shortlab/2024-RadCor-Pb-316/TEM/Phase boundary linescan/Project 2_phase boundary/CO_phase boundary/Line Sum Spectrum.tiff

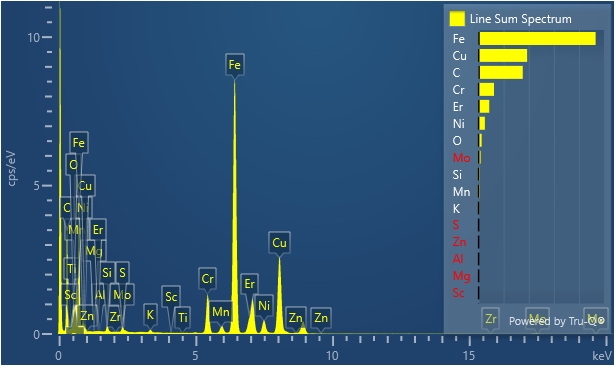
TEM/Phase boundary linescan/Project 2_phase boundary/CO_phase boundary/Line Sum Spectrum.tiff
