shortlab/2024-RadCor-Pb-316/README.md

# 2024-RadCor-Pb-316
Data and image repository for first paper about radiation/corrosion in liquid lead

Software versions used are cited in the manuscript file.
