shortlab/2024-RadCor-Pb-316/EBSD/2.pptx

Phase 4 – Re-Repolished, Re-Recoated and Stored in vacuum

- Sample 1201 02.10.23 Site1:

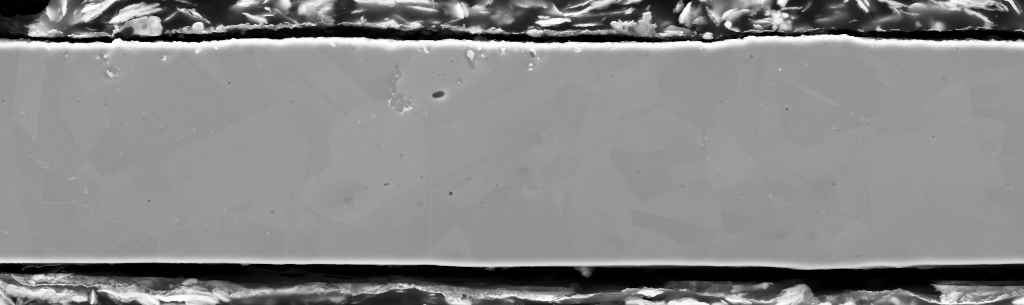
[picture p3: figure]
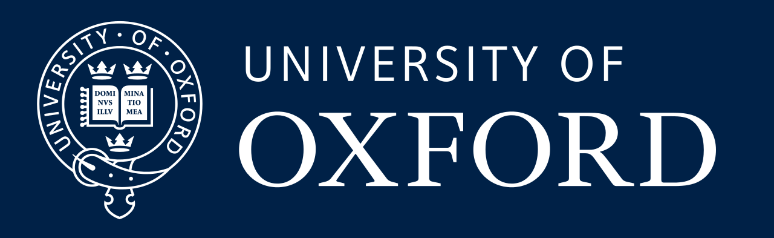
[picture p4: figure]
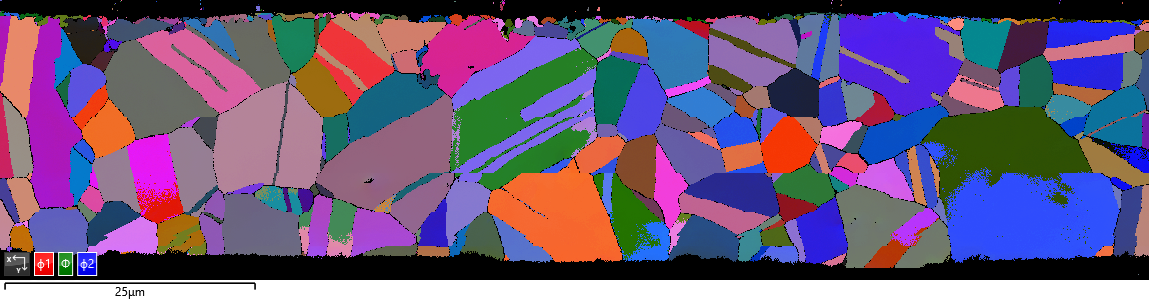
[picture p5: figure]
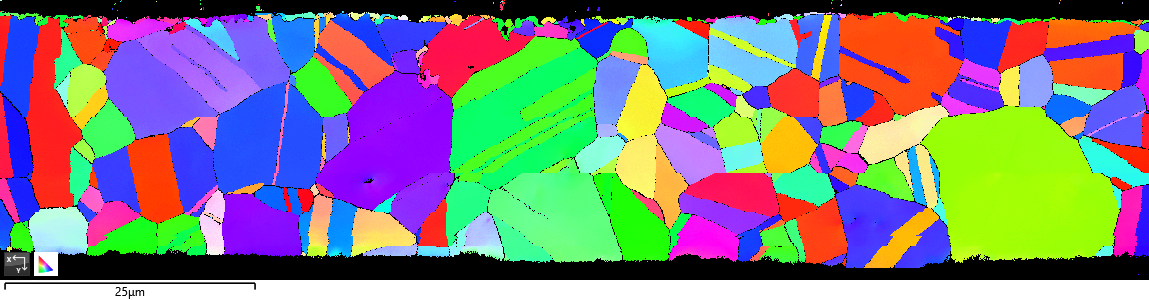
[picture p6: figure]
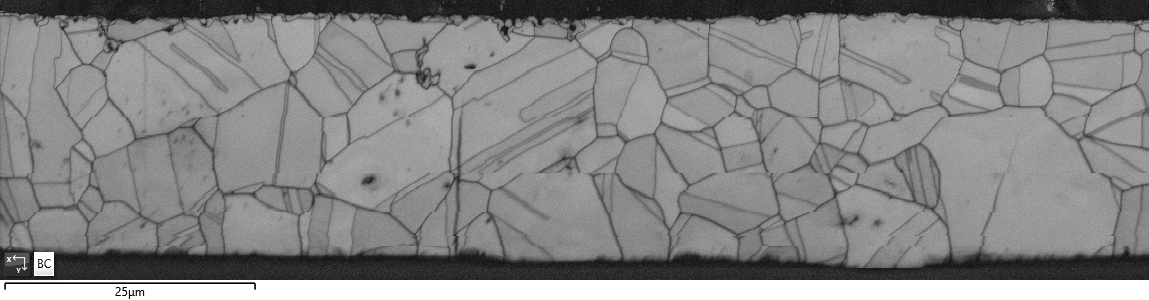
[picture p7: figure]
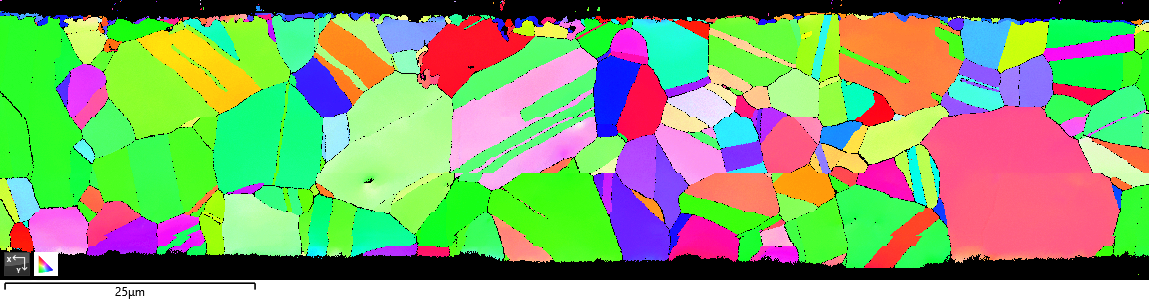
[picture p8: figure]
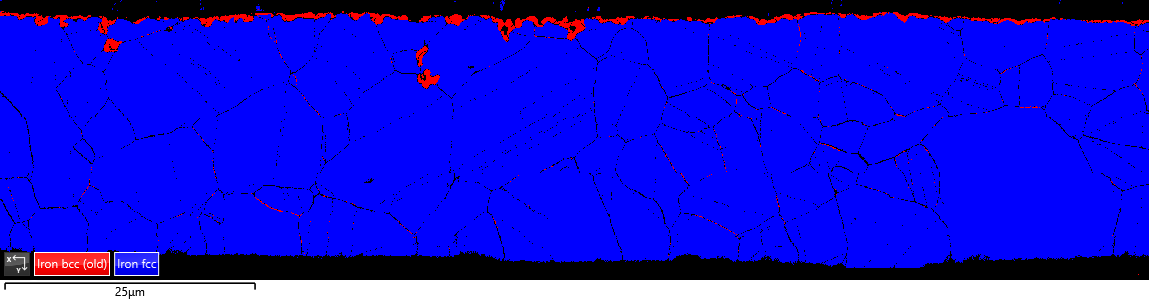
[picture p9: figure]
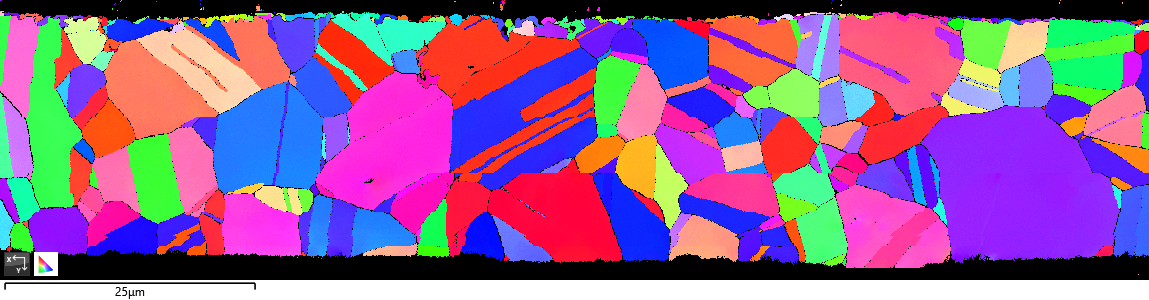
[picture p10: figure]
