shortlab/2024-RadCor-Pb-316/TEM/Maps/RAC/More details.docx

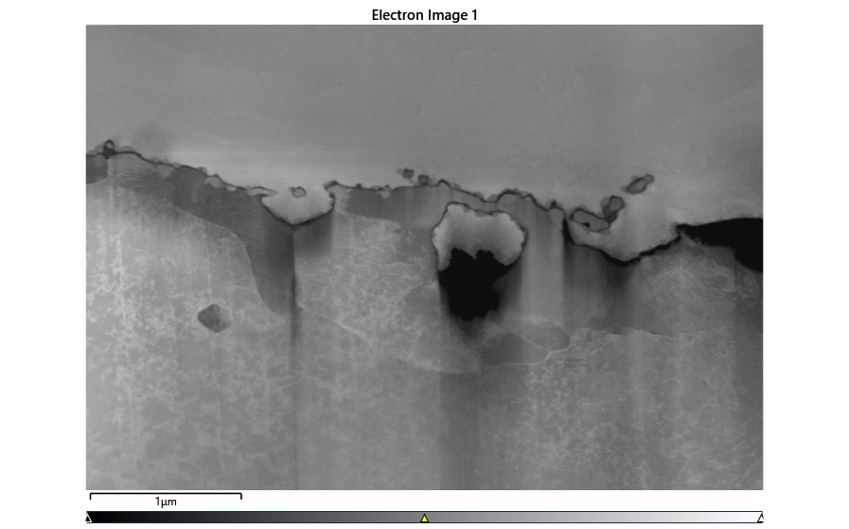
[picture p27: figure]
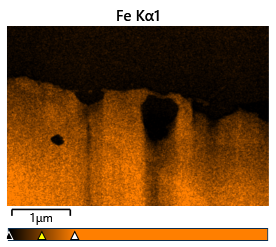
[picture p28: figure]
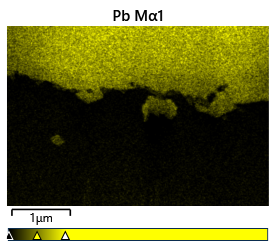
[picture p29: figure]
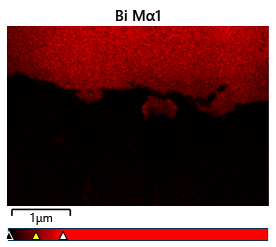
[picture p30: figure]
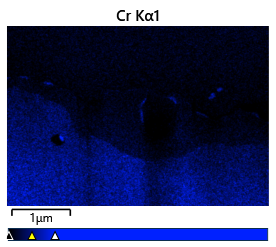
[picture p31: figure]
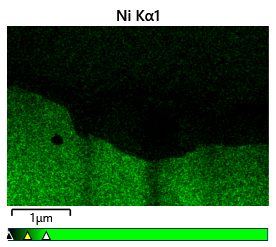
[picture p32: figure]
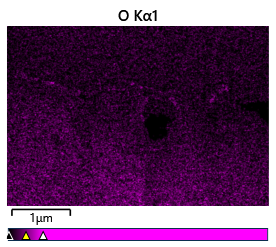
[picture p33: figure]
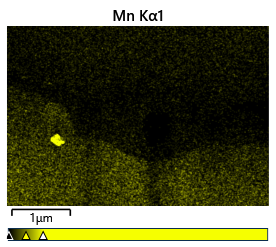
[picture p34: figure]
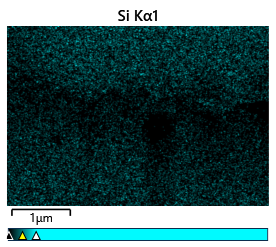
[picture p35: figure]
