shortlab/2024-RadCor-Pb-316/TEM/Maps/RAC/Project 1_Site 1_2024-02-25_21-24-29.docx

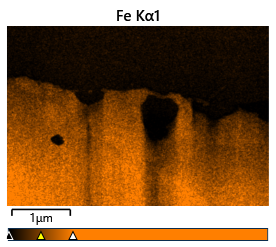
[picture p36: figure]
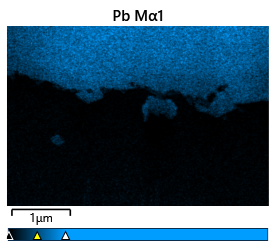
[picture p37: figure]
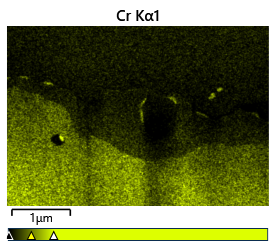
[picture p38: figure]
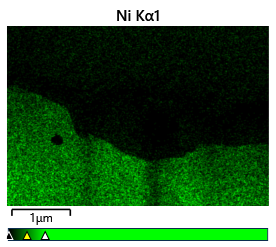
[picture p39: figure]
