shortlab/2024-RadCor-Pb-316/Surface SEM/4hours/CO_/zoomin/Project 1_Site 9_2023-10-23_21-54-53.docx

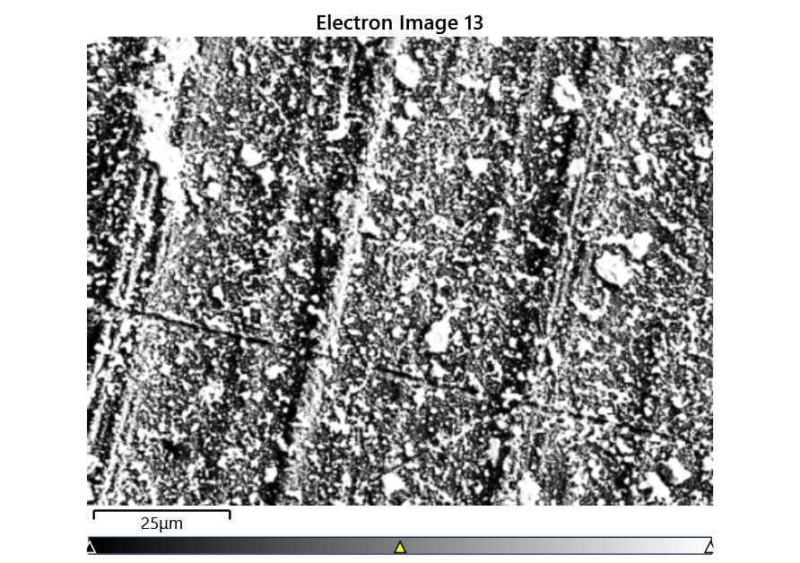
[picture p40: figure]
TemplateImage
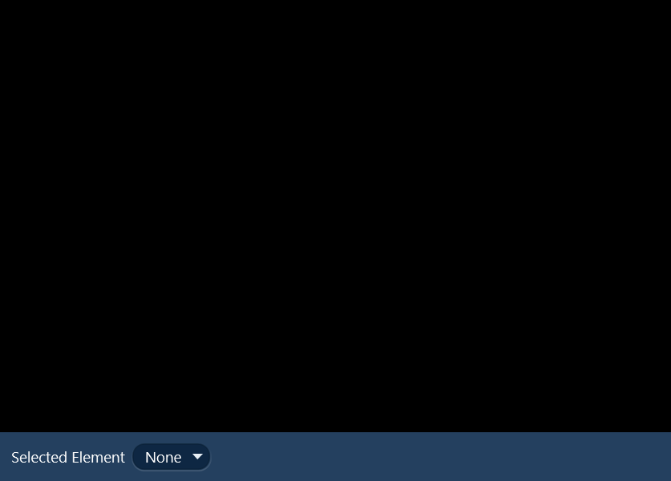
[picture p41: figure]
TemplateImage
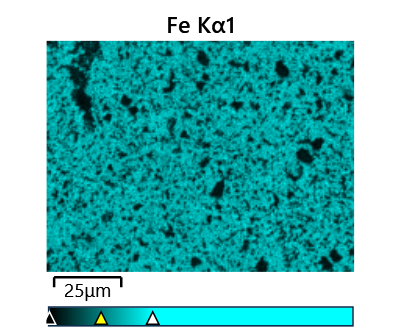
[picture p42: figure]
TemplateImage
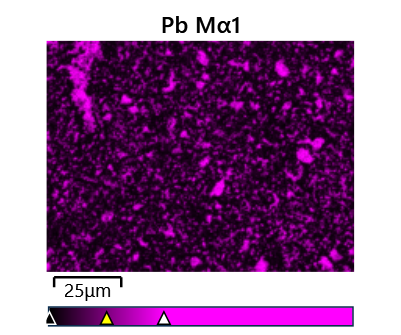
[picture p43: figure]
TemplateImage
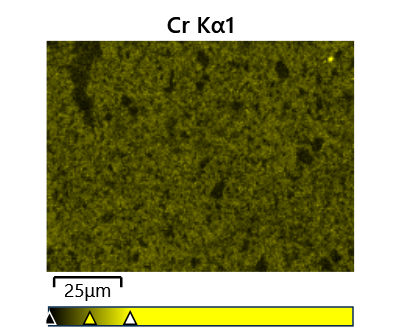
[picture p44: figure]
TemplateImage
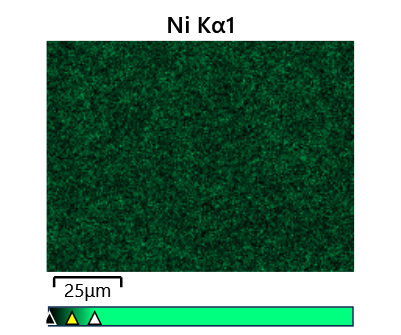
[picture p45: figure]
TemplateImage
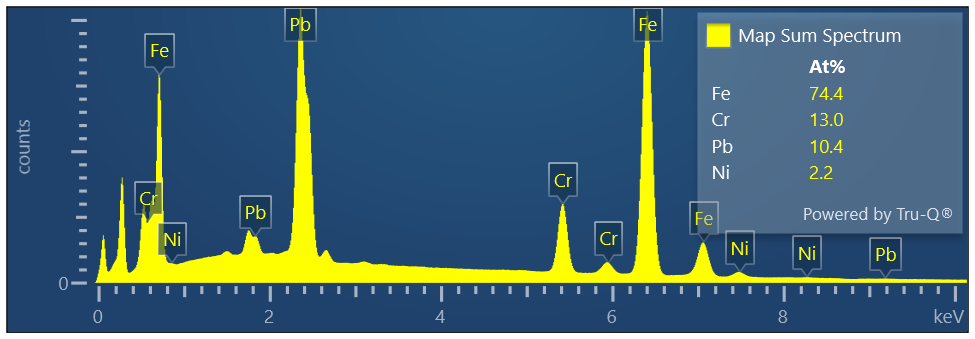
[picture p46: figure]
TemplateImage

Map Sum Spectrum

Element Signal Weight % σ

Fe 58.43 0.05

Pb 30.24 0.05

Cr 9.47 0.02

Ni 1.85 0.03

Map Sum Spectrum

Element Signal Atomic % σ

Fe 74.42

Cr 12.96

Pb 10.38

Ni 2.24
