shortlab/2024-RadCor-Pb-316/Surface SEM/4hours/CO_/zoomout/Project 1_Site 7_2023-10-23_21-45-00.docx

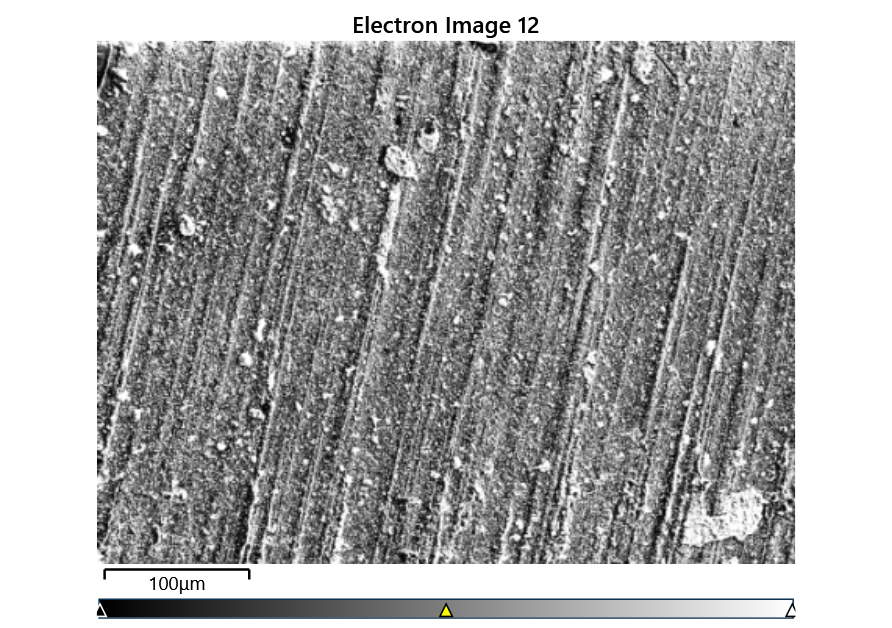
[picture p47: figure]
TemplateImage
TemplateImage
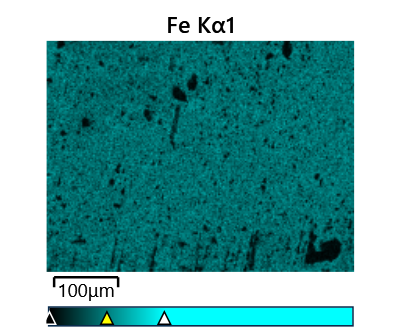
[picture p48: figure]
TemplateImage
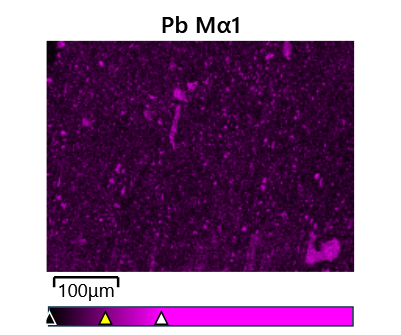
[picture p49: figure]
TemplateImage
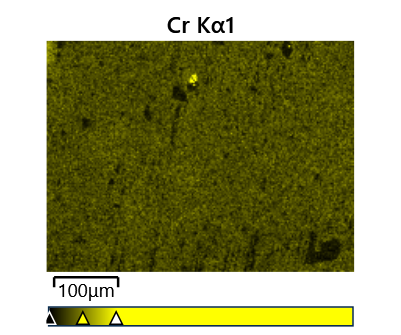
[picture p50: figure]
TemplateImage
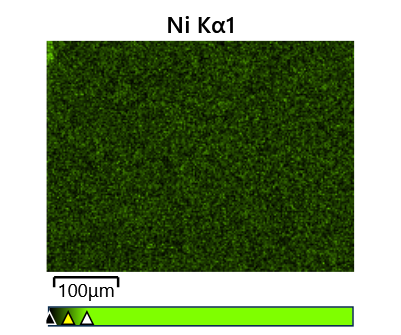
[picture p51: figure]
TemplateImage
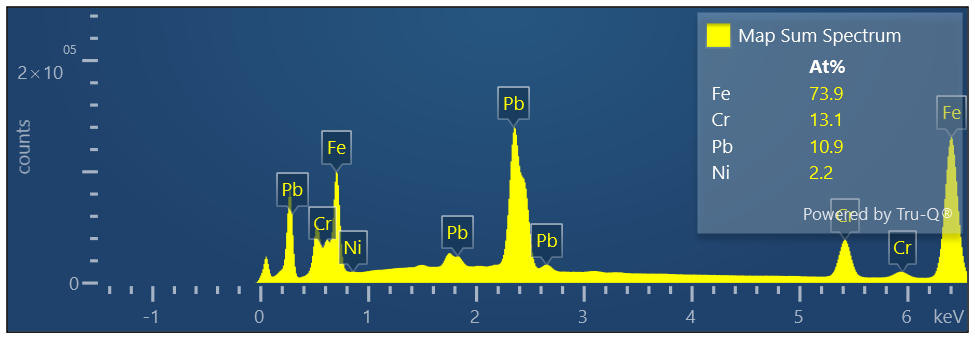
[picture p52: figure]
TemplateImage

Map Sum Spectrum

Element Signal Weight % σ

Fe 57.43 0.06

Pb 31.31 0.06

Cr 9.45 0.03

Ni 1.81 0.03

Map Sum Spectrum

Element Signal Atomic % σ

Fe 73.87

Cr 13.06

Pb 10.86

Ni 2.21
