shortlab/2024-RadCor-Pb-316/Surface SEM/4hours/RAC_/zoomin_/Project 1_Site 8_2023-10-23_21-31-37.docx

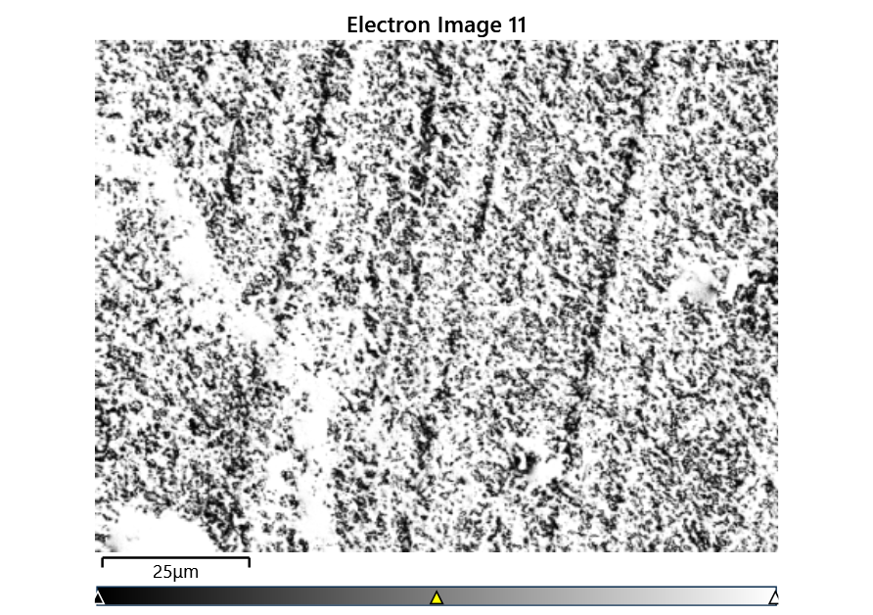
[picture p53: figure]
TemplateImage
TemplateImage
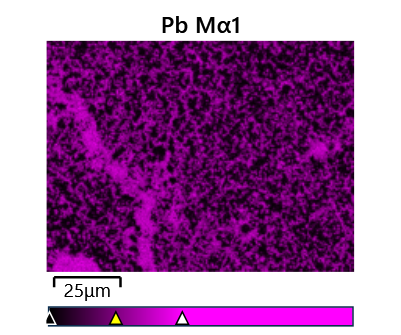
[picture p54: figure]
TemplateImage
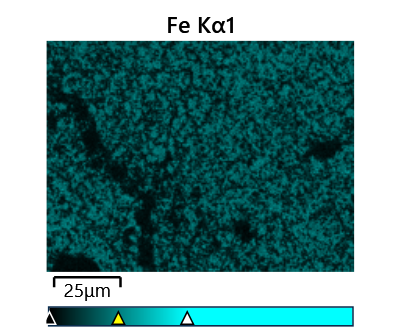
[picture p55: figure]
TemplateImage
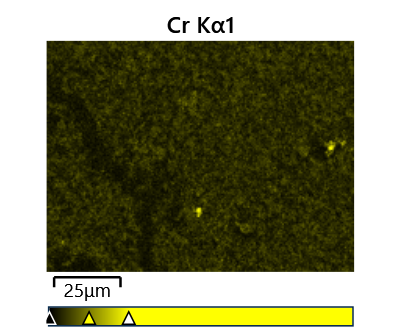
[picture p56: figure]
TemplateImage
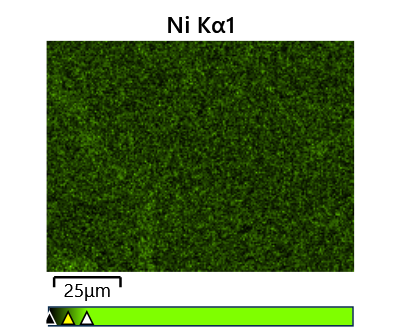
[picture p57: figure]
TemplateImage
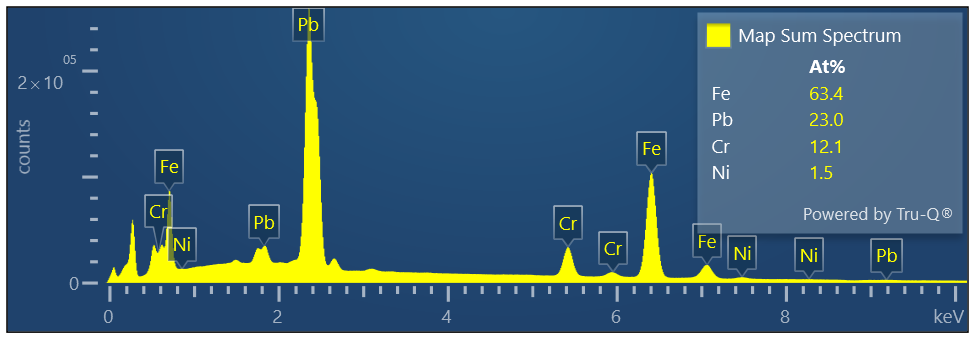
[picture p58: figure]
TemplateImage

Map Sum Spectrum

Element Signal Weight % σ

Pb 52.81 0.05

Fe 39.25 0.05

Cr 6.98 0.02

Ni 0.96 0.03

Map Sum Spectrum

Element Signal Atomic % σ

Fe 63.41

Pb 23.00

Cr 12.11

Ni 1.47
