shortlab/2024-RadCor-Pb-316/Surface SEM/8hours/CO_/zoomin/Project 1_Site 4_2023-10-23_20-40-44.docx

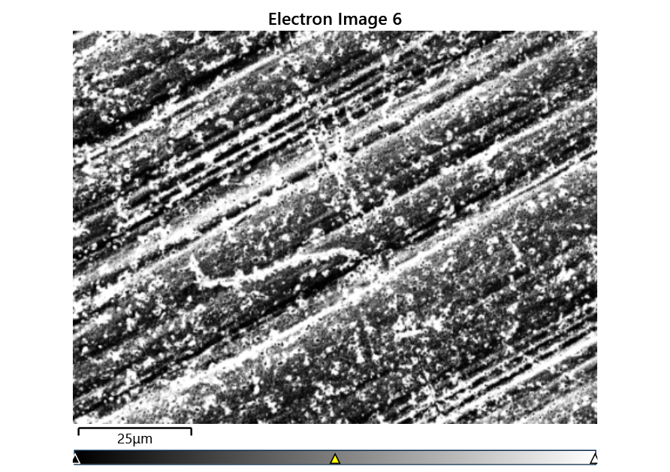
[picture p59: figure]
TemplateImage
TemplateImage
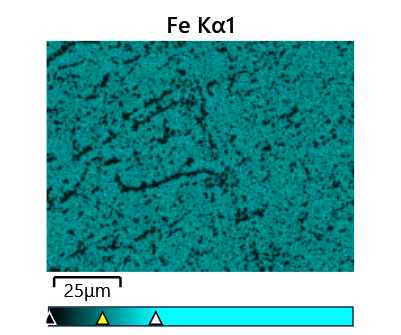
[picture p60: figure]
TemplateImage
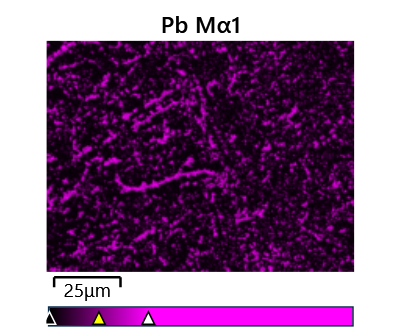
[picture p61: figure]
TemplateImage
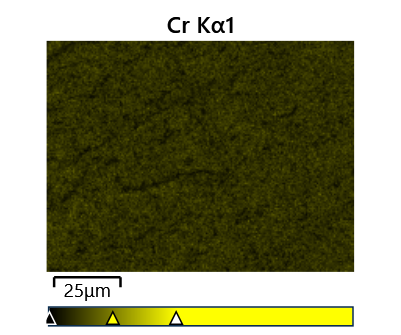
[picture p62: figure]
TemplateImage
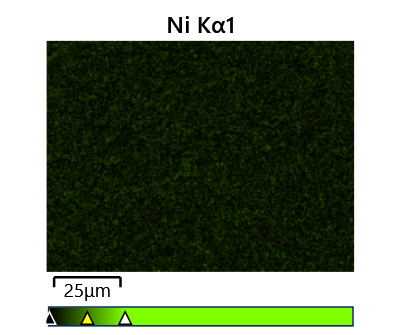
[picture p63: figure]
TemplateImage
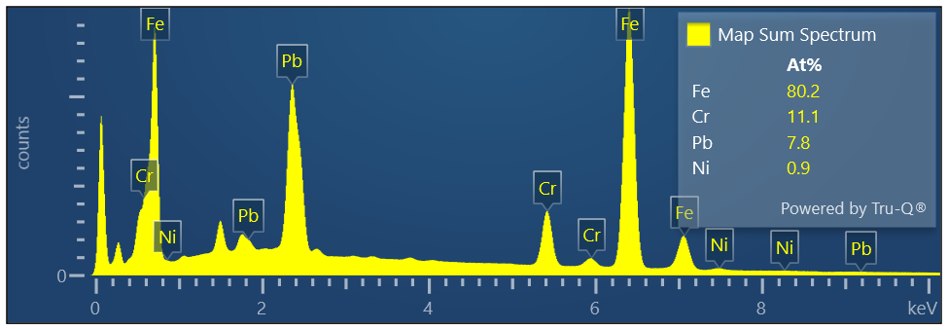
[picture p64: figure]
TemplateImage

Map Sum Spectrum

Element Signal Weight % σ

Fe 66.63 0.06

Pb 23.97 0.05

Cr 8.59 0.03

Ni 0.81 0.03

Map Sum Spectrum

Element Signal Atomic % σ

Fe 80.19

Cr 11.10

Pb 7.77

Ni 0.93
