shortlab/2024-RadCor-Pb-316/Surface SEM/8hours/CO_/zoomout/Project 1_Site 3_2023-10-23_20-37-22.docx

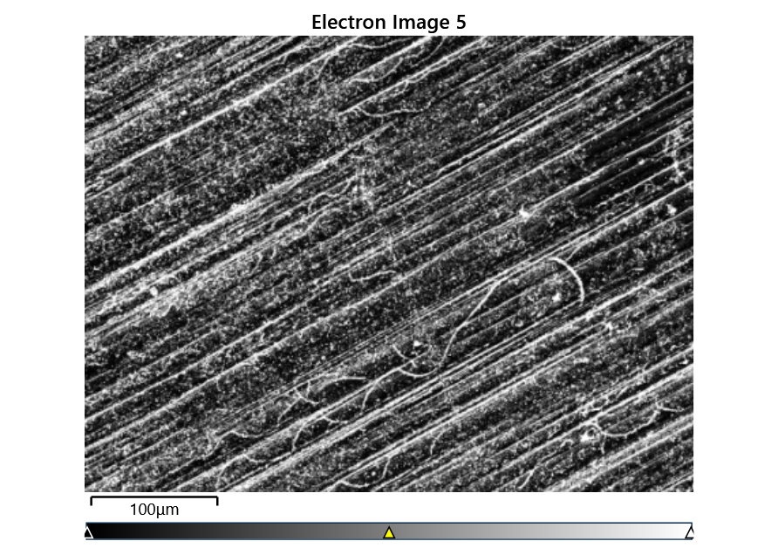
[picture p65: figure]
TemplateImage
TemplateImage
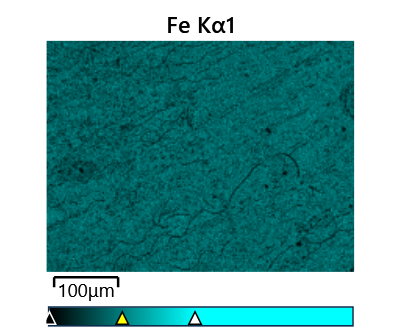
[picture p66: figure]
TemplateImage
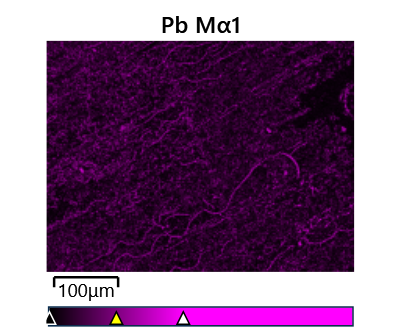
[picture p67: figure]
TemplateImage
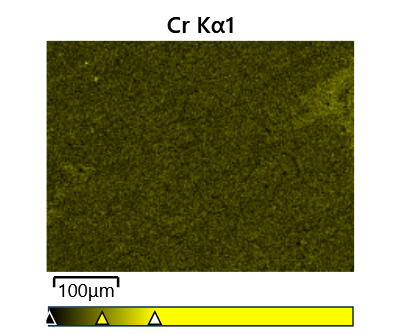
[picture p68: figure]
TemplateImage
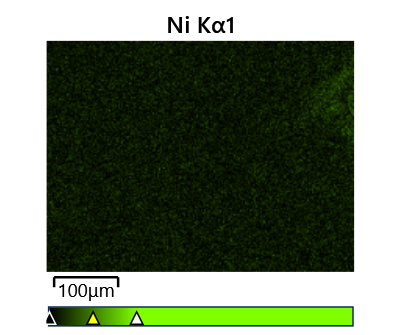
[picture p69: figure]
TemplateImage
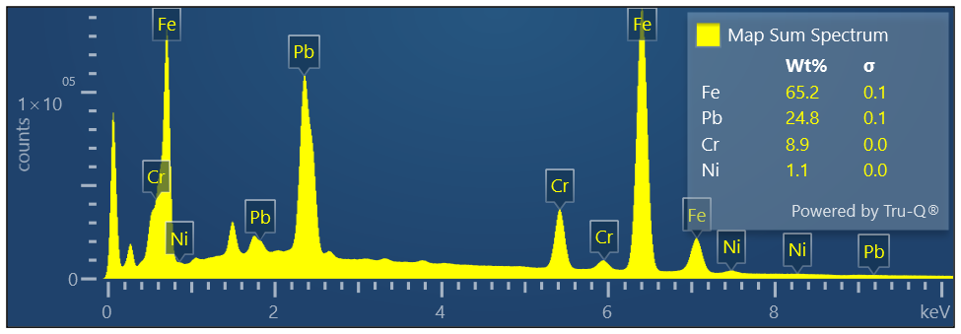
[picture p70: figure]
TemplateImage

Map Sum Spectrum

Element Signal Weight % σ

Fe 65.16 0.06

Pb 24.80 0.05

Cr 8.93 0.03

Ni 1.10 0.03

Map Sum Spectrum

Element Signal Atomic % σ

Fe 78.99

Cr 11.63

Pb 8.10

Ni 1.27
