shortlab/2024-RadCor-Pb-316/Surface SEM/8hours/RAC_/zoomin/Project 1_Site 2_2023-10-23_20-33-59.docx

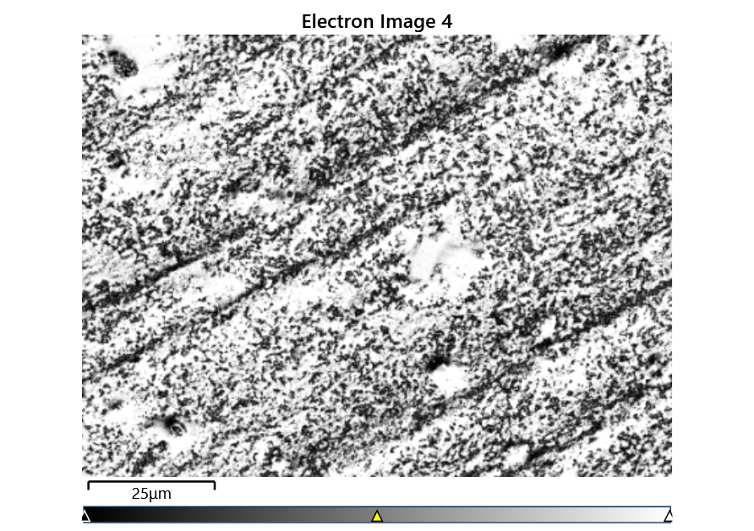
[picture p71: figure]
TemplateImage
TemplateImage
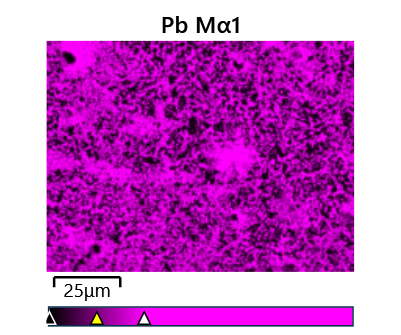
[picture p72: figure]
TemplateImage
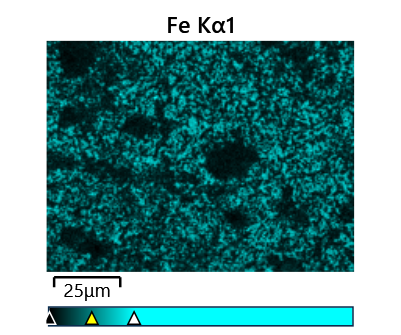
[picture p73: figure]
TemplateImage
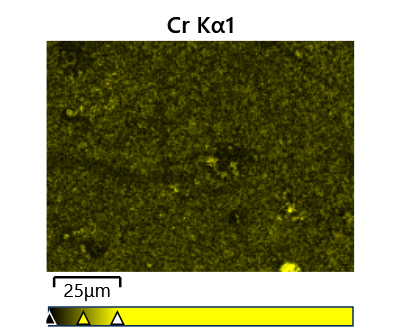
[picture p74: figure]
TemplateImage
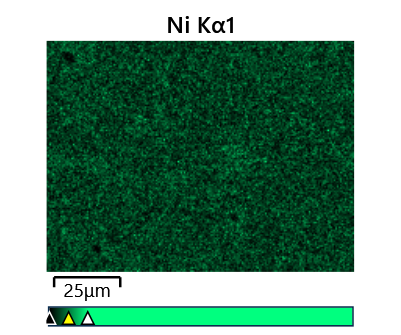
[picture p75: figure]
TemplateImage
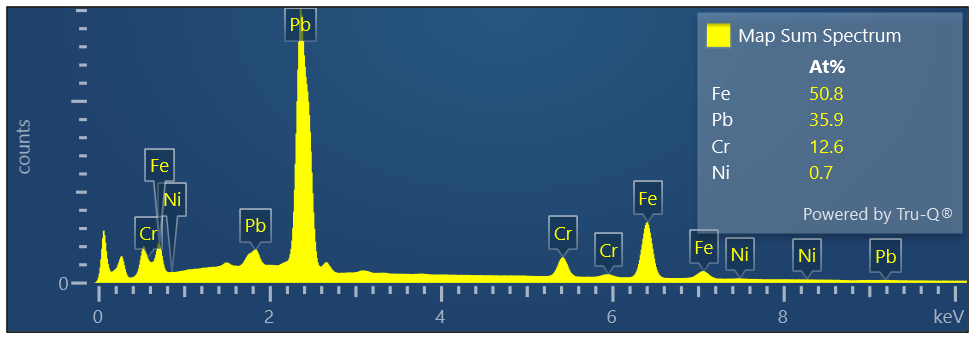
[picture p76: figure]
TemplateImage

Map Sum Spectrum

Element Signal Weight % σ

Pb 67.81 0.05

Fe 25.84 0.04

Cr 5.99 0.02

Ni 0.37 0.03

Map Sum Spectrum

Element Signal Atomic % σ

Fe 50.77

Pb 35.91

Cr 12.63

Ni 0.69
