shortlab/2024-RadCor-Pb-316/Surface SEM/8hours/RAC_/zoomout_1/Project 1_Site 1_2023-10-23_20-28-32.docx

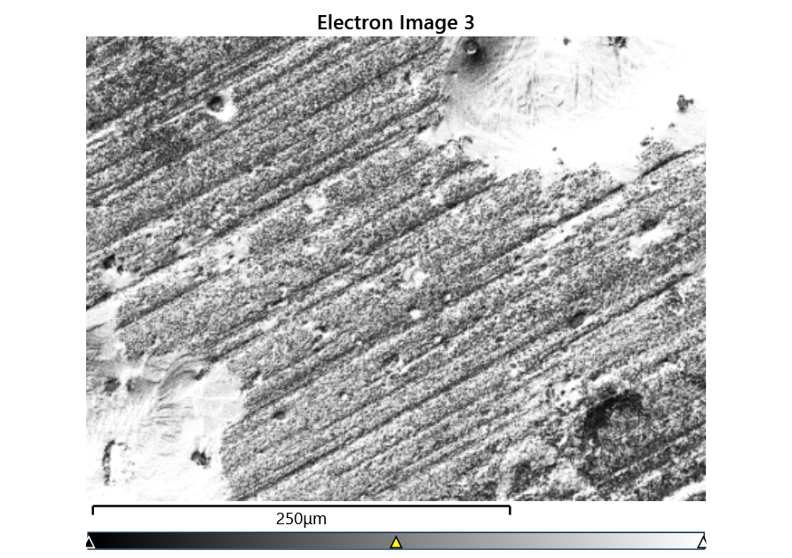
[picture p77: figure]
TemplateImage
TemplateImage
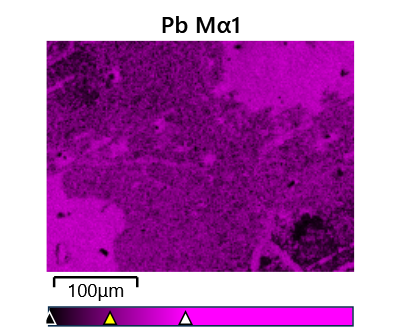
[picture p78: figure]
TemplateImage
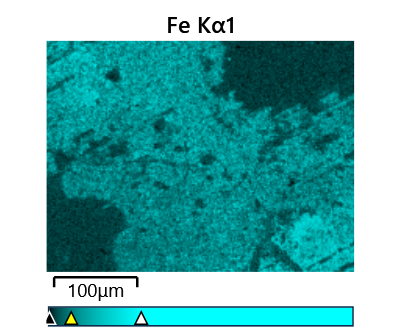
[picture p79: figure]
TemplateImage
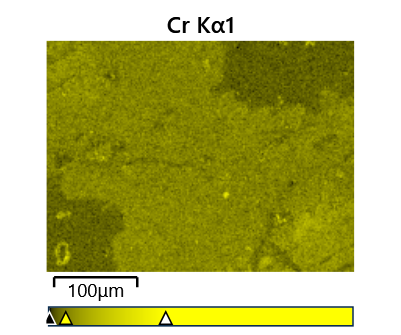
[picture p80: figure]
TemplateImage
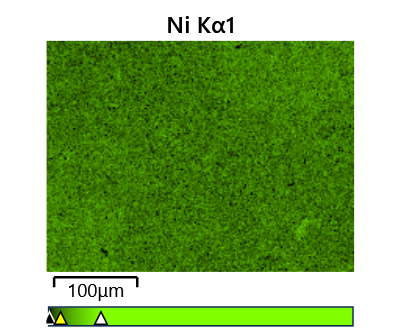
[picture p81: figure]
TemplateImage
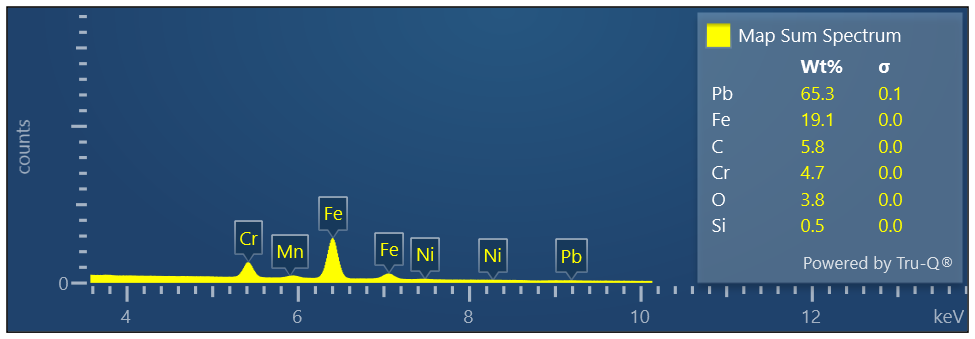
[picture p82: figure]
TemplateImage

Map Sum Spectrum

Element Signal Weight % σ

Pb 73.15 0.05

Fe 21.18 0.04

Cr 5.29 0.02

Ni 0.39 0.03

Map Sum Spectrum

Element Signal Atomic % σ

Fe 45.11

Pb 42.00

Cr 12.10

Ni 0.79
