shortlab/2024-RadCor-Pb-316/TEM/Phase boundary linescan/Project 2_phase boundary/CO_phase boundary/Project 2_Site 5_2023-11-08_15-19-05.docx

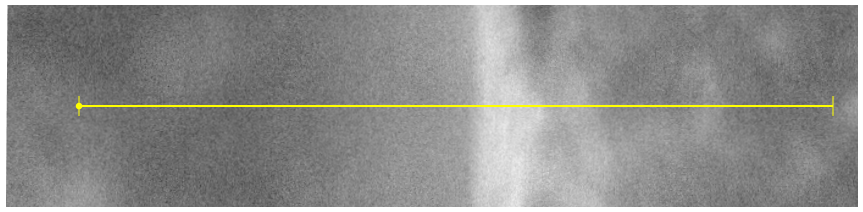
[picture p83: figure]
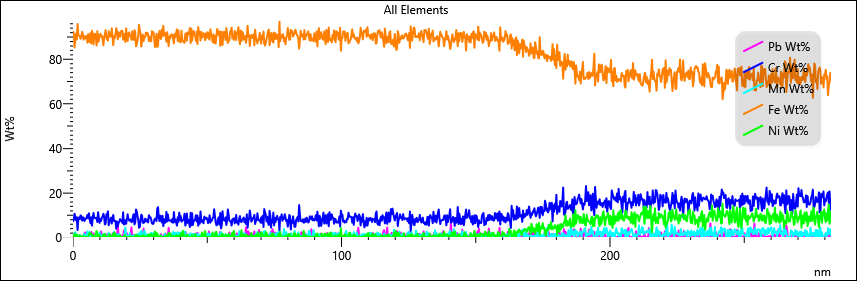
[picture p84: figure]
