shortlab/2024-RadCor-Pb-316/TEM/Phase boundary linescan/Project 2_phase boundary/RAC_phase boundary/1/Project 2_Site 1_2023-11-08_14-36-44.docx

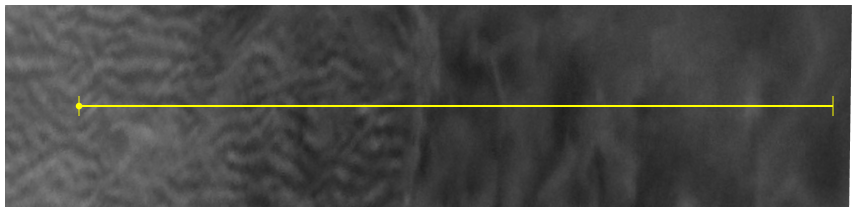
[picture p85: figure]
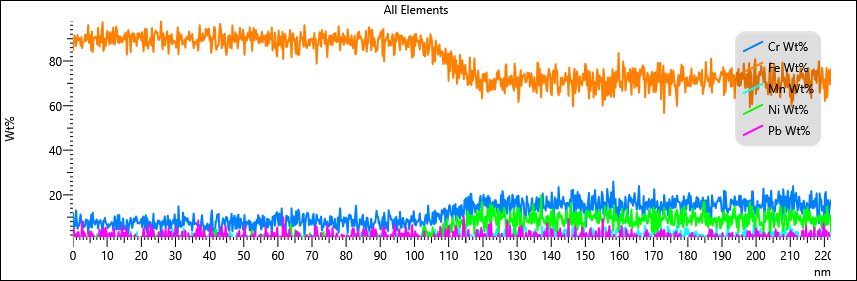
[picture p86: figure]
