shortlab/2024-RadCor-Pb-316/TEM/Phase boundary linescan/Project 2_phase boundary/RAC_phase boundary/2/Project 2_Site 2_2023-11-08_14-49-16.docx

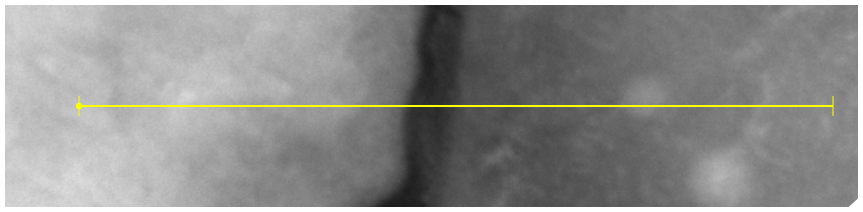
[picture p87: figure]
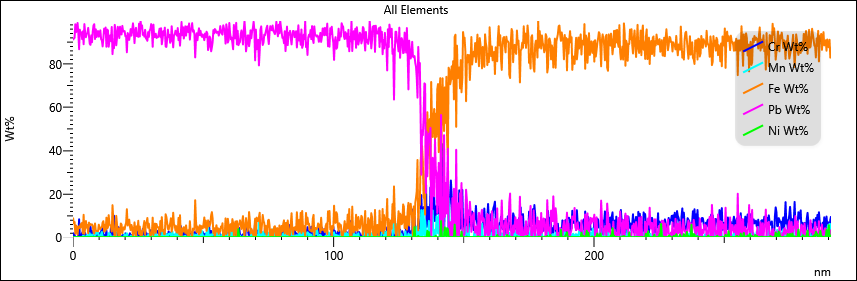
[picture p88: figure]
