shortlab/2024-RadCor-Pb-316/Surface SEM/4hours/CO_/CO_/EDX/CO/Project 1_Site 1_2024-03-19_11-43-02.docx

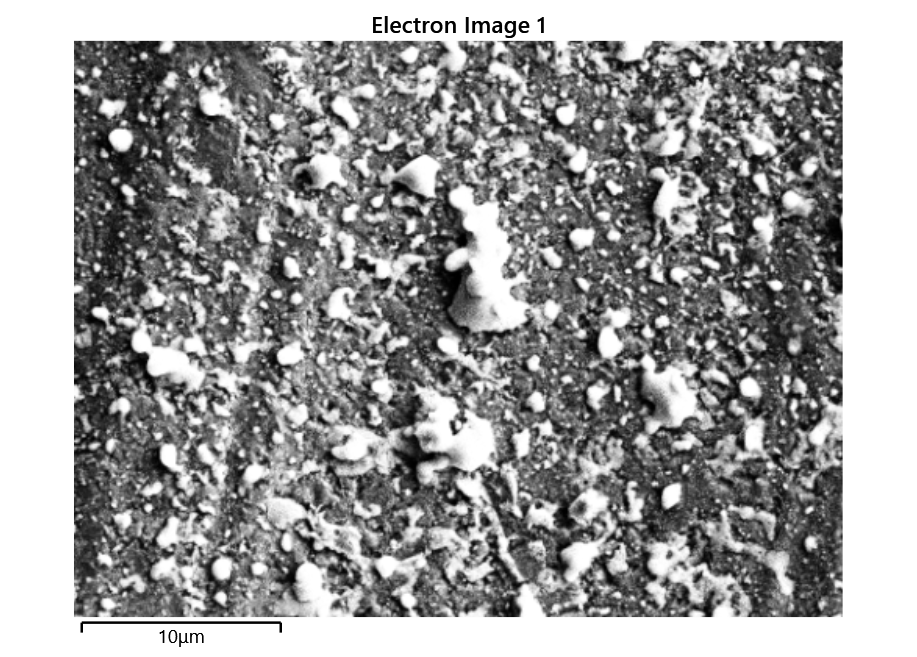
[picture p89: figure]
TemplateImage
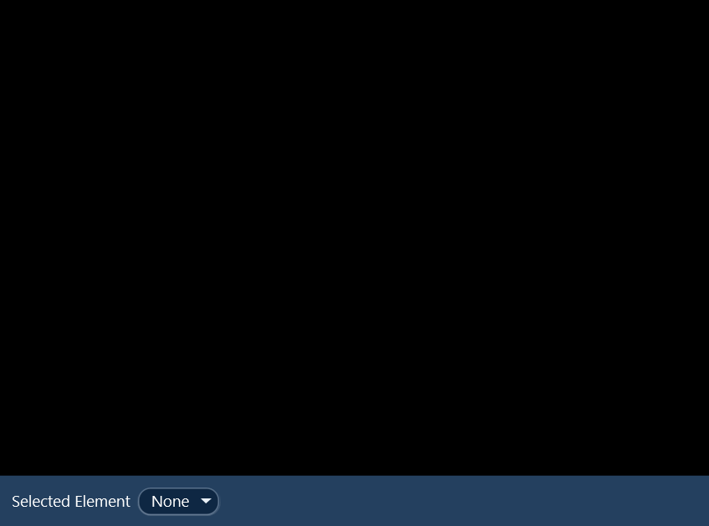
[picture p90: figure]
TemplateImage
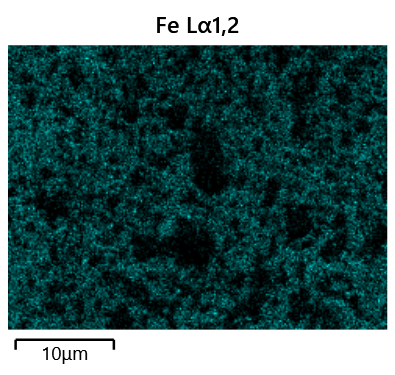
[picture p91: figure]
TemplateImage
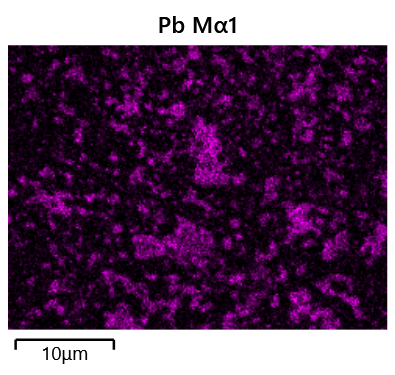
[picture p92: figure]
TemplateImage
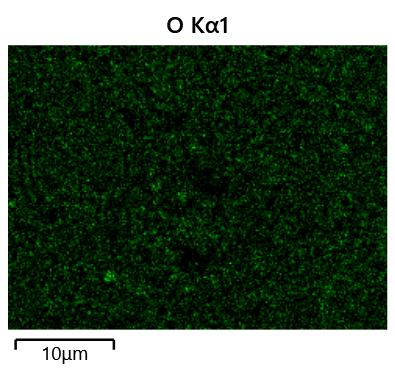
[picture p93: figure]
TemplateImage
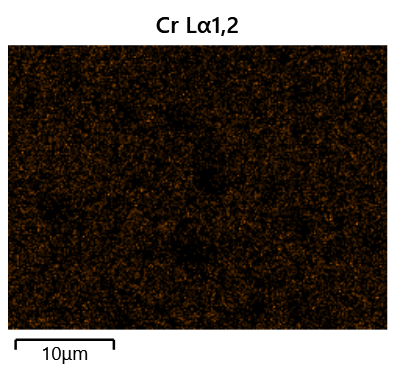
[picture p94: figure]
TemplateImage
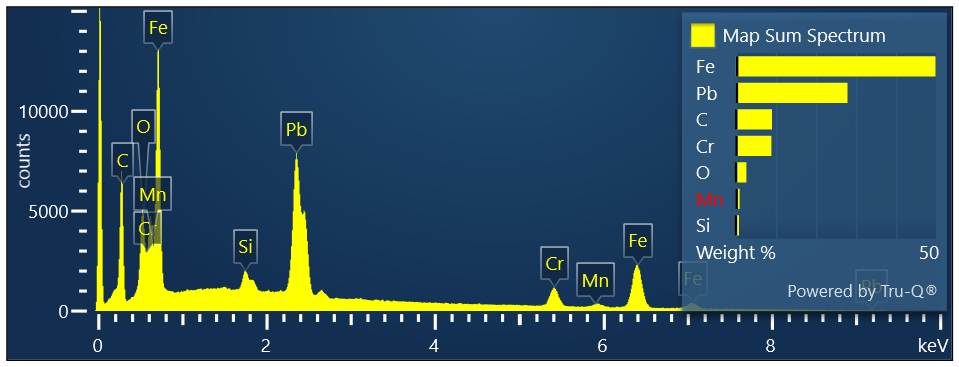
[picture p95: figure]
TemplateImage
