shortlab/2024-RadCor-Pb-316/Surface SEM/4hours/RAC_/RAC/EDX/CO_/Project 1_Site 2_2024-03-18_22-51-43.docx

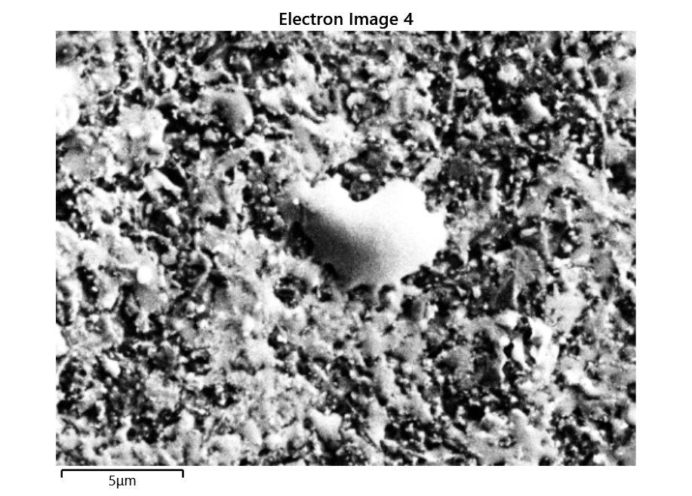
[picture p96: figure]
TemplateImage
TemplateImage
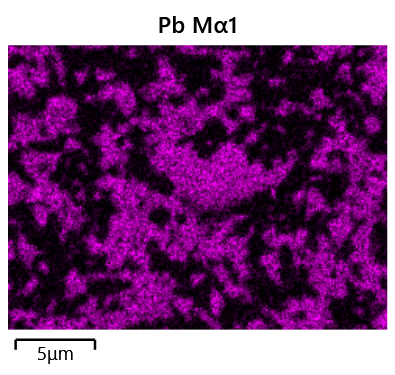
[picture p97: figure]
TemplateImage
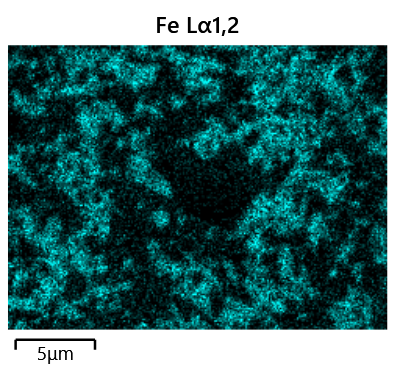
[picture p98: figure]
TemplateImage
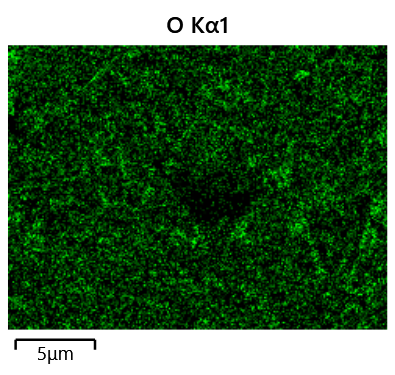
[picture p99: figure]
TemplateImage
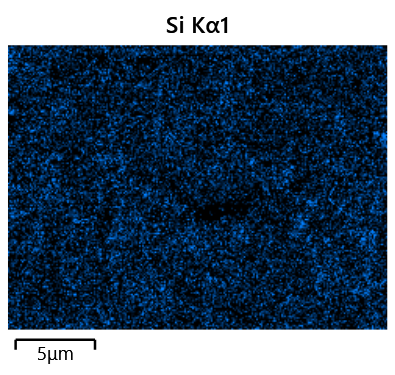
[picture p100: figure]
TemplateImage
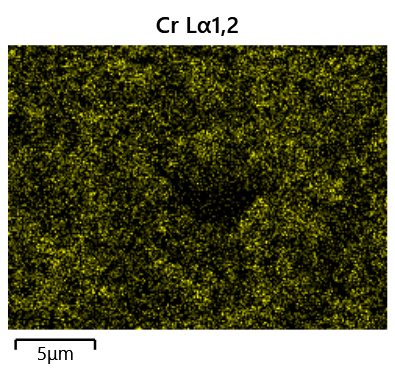
[picture p101: figure]
TemplateImage
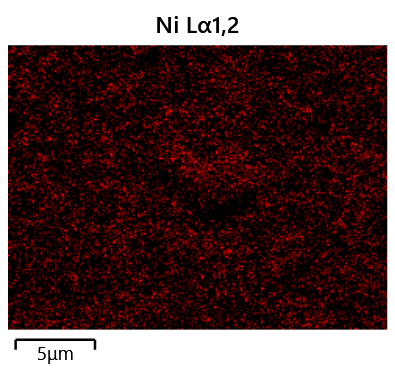
[picture p102: figure]
TemplateImage
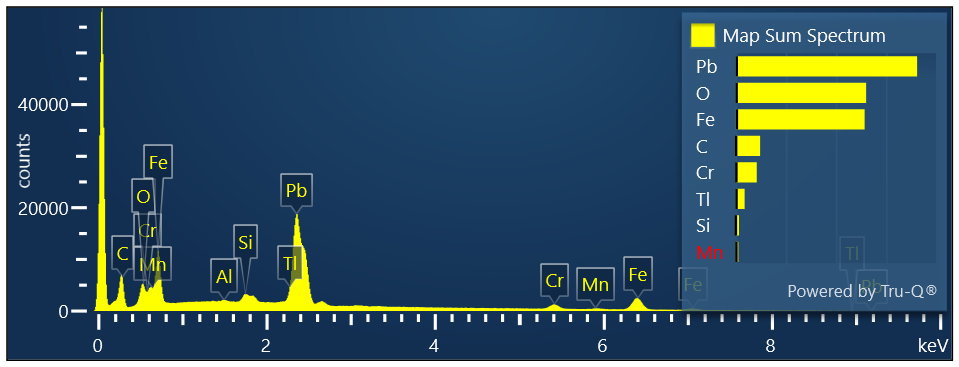
[picture p103: figure]
TemplateImage
