shortlab/2024-RadCor-Pb-316/Cross-section SEM and Fiji analysis/RAC 4hour_1#/CO/Fused_2.tif

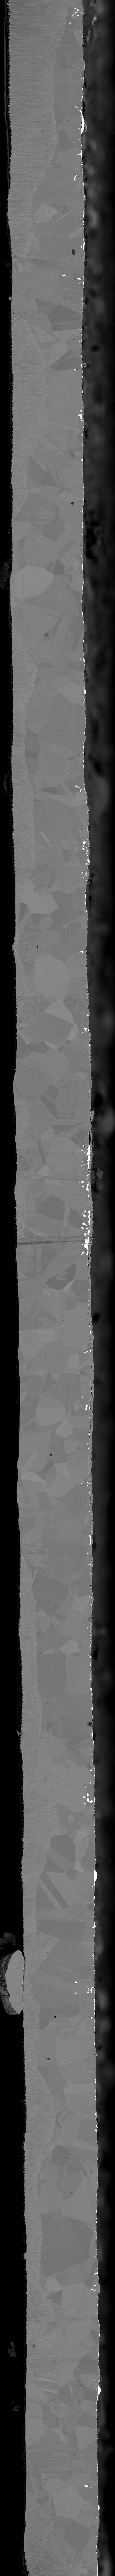
Cross-section SEM and Fiji analysis/RAC 4hour_1#/CO/Fused_2.tif
