shortlab/2024-RadCor-Pb-316/Cross-section SEM and Fiji analysis/RAC 4hour_2#/CO/Fused_1.tif

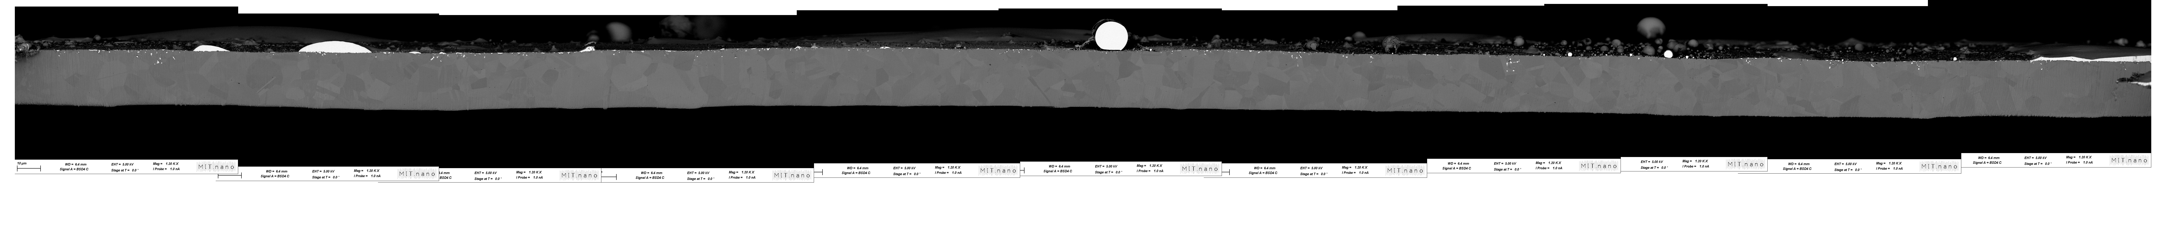
Cross-section SEM and Fiji analysis/RAC 4hour_2#/CO/Fused_1.tif
