shortlab/2024-RadCor-Pb-316/Cross-section SEM and Fiji analysis/RAC 4hour_3#/CO_/CO_CS_00.tif

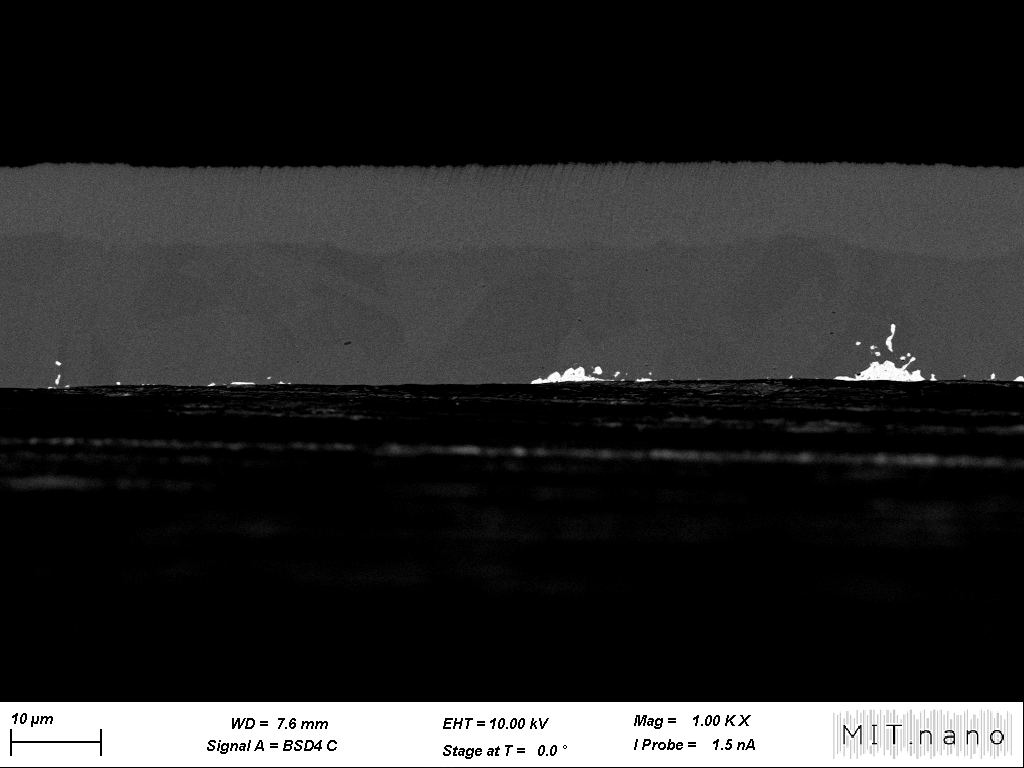
Cross-section SEM and Fiji analysis/RAC 4hour_3#/CO_/CO_CS_00.tif
