shortlab/2024-RadCor-Pb-316/Cross-section SEM and Fiji analysis/RAC 4hour_3#/RAC_/RAC_CS_03.tif

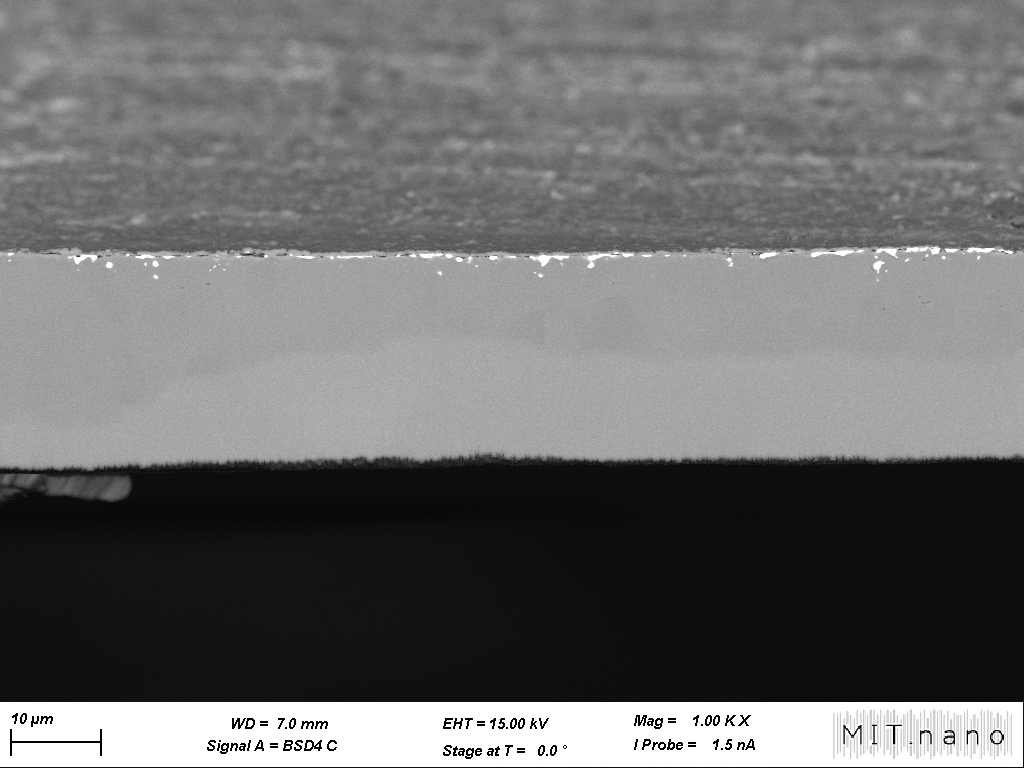
Cross-section SEM and Fiji analysis/RAC 4hour_3#/RAC_/RAC_CS_03.tif
