shortlab/2024-RadCor-Pb-316/Cross-section SEM and Fiji analysis/RAC 8hour/CO/Fused_analysis.tif

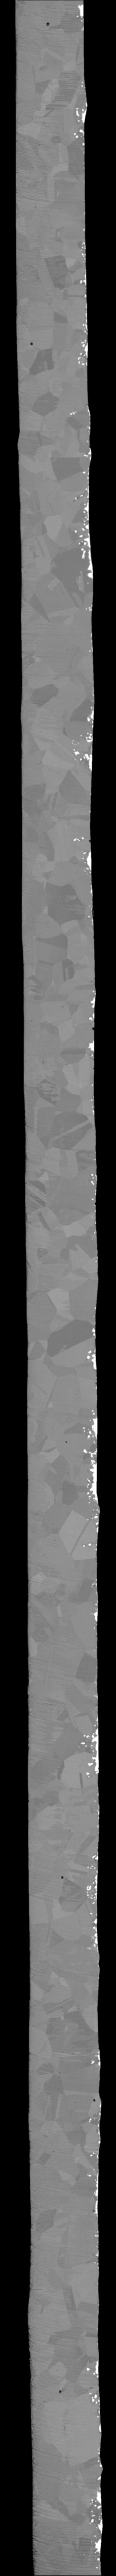
Cross-section SEM and Fiji analysis/RAC 8hour/CO/Fused_analysis.tif
