shortlab/2024-RadCor-Pb-316/Cross-section SEM and Fiji analysis/RAC 8hour/RAC/Fused_1.tif

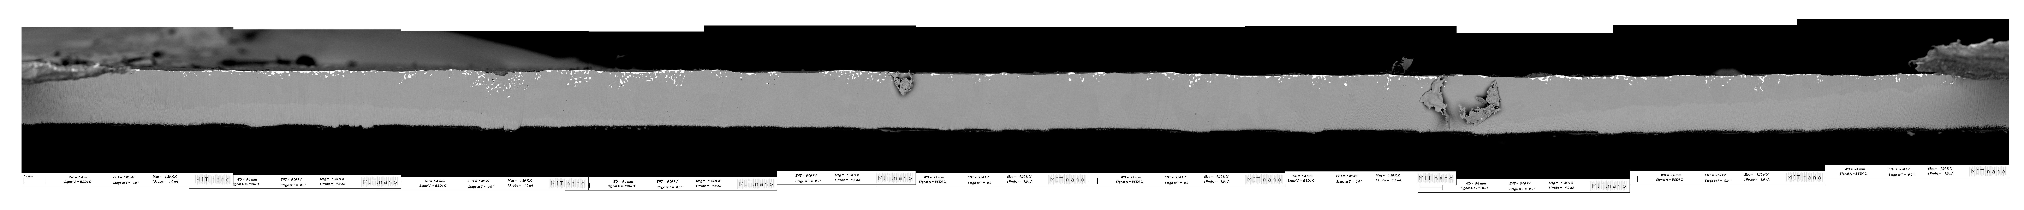
Cross-section SEM and Fiji analysis/RAC 8hour/RAC/Fused_1.tif
