shortlab/2024-RadCor-Pb-316/Surface SEM/4hours/CO_/CO_/CO/CO_09.tif

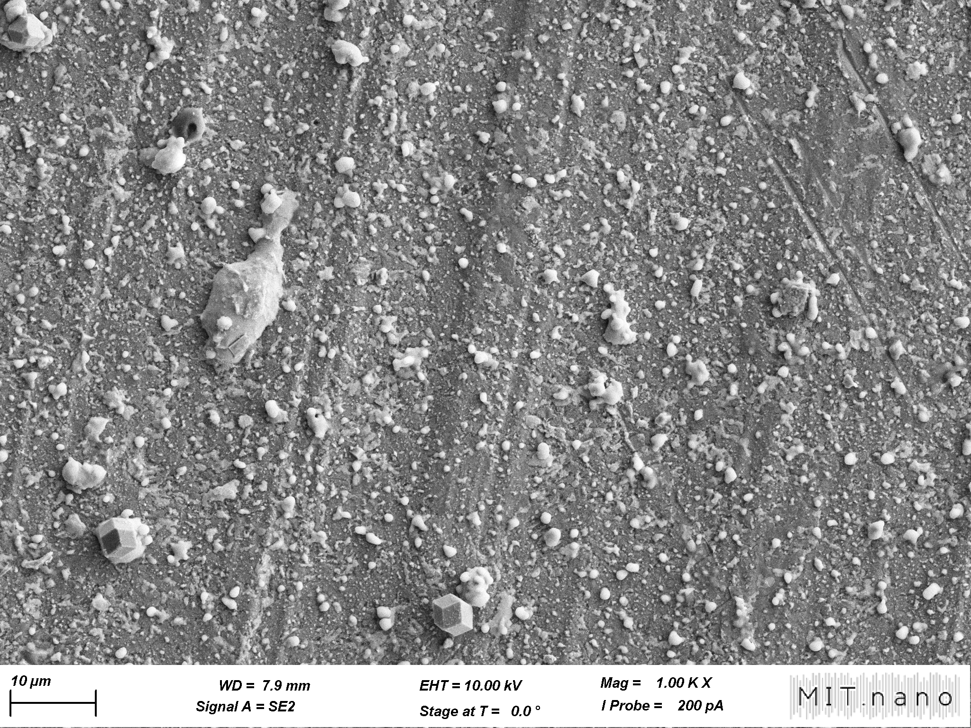
Surface SEM/4hours/CO_/CO_/CO/CO_09.tif
