shortlab/2024-RadCor-Pb-316/Surface SEM/4hours/CO_/CO_/EDX/CO/Electron Image 1.tiff

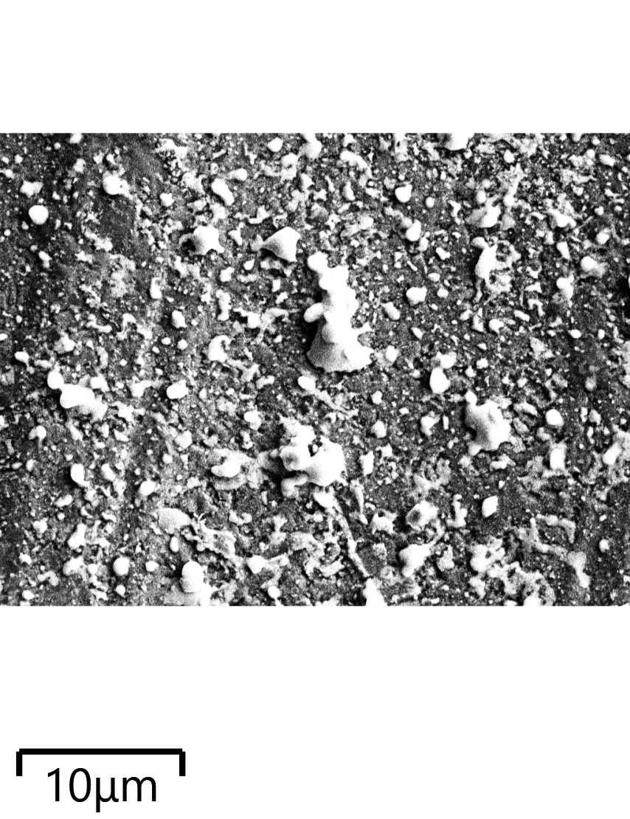
Surface SEM/4hours/CO_/CO_/EDX/CO/Electron Image 1.tiff
