shortlab/2024-RadCor-Pb-316/Surface SEM/4hours/CO_/CO_/EDX/CO/O Kα1 Map Data 1.tif

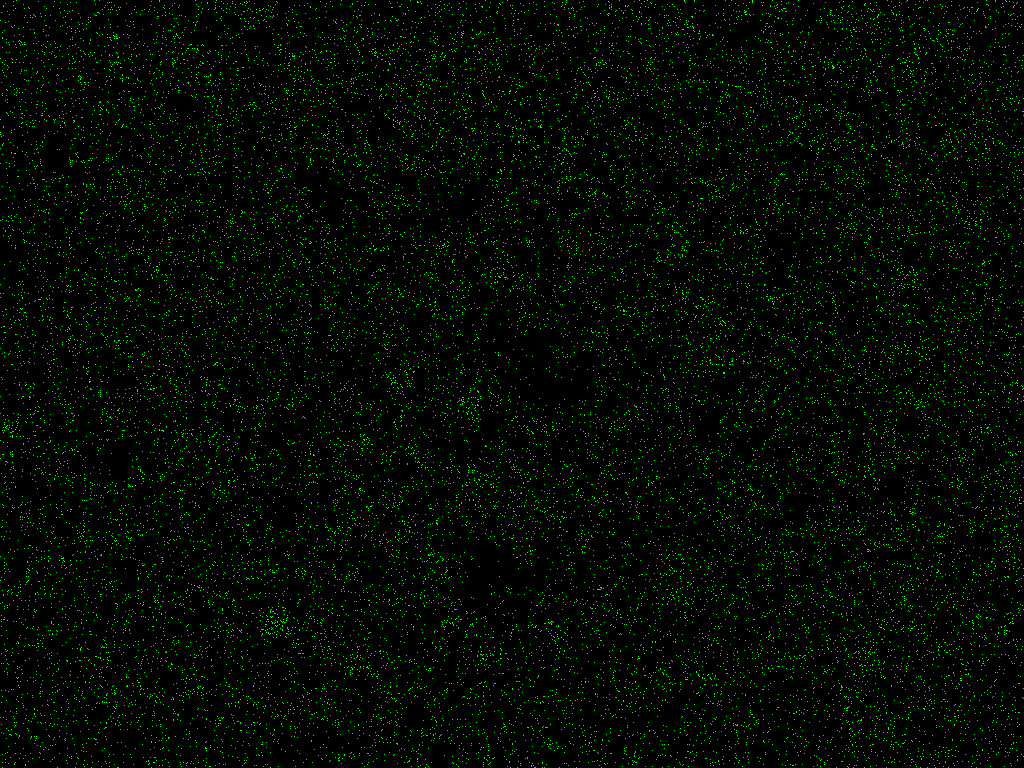
Surface SEM/4hours/CO_/CO_/EDX/CO/O Kα1 Map Data 1.tif
