shortlab/2024-RadCor-Pb-316/Surface SEM/4hours/CO_/CO_/EDX/CO/Pb Mα1 Map Data 1 - Copy.tif

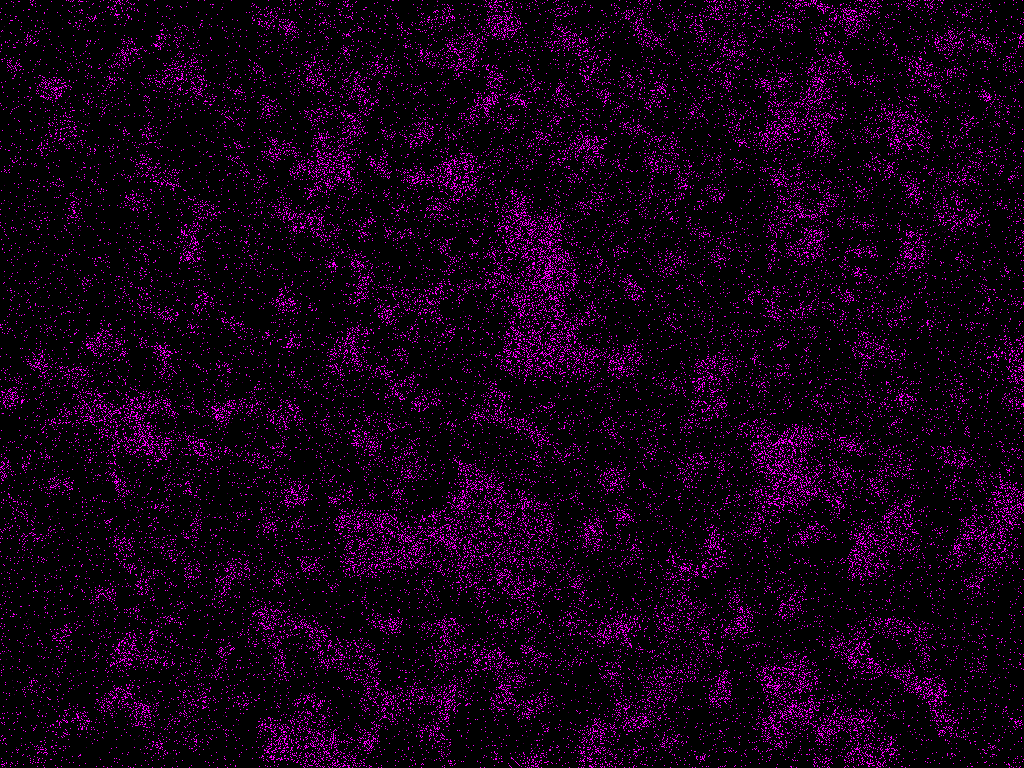
Surface SEM/4hours/CO_/CO_/EDX/CO/Pb Mα1 Map Data 1 - Copy.tif
