shortlab/2024-RadCor-Pb-316/Surface SEM/4hours/CO_/zoomin/1/Electron Image 13.tif

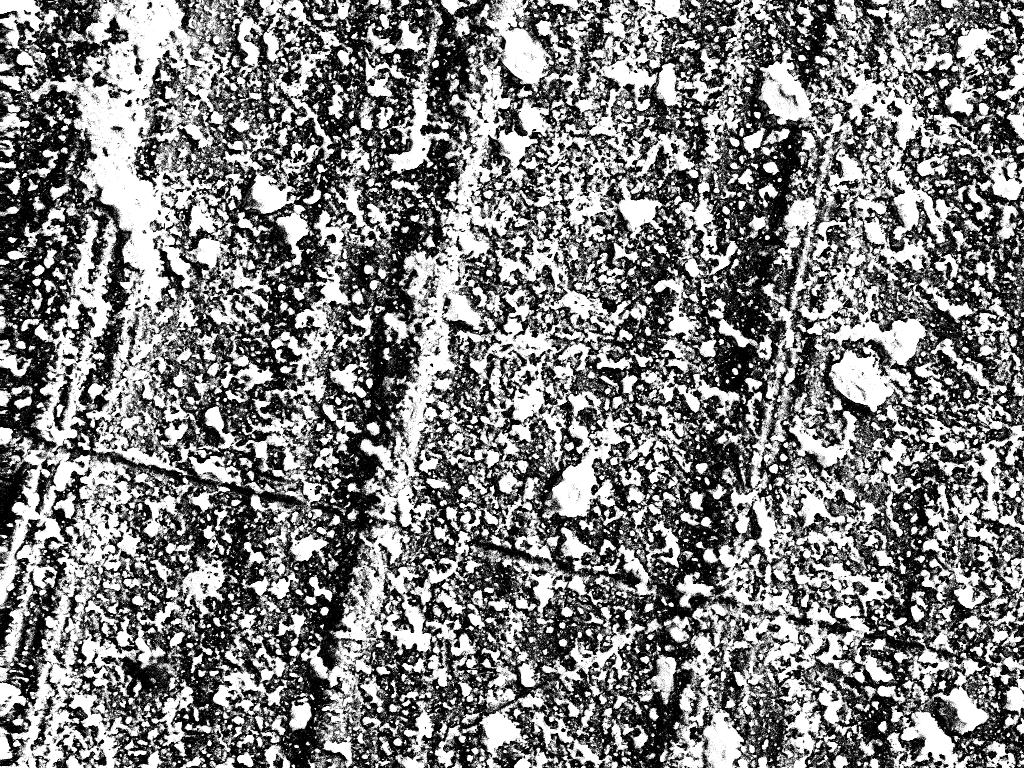
Surface SEM/4hours/CO_/zoomin/1/Electron Image 13.tif
