shortlab/2024-RadCor-Pb-316/Surface SEM/4hours/CO_/zoomin/1/Pb Mα1 Map Data 9.tif

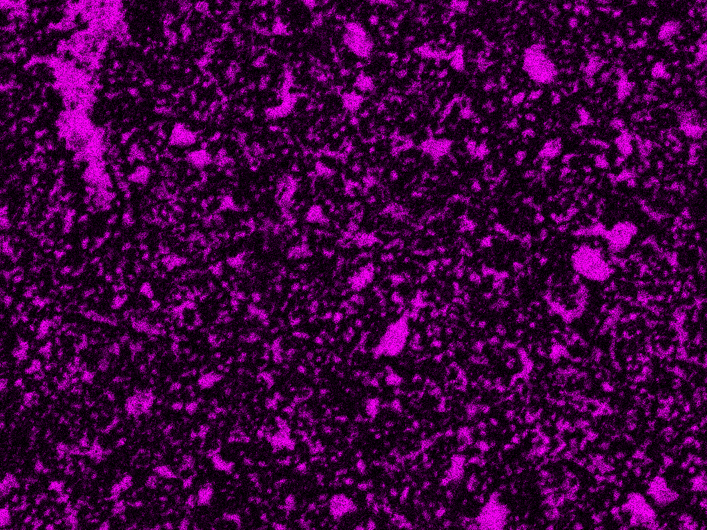
Surface SEM/4hours/CO_/zoomin/1/Pb Mα1 Map Data 9.tif
