shortlab/2024-RadCor-Pb-316/Surface SEM/4hours/CO_/zoomin/Cr Kα1.png

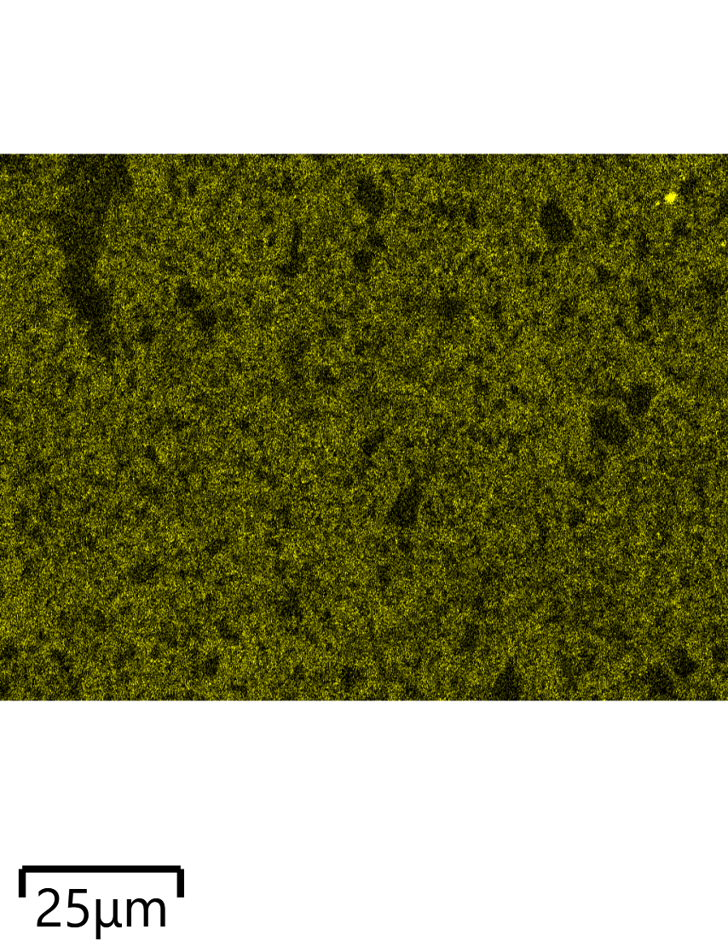
Surface SEM/4hours/CO_/zoomin/Cr Kα1.png
