shortlab/2024-RadCor-Pb-316/Surface SEM/4hours/CO_/zoomin/EDS Layered Image 9.png

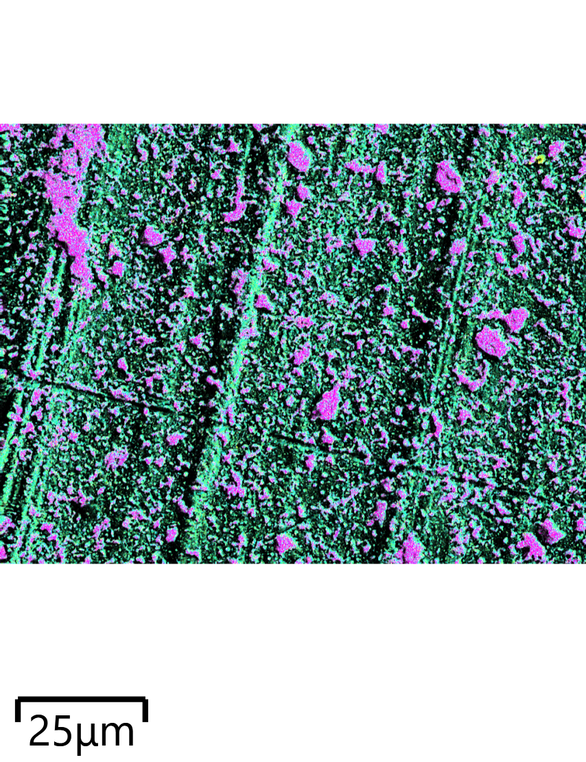
Surface SEM/4hours/CO_/zoomin/EDS Layered Image 9.png
