shortlab/2024-RadCor-Pb-316/Surface SEM/4hours/CO_/zoomout/1/Electron Image 12.tif

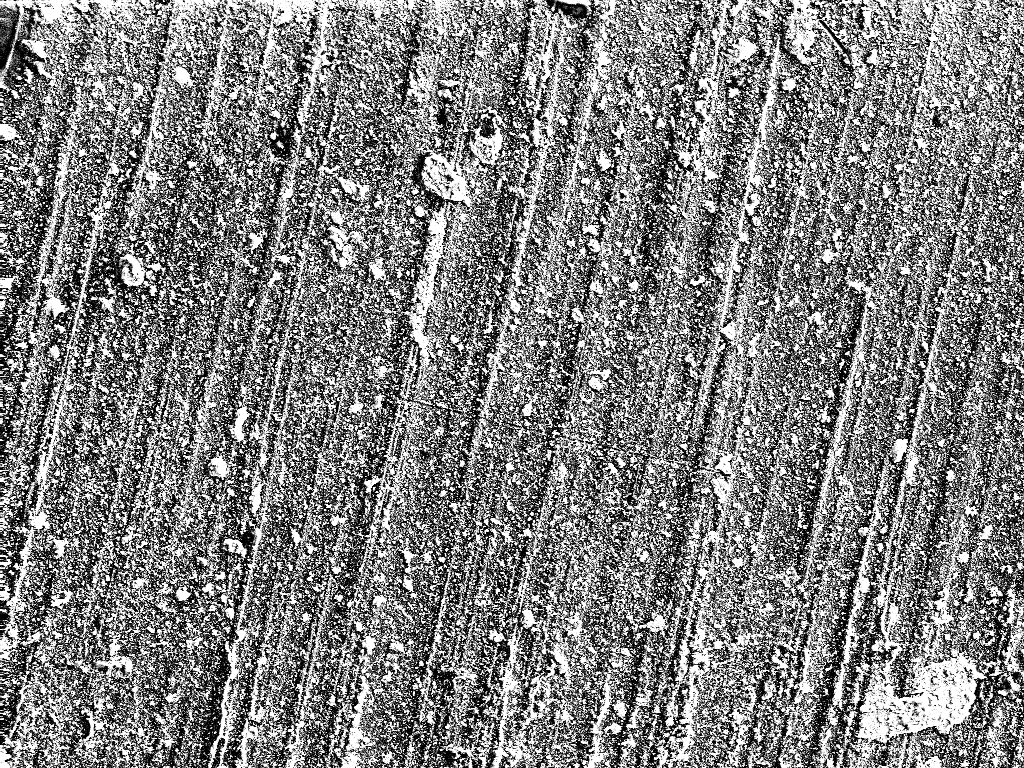
Surface SEM/4hours/CO_/zoomout/1/Electron Image 12.tif
