shortlab/2024-RadCor-Pb-316/Surface SEM/4hours/CO_/zoomout/1/Pb Mα1 Map Data 8.tif

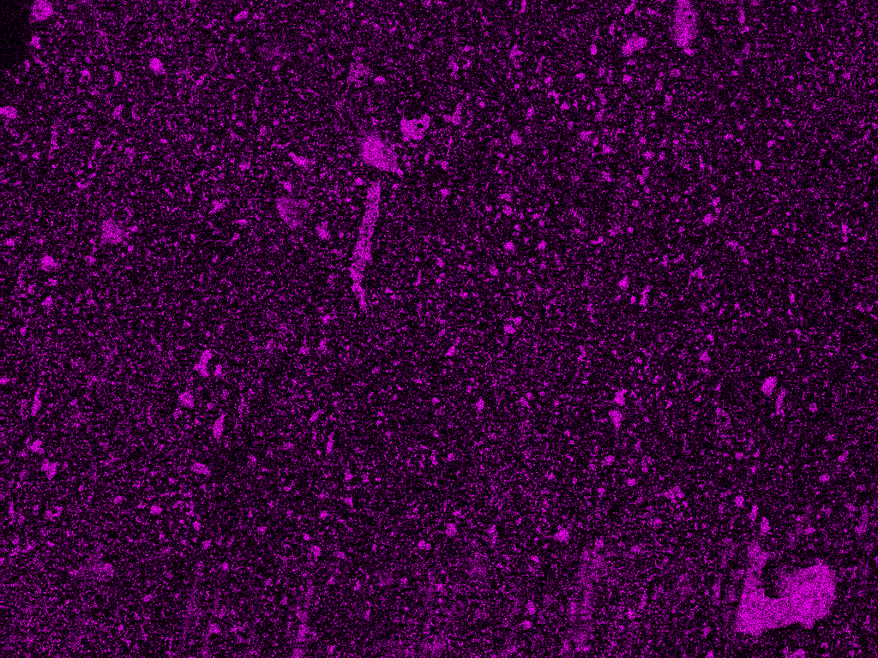
Surface SEM/4hours/CO_/zoomout/1/Pb Mα1 Map Data 8.tif
