shortlab/2024-RadCor-Pb-316/Surface SEM/4hours/CO_/zoomout/EDS Layered Image 8.png

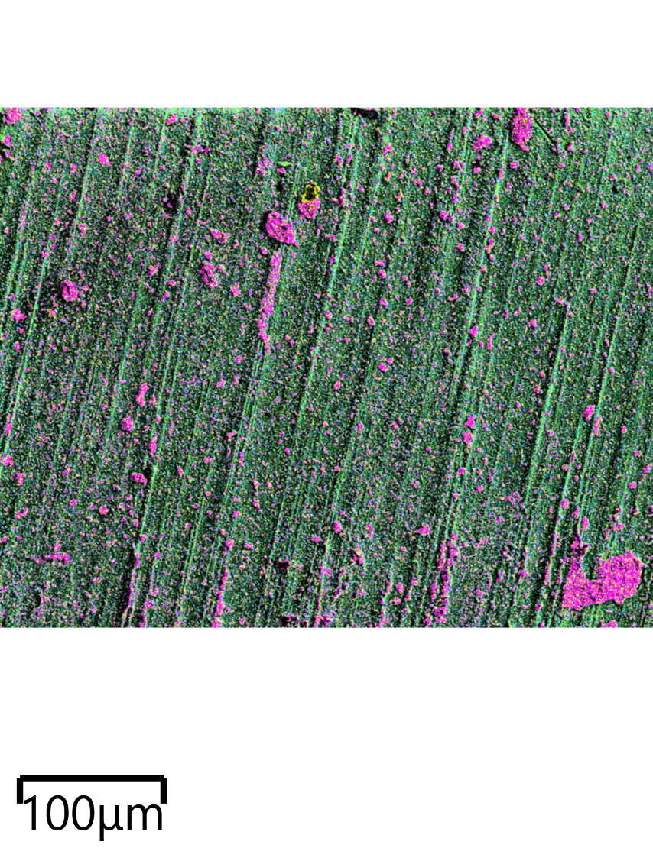
Surface SEM/4hours/CO_/zoomout/EDS Layered Image 8.png
