shortlab/2024-RadCor-Pb-316/Surface SEM/4hours/RAC_/RAC/EDX/CO_/Electron Image 4.tiff

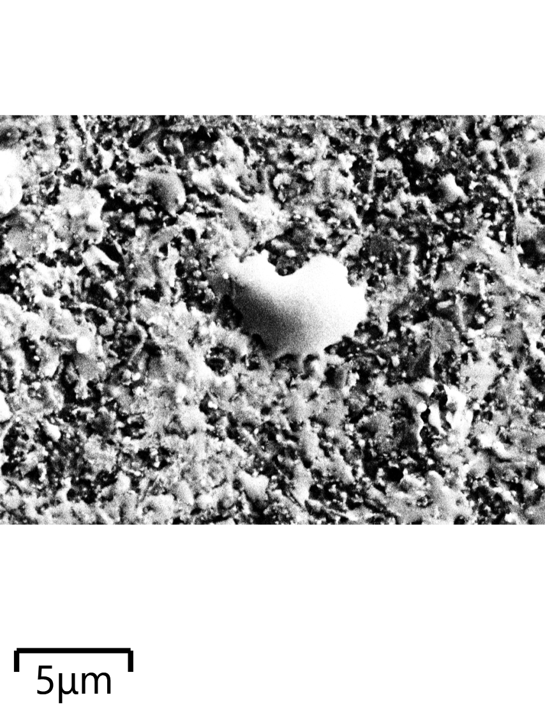
Surface SEM/4hours/RAC_/RAC/EDX/CO_/Electron Image 4.tiff
