shortlab/2024-RadCor-Pb-316/Surface SEM/4hours/RAC_/RAC/EDX/CO_/O Kα1 Map Data 2.tif

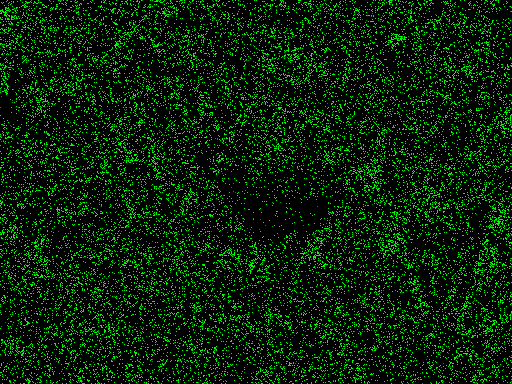
Surface SEM/4hours/RAC_/RAC/EDX/CO_/O Kα1 Map Data 2.tif
