shortlab/2024-RadCor-Pb-316/Surface SEM/4hours/RAC_/RAC/Surface/PlainImages/CO_08.tif

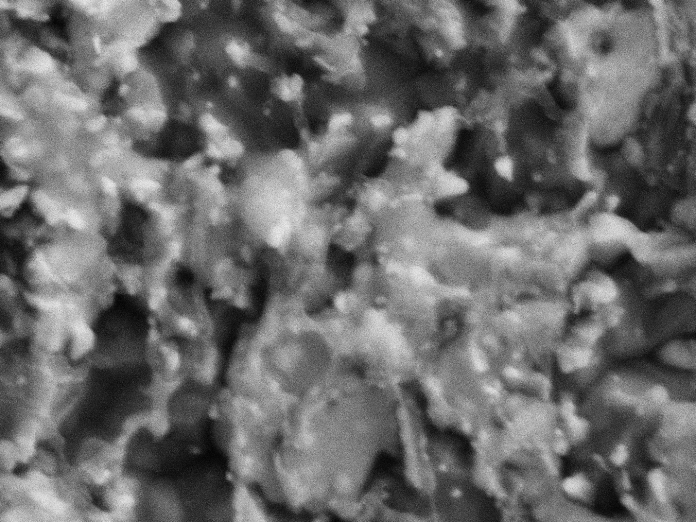
Surface SEM/4hours/RAC_/RAC/Surface/PlainImages/CO_08.tif
