shortlab/2024-RadCor-Pb-316/Surface SEM/4hours/RAC_/zoomin_/1/Electron Image 10.tif

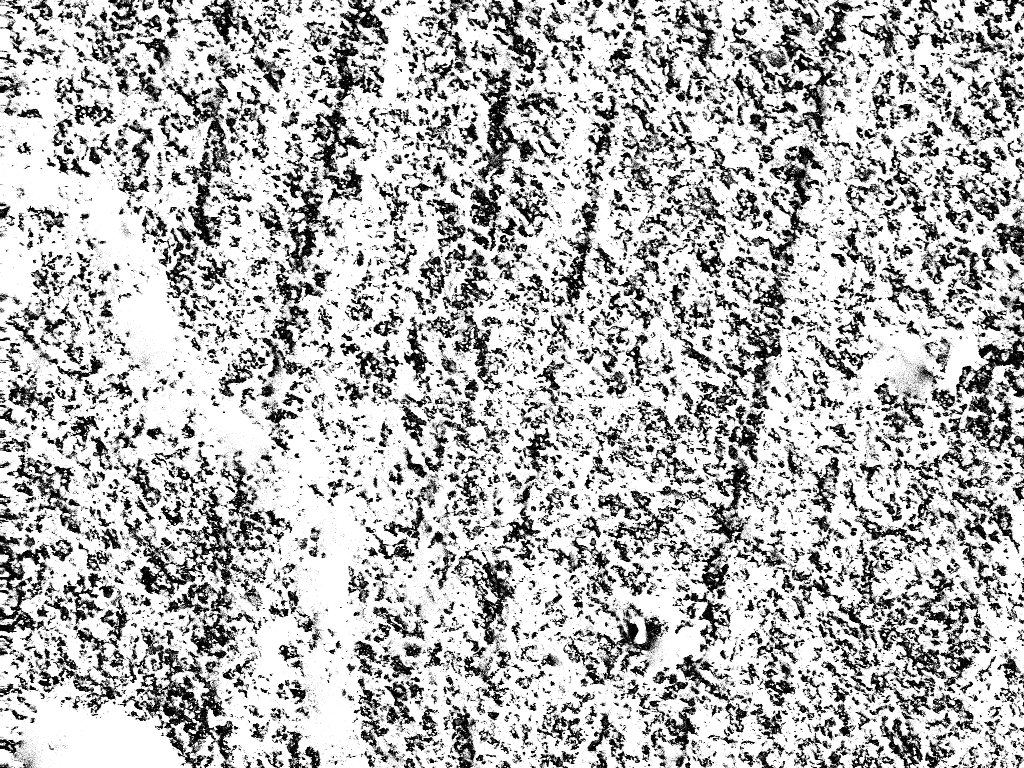
Surface SEM/4hours/RAC_/zoomin_/1/Electron Image 10.tif
