shortlab/2024-RadCor-Pb-316/Surface SEM/4hours/RAC_/zoomin_/1/Ni Kα1 Map Data 7.tif

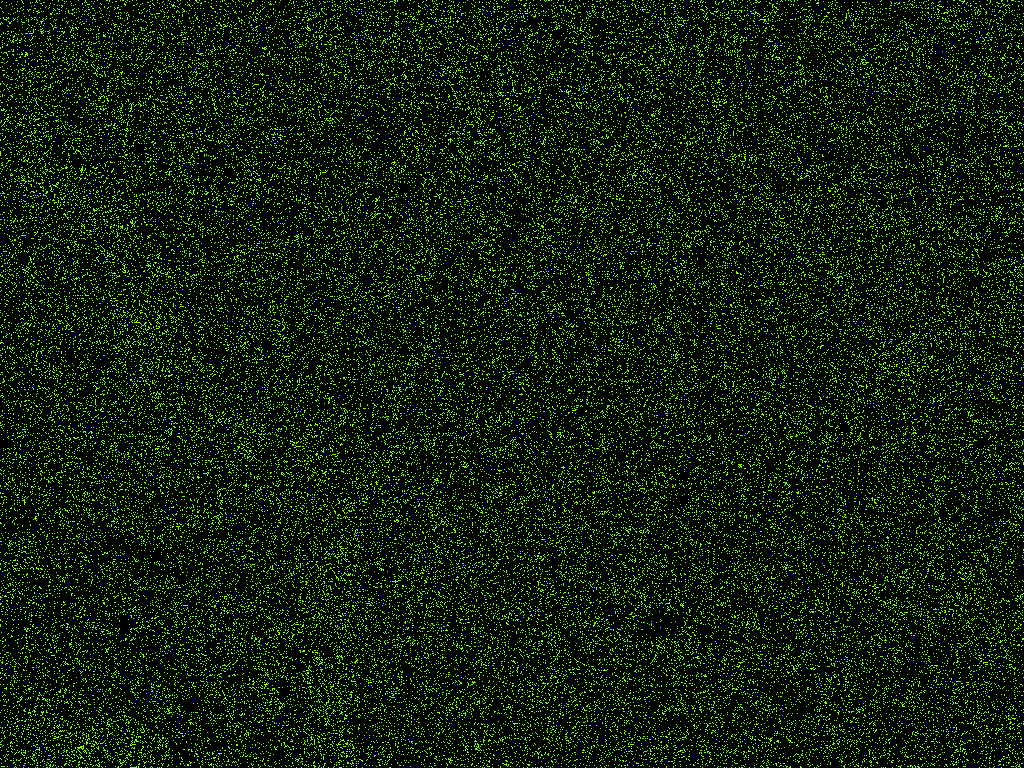
Surface SEM/4hours/RAC_/zoomin_/1/Ni Kα1 Map Data 7.tif
