shortlab/2024-RadCor-Pb-316/Surface SEM/4hours/RAC_/zoomin_/Ni Kα1.png

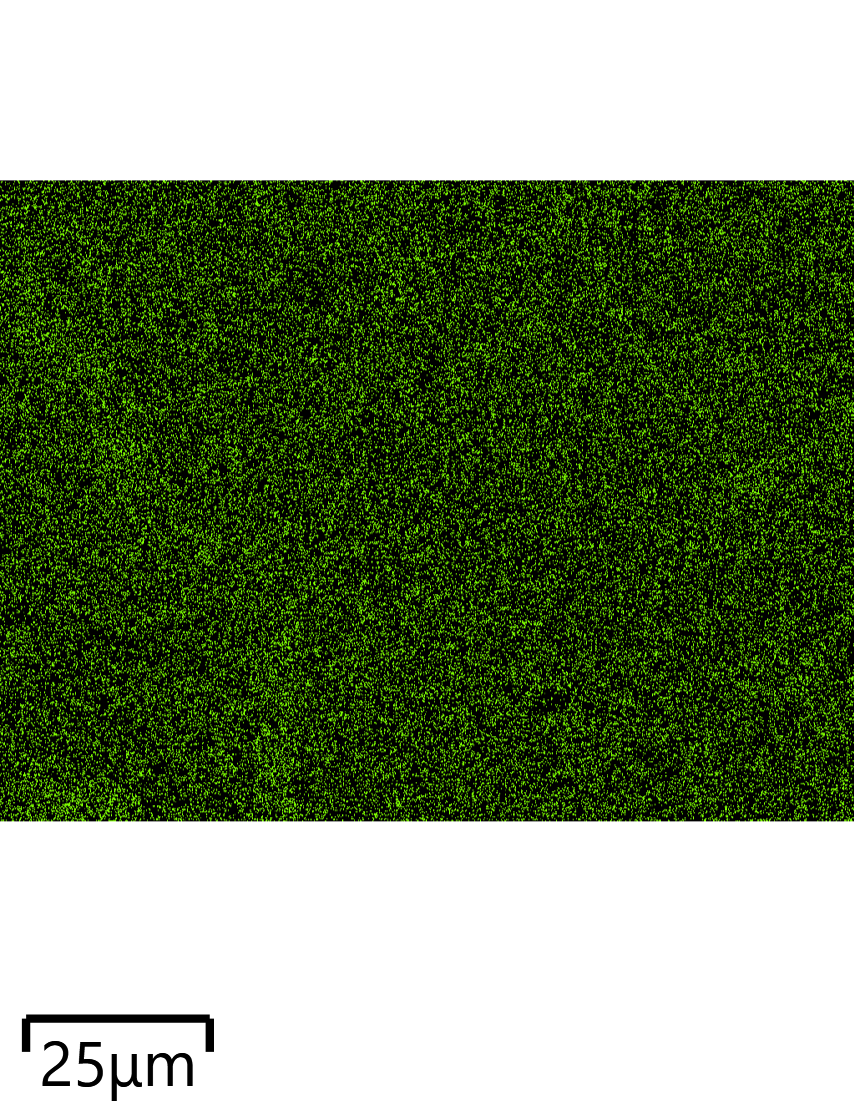
Surface SEM/4hours/RAC_/zoomin_/Ni Kα1.png
