shortlab/2024-RadCor-Pb-316/Surface SEM/4hours/RAC_/zoomout_/EDS Layered Image 5.png

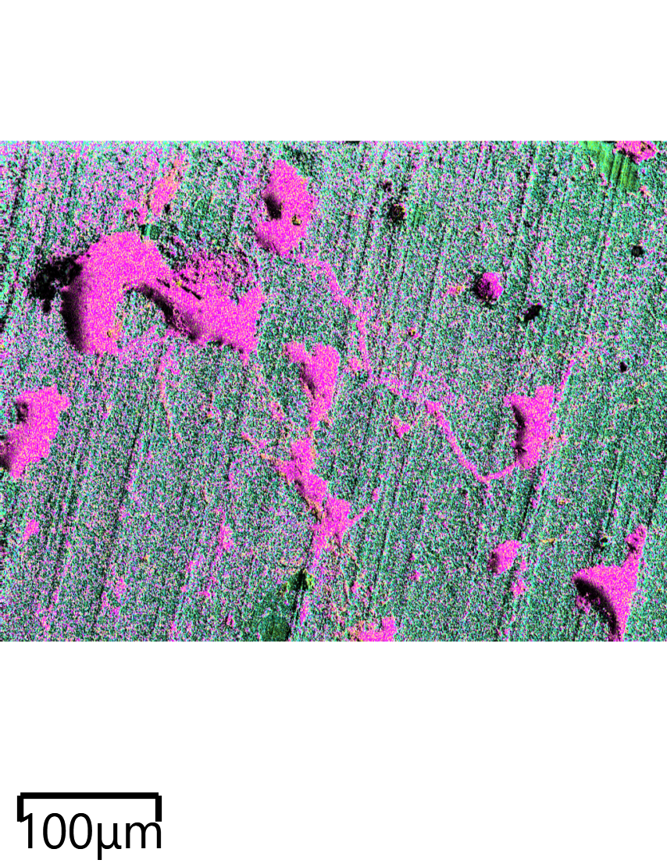
Surface SEM/4hours/RAC_/zoomout_/EDS Layered Image 5.png
