shortlab/2024-RadCor-Pb-316/Surface SEM/4hours/RAC_/zoomout_/Electron Image 8.png

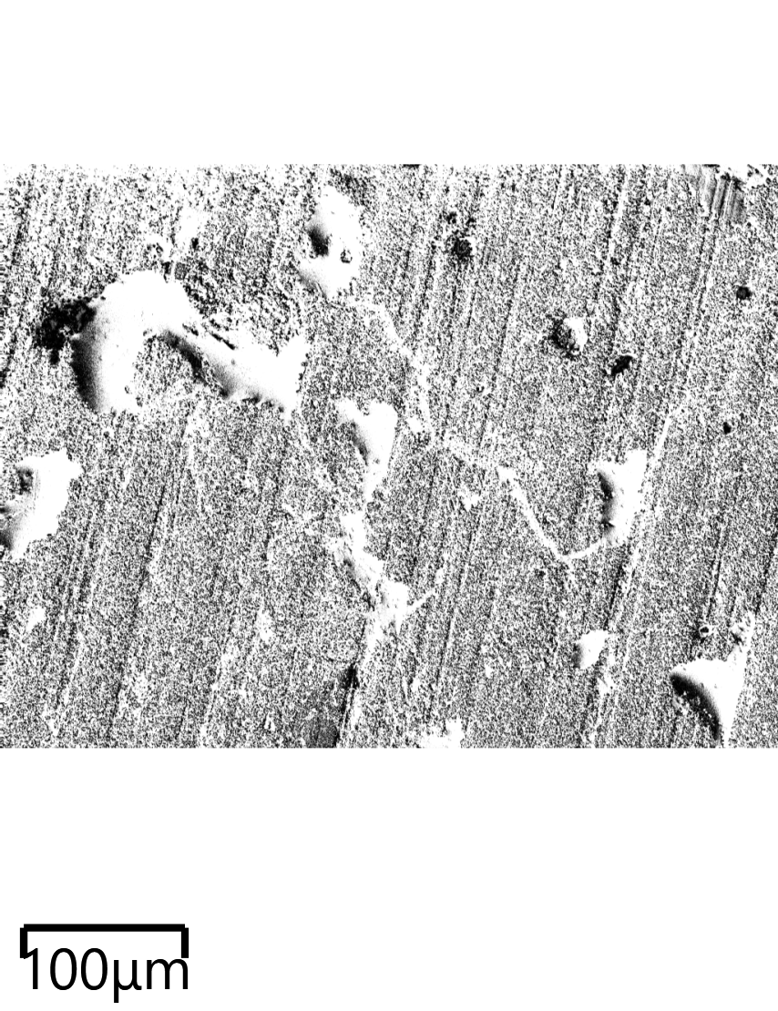
Surface SEM/4hours/RAC_/zoomout_/Electron Image 8.png
