shortlab/2024-RadCor-Pb-316/Surface SEM/8hours/CO_/zoomin/1/Cr Kα1 Map Data 4.tif

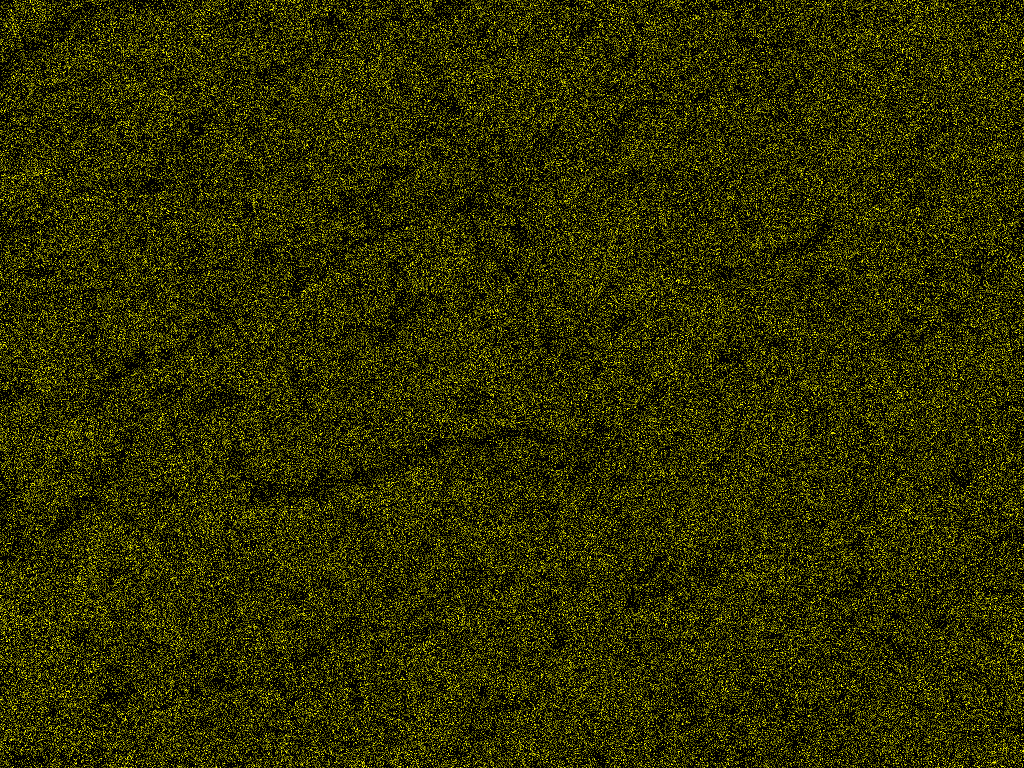
Surface SEM/8hours/CO_/zoomin/1/Cr Kα1 Map Data 4.tif
