shortlab/2024-RadCor-Pb-316/Surface SEM/8hours/CO_/zoomin/1/Electron Image 6.tif

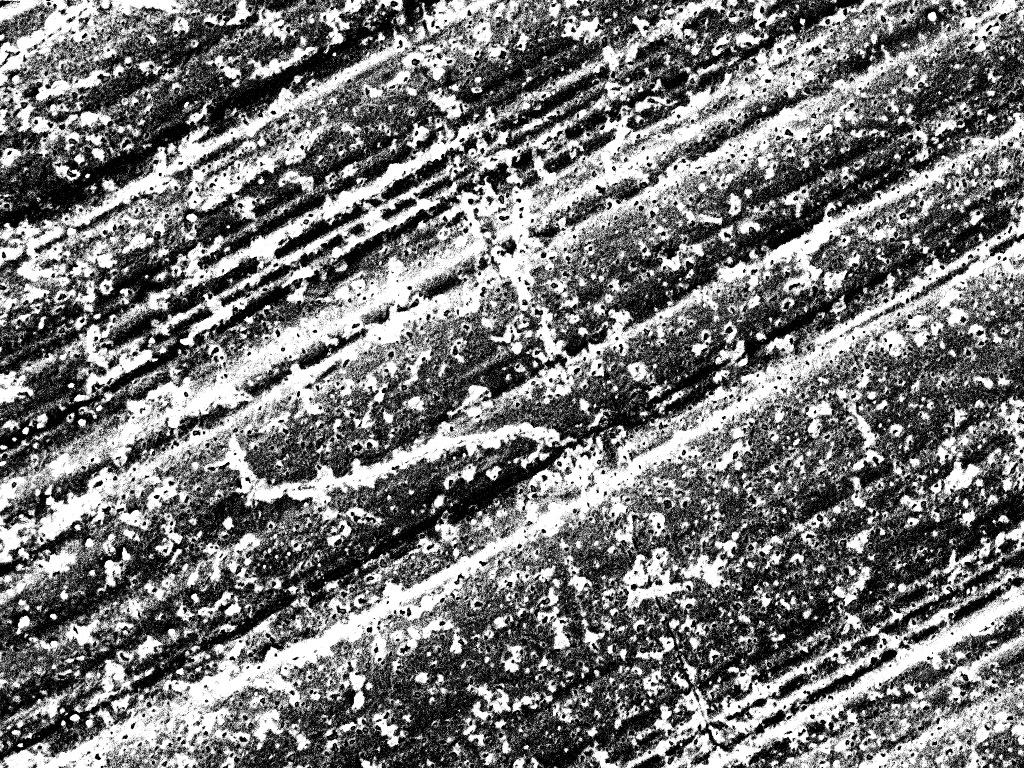
Surface SEM/8hours/CO_/zoomin/1/Electron Image 6.tif
