shortlab/2024-RadCor-Pb-316/Surface SEM/8hours/CO_/zoomin/EDS Layered Image 4.png

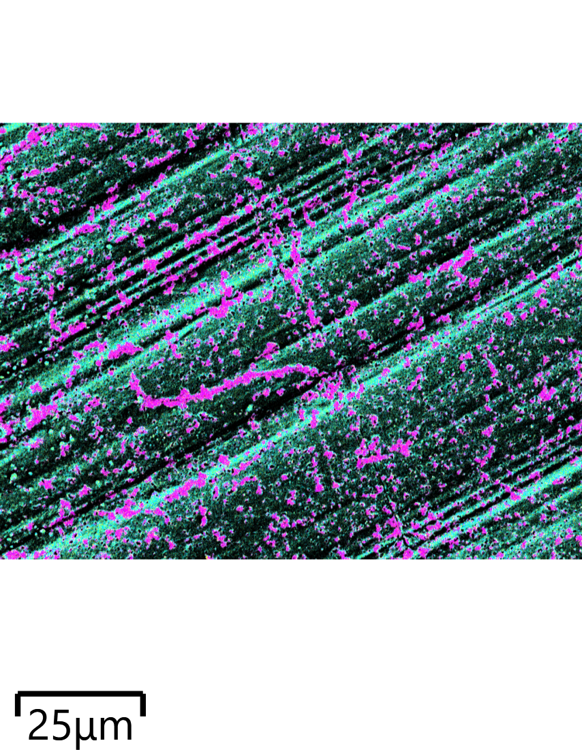
Surface SEM/8hours/CO_/zoomin/EDS Layered Image 4.png
