shortlab/2024-RadCor-Pb-316/Surface SEM/8hours/CO_/zoomout/1/Cr Kα1 Map Data 3.tif

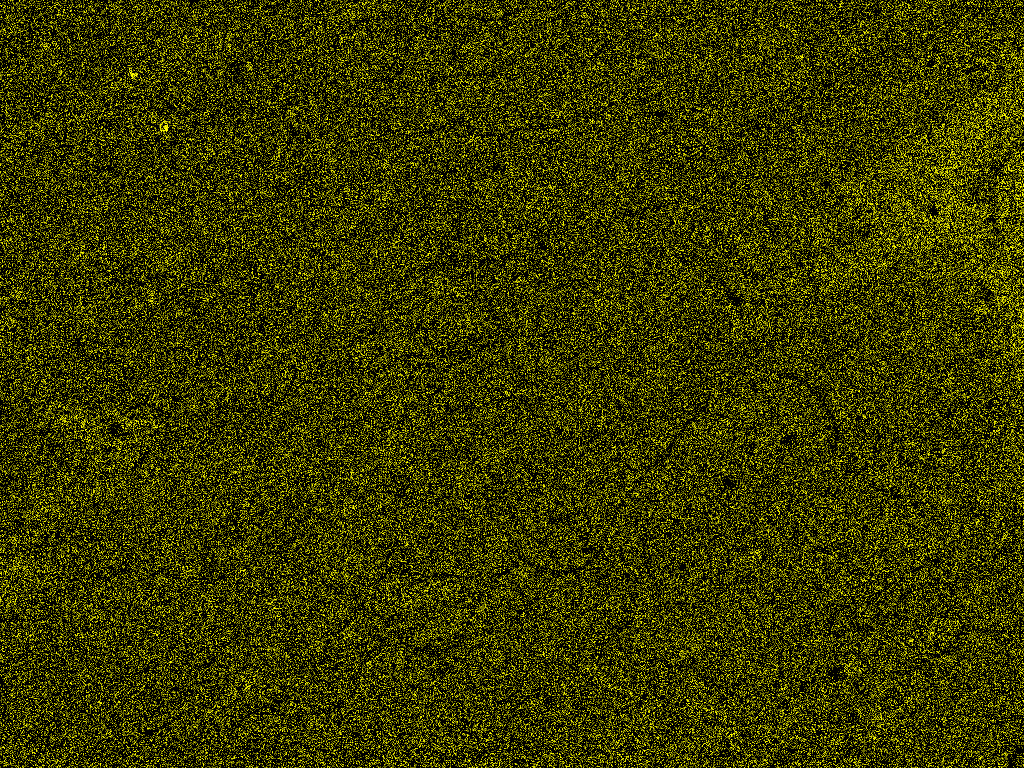
Surface SEM/8hours/CO_/zoomout/1/Cr Kα1 Map Data 3.tif
