shortlab/2024-RadCor-Pb-316/Surface SEM/8hours/CO_/zoomout/1/Electron Image 5.tif

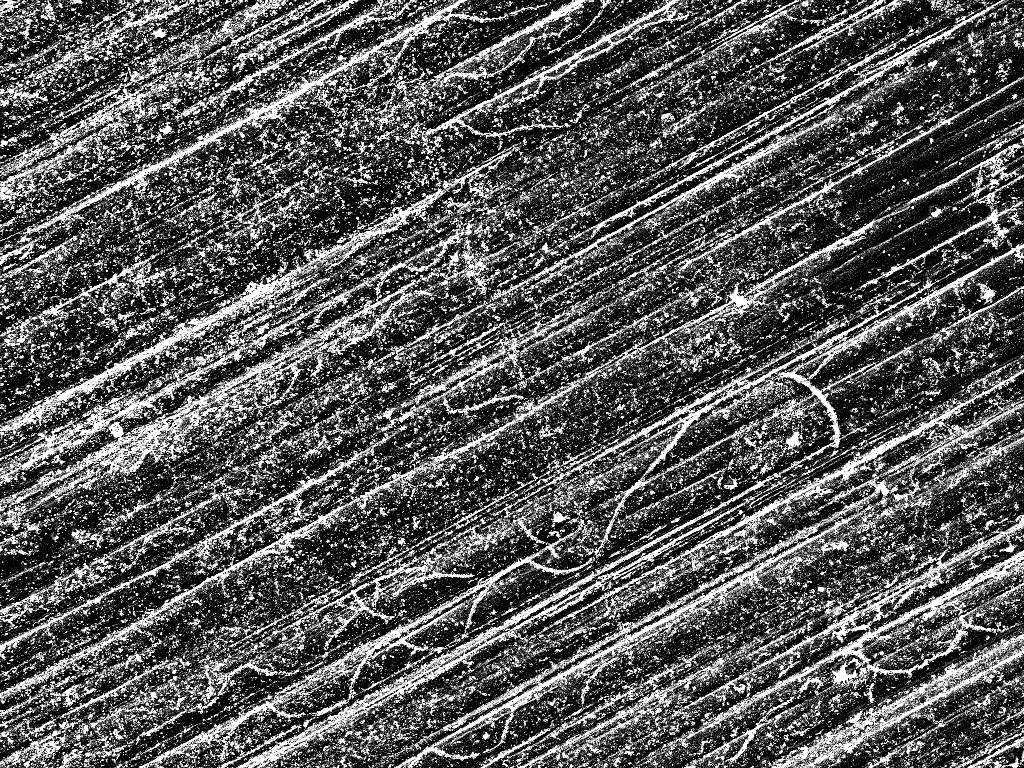
Surface SEM/8hours/CO_/zoomout/1/Electron Image 5.tif
