shortlab/2024-RadCor-Pb-316/Surface SEM/8hours/CO_/zoomout/EDS Layered Image 3.png

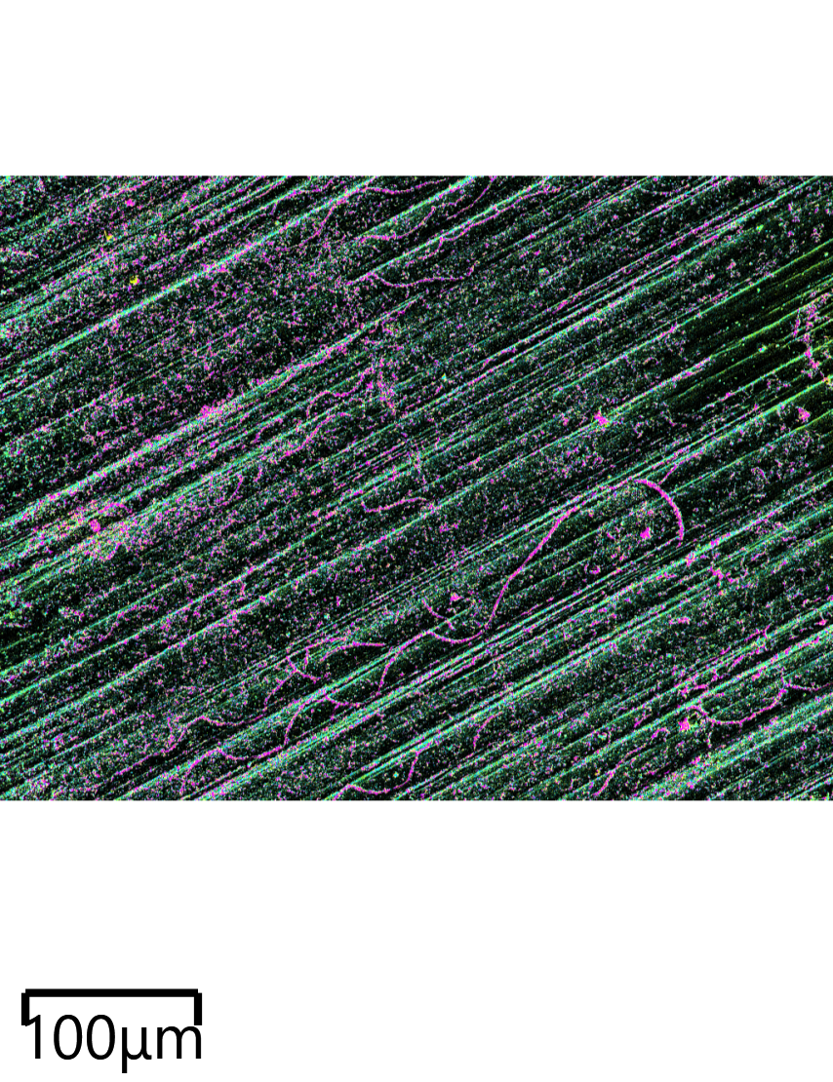
Surface SEM/8hours/CO_/zoomout/EDS Layered Image 3.png
