shortlab/2024-RadCor-Pb-316/Surface SEM/8hours/RAC_/zoomin/1/Electron Image 4.tif

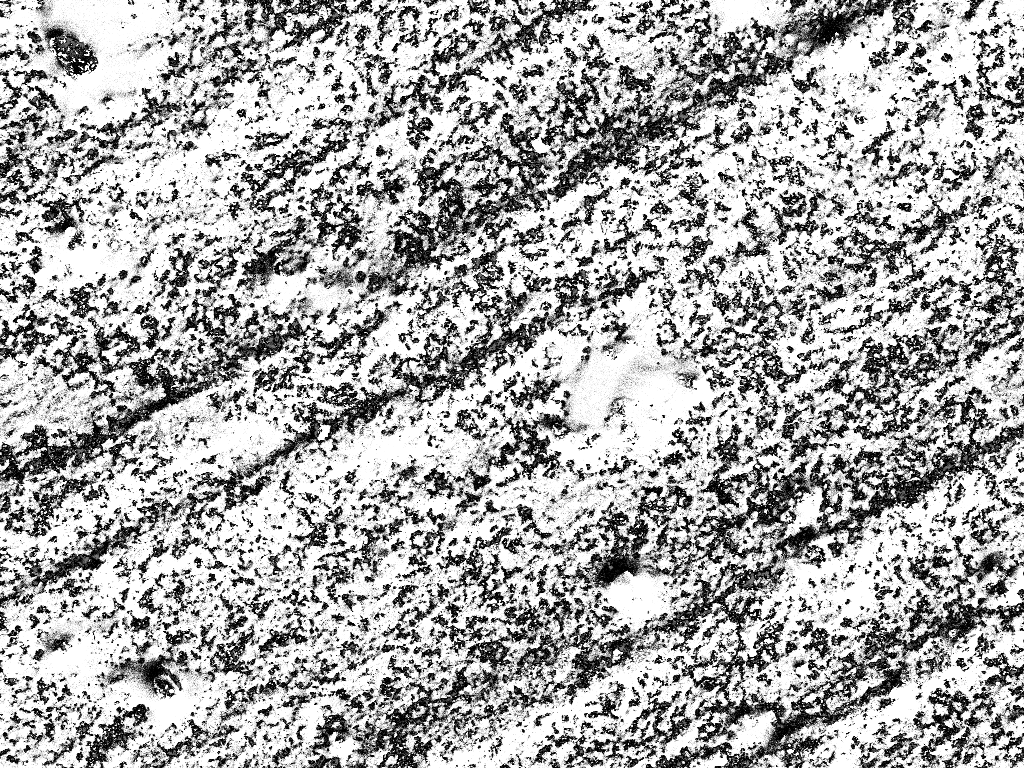
Surface SEM/8hours/RAC_/zoomin/1/Electron Image 4.tif
