shortlab/2024-RadCor-Pb-316/Surface SEM/8hours/RAC_/zoomin/1/Pb Mα1 Map Data 2.tif

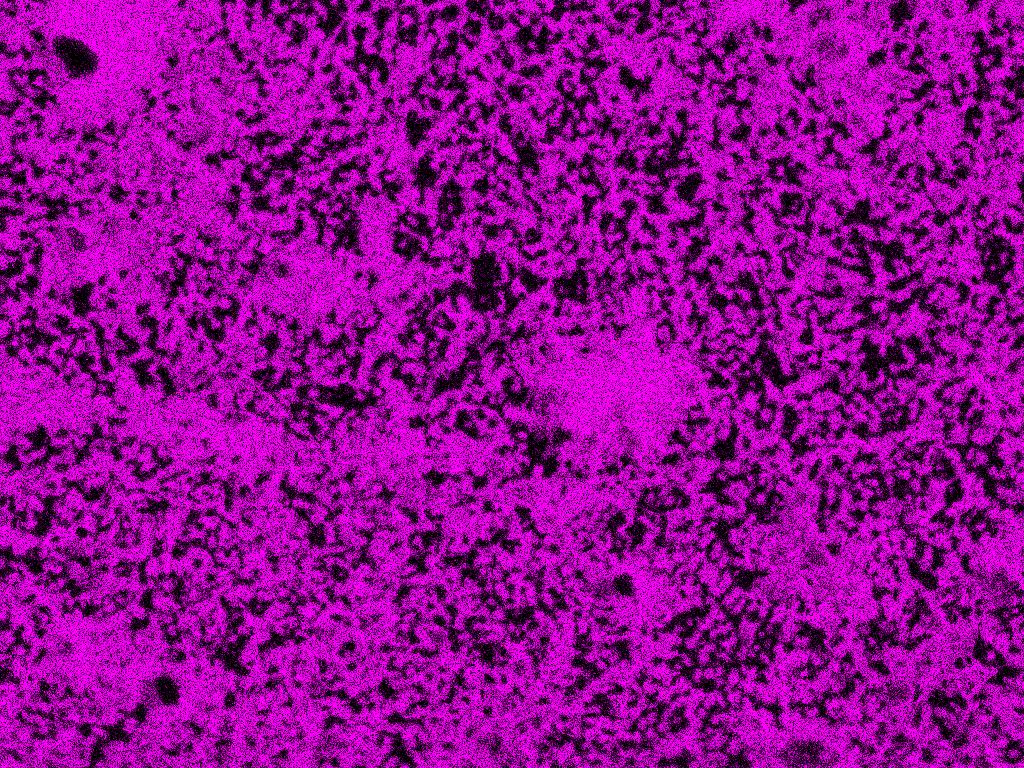
Surface SEM/8hours/RAC_/zoomin/1/Pb Mα1 Map Data 2.tif
