shortlab/2024-RadCor-Pb-316/Surface SEM/8hours/RAC_/zoomin/EDS Layered Image 2.png

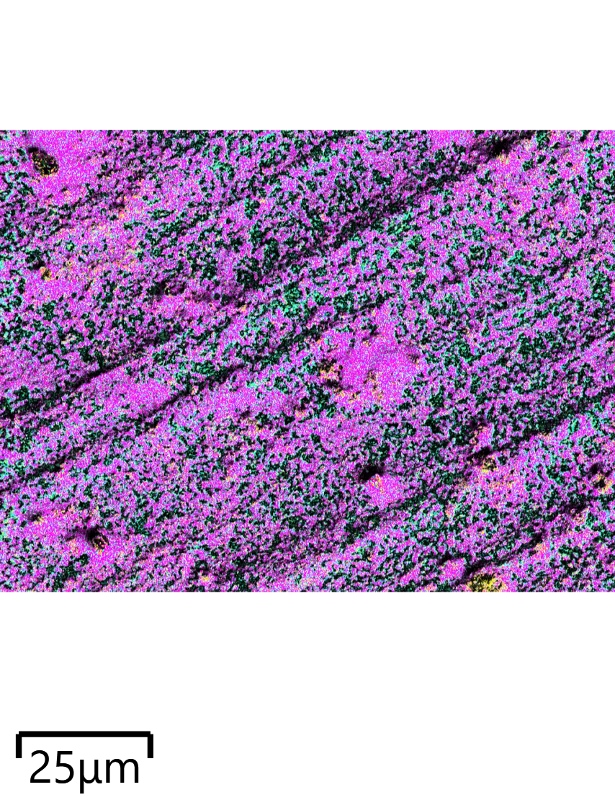
Surface SEM/8hours/RAC_/zoomin/EDS Layered Image 2.png
