shortlab/2024-RadCor-Pb-316/Surface SEM/8hours/RAC_/zoomout_1/1/Cr Kα1 Map Data 1.tif

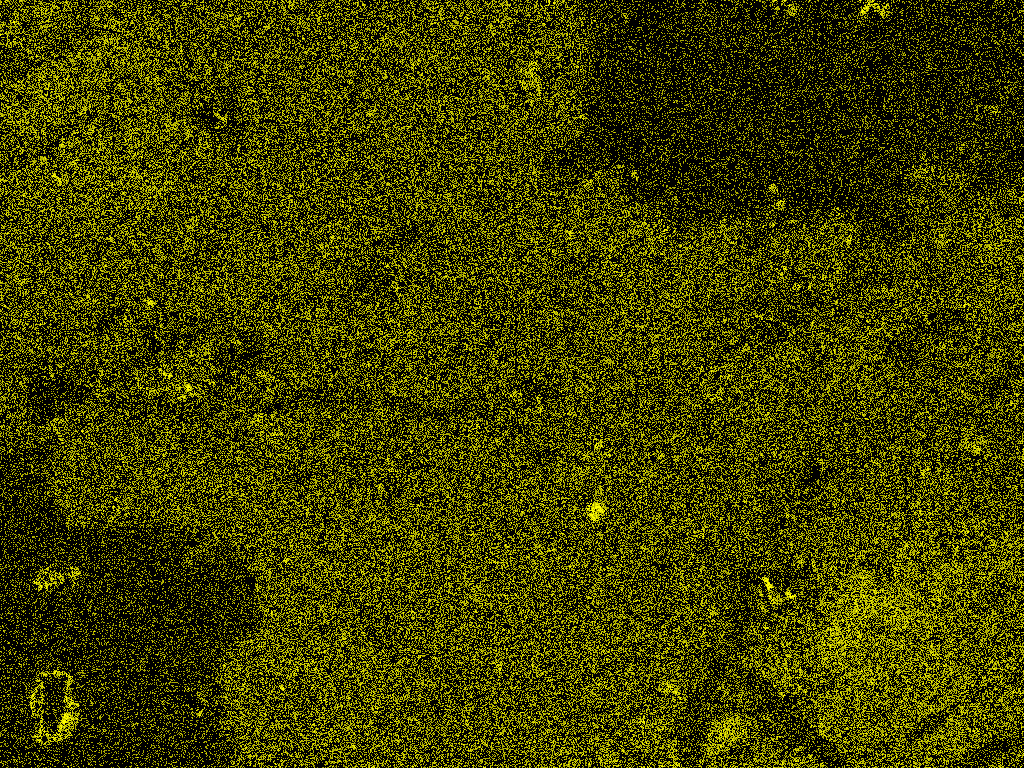
Surface SEM/8hours/RAC_/zoomout_1/1/Cr Kα1 Map Data 1.tif
