shortlab/2024-RadCor-Pb-316/Surface SEM/8hours/RAC_/zoomout_1/1/Electron Image 3.tif

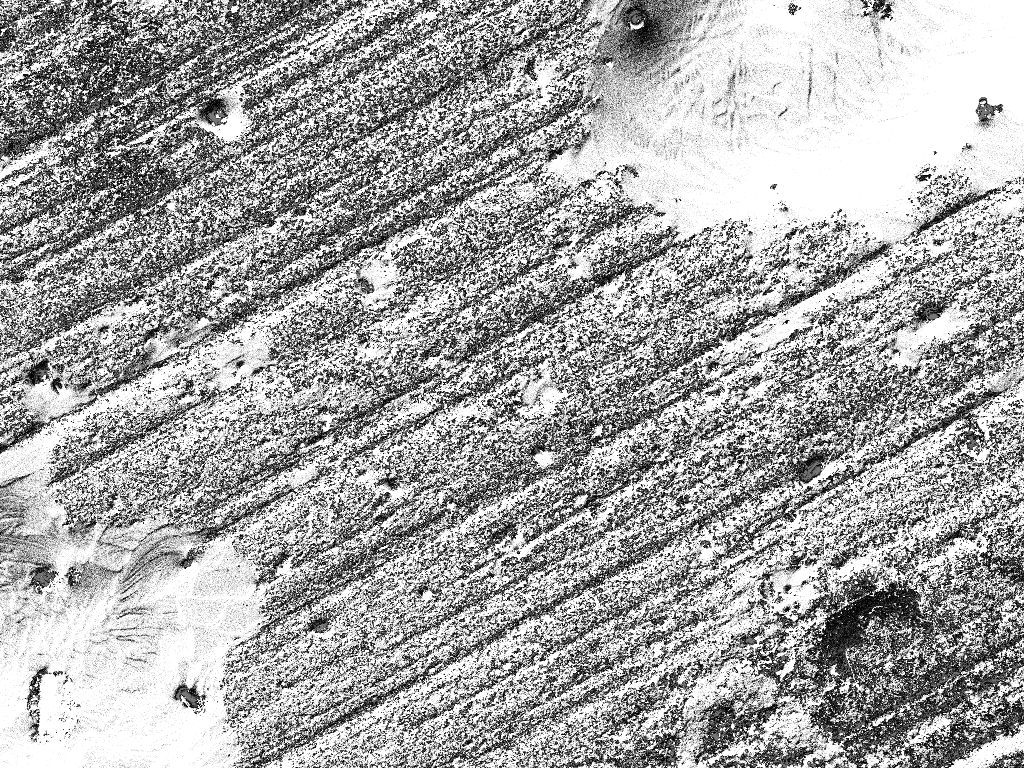
Surface SEM/8hours/RAC_/zoomout_1/1/Electron Image 3.tif
