shortlab/2024-RadCor-Pb-316/Surface SEM/8hours/RAC_/zoomout_1/Pb Mα1.png

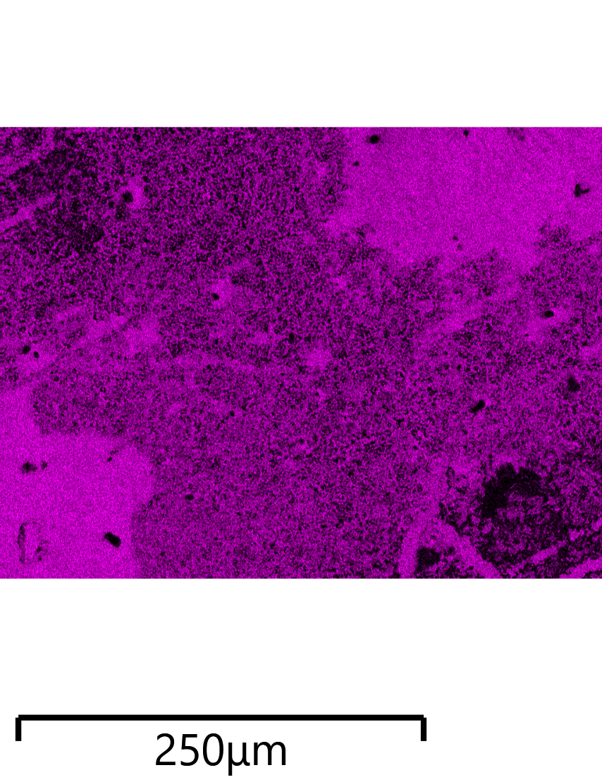
Surface SEM/8hours/RAC_/zoomout_1/Pb Mα1.png
