shortlab/2024-RadCor-Pb-316/TEM/Maps/CO/5/Cr Kα1.tiff

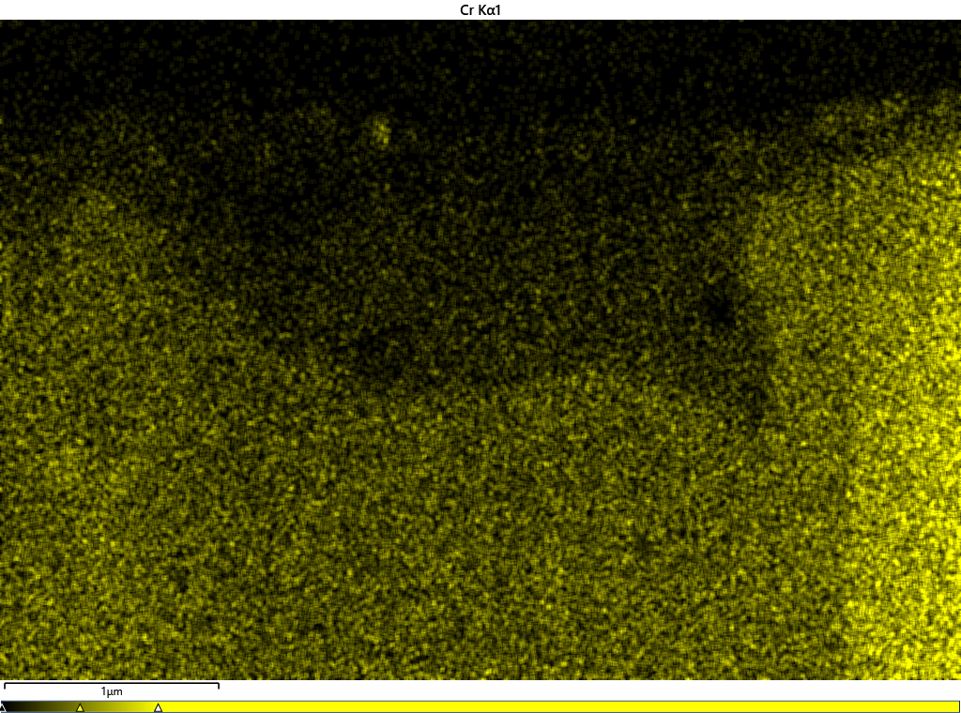
TEM/Maps/CO/5/Cr Kα1.tiff
