shortlab/2024-RadCor-Pb-316/TEM/Maps/CO/5/Electron Image 6.tiff

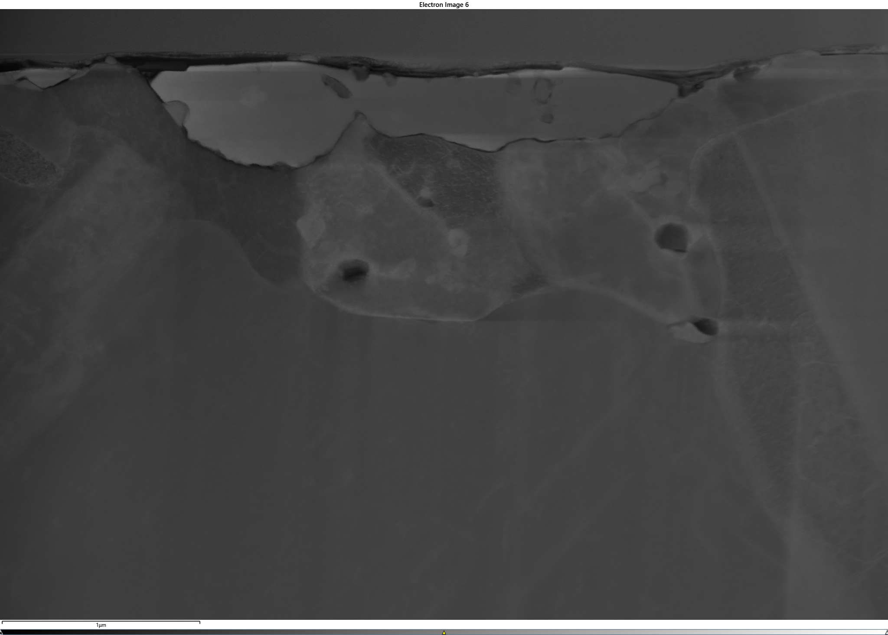
TEM/Maps/CO/5/Electron Image 6.tiff
