shortlab/2024-RadCor-Pb-316/TEM/Maps/CO/5/Pt Lα1.tiff

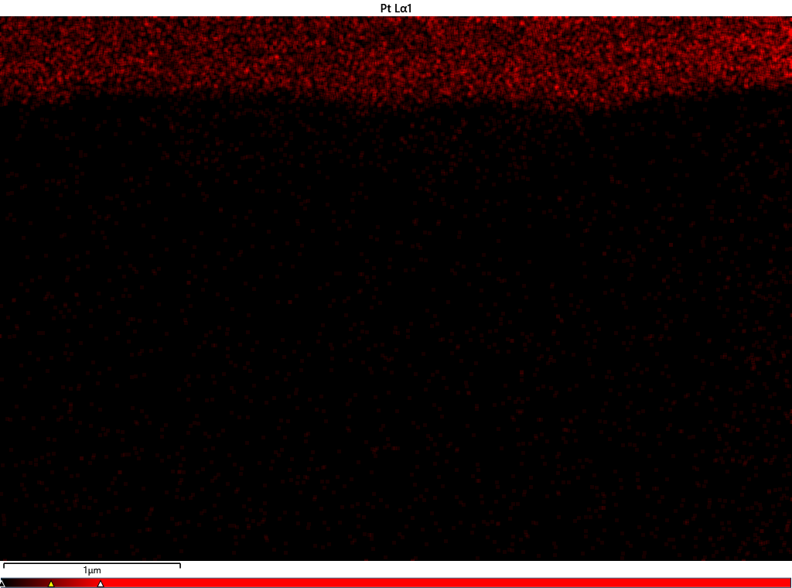
TEM/Maps/CO/5/Pt Lα1.tiff
