shortlab/2024-RadCor-Pb-316/TEM/Maps/CO/5/S Ll.tiff

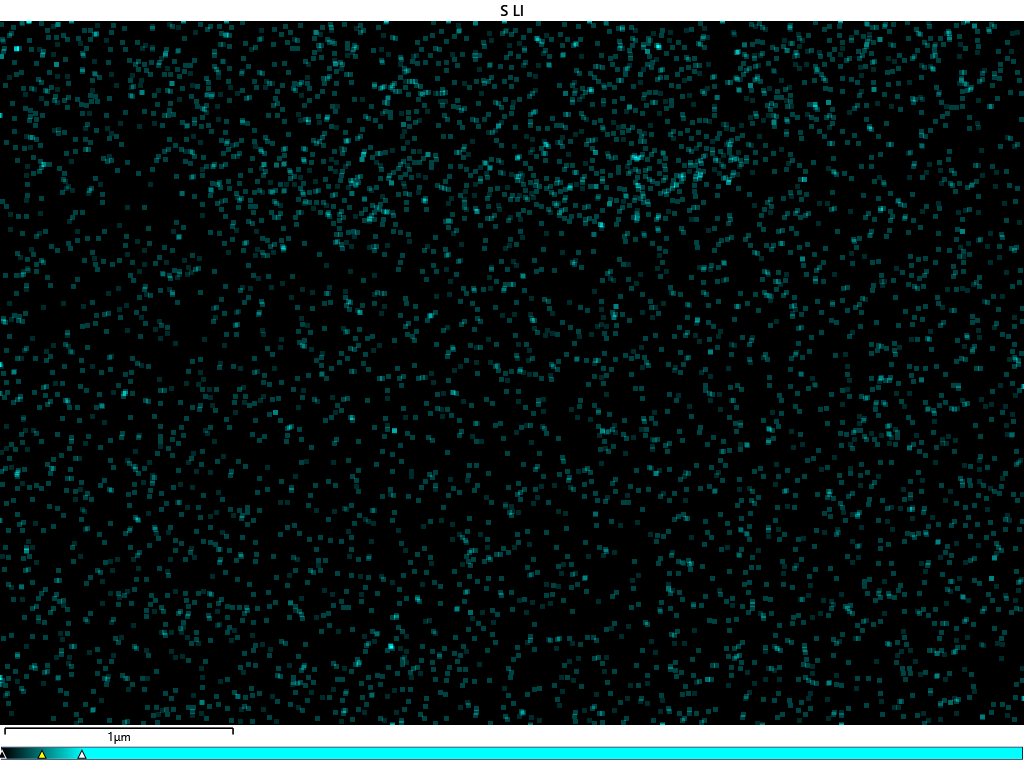
TEM/Maps/CO/5/S Ll.tiff
