shortlab/2024-RadCor-Pb-316/TEM/Maps/CO/6/Electron Image 8.tiff

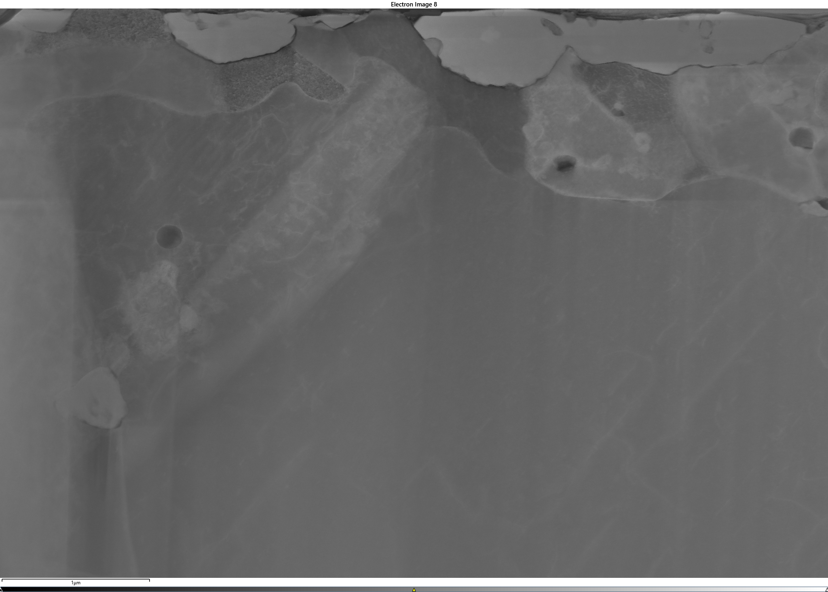
TEM/Maps/CO/6/Electron Image 8.tiff
