shortlab/2024-RadCor-Pb-316/TEM/Maps/CO/6/Electron Image 10.tiff

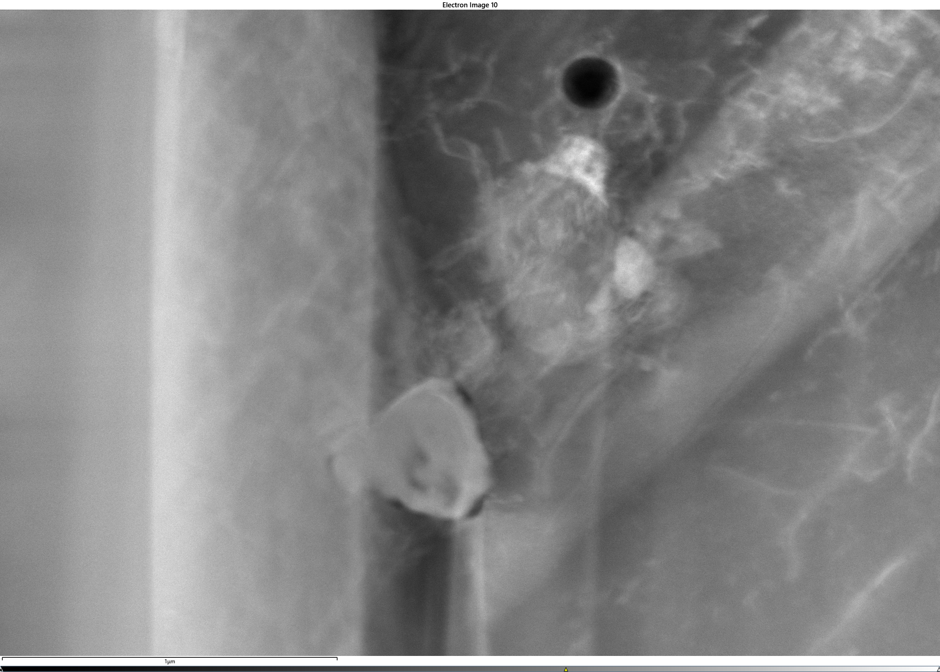
TEM/Maps/CO/6/Electron Image 10.tiff
