shortlab/2024-RadCor-Pb-316/TEM/Maps/CO/6/Fe Kα1.tiff

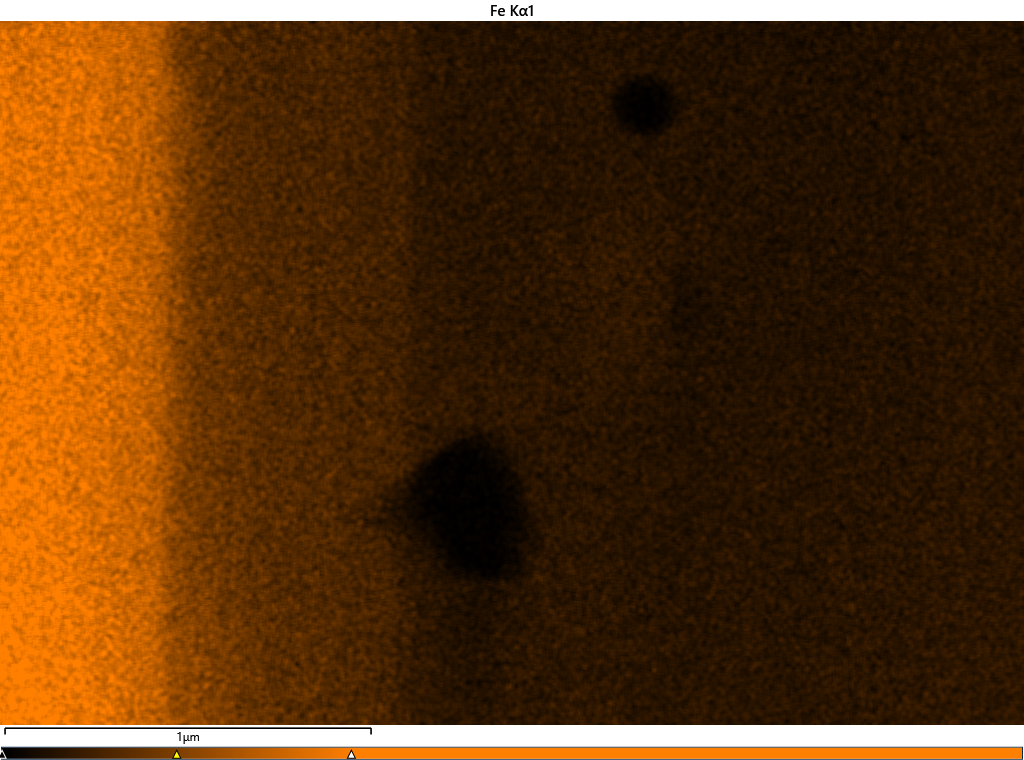
TEM/Maps/CO/6/Fe Kα1.tiff
