shortlab/2024-RadCor-Pb-316/TEM/Maps/RAC/Cr Kα1.tiff

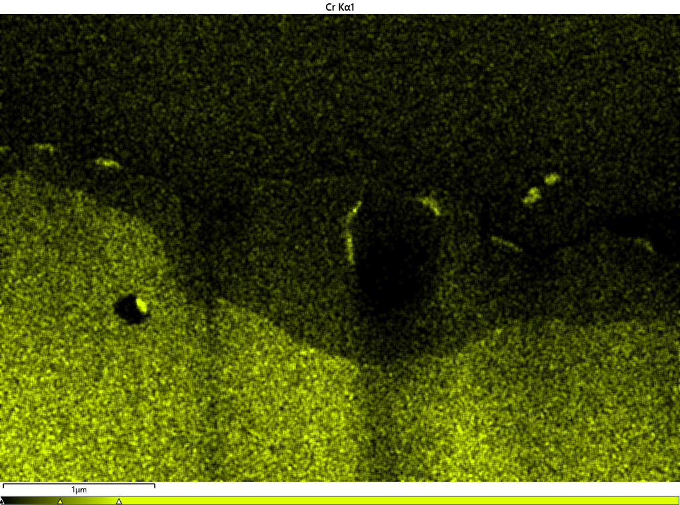
TEM/Maps/RAC/Cr Kα1.tiff
