shortlab/2024-RadCor-Pb-316/TEM/Maps/RAC/EDS Layered Image 1.tiff

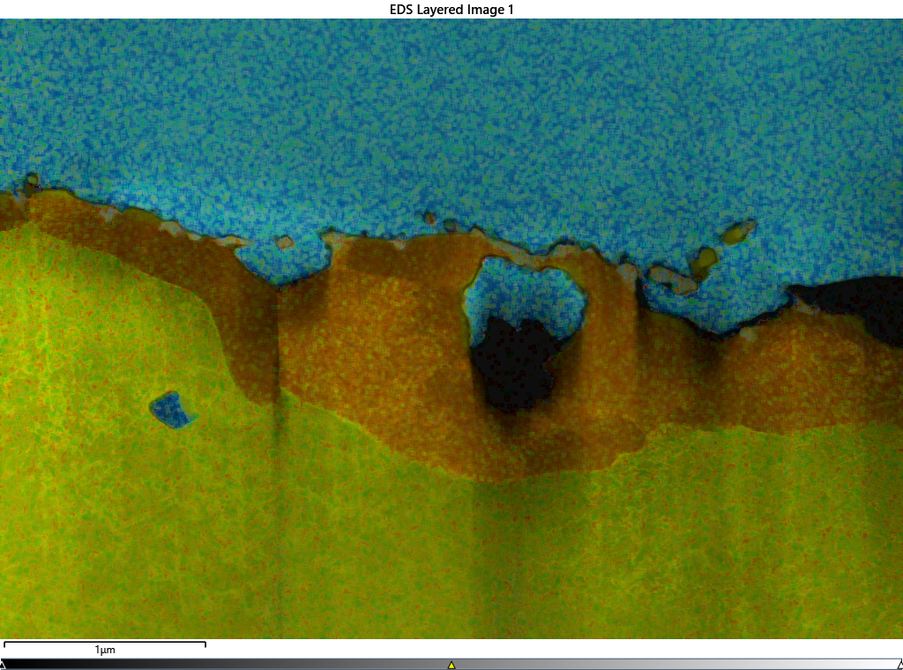
TEM/Maps/RAC/EDS Layered Image 1.tiff
