shortlab/2024-RadCor-Pb-316/TEM/Maps/RAC/Electron Image 1.tiff

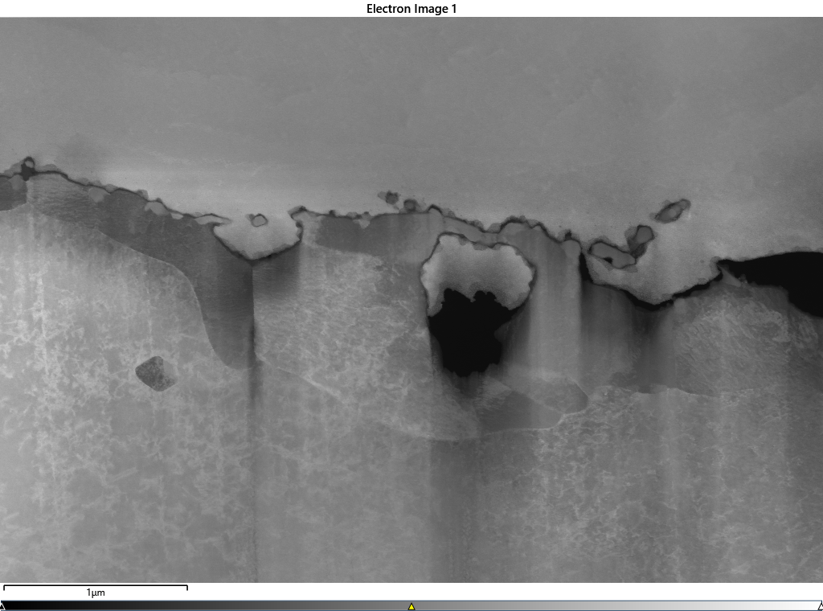
TEM/Maps/RAC/Electron Image 1.tiff
