shortlab/2024-RadCor-Pb-316/TEM/Maps/RAC/Fe Kα1.tiff

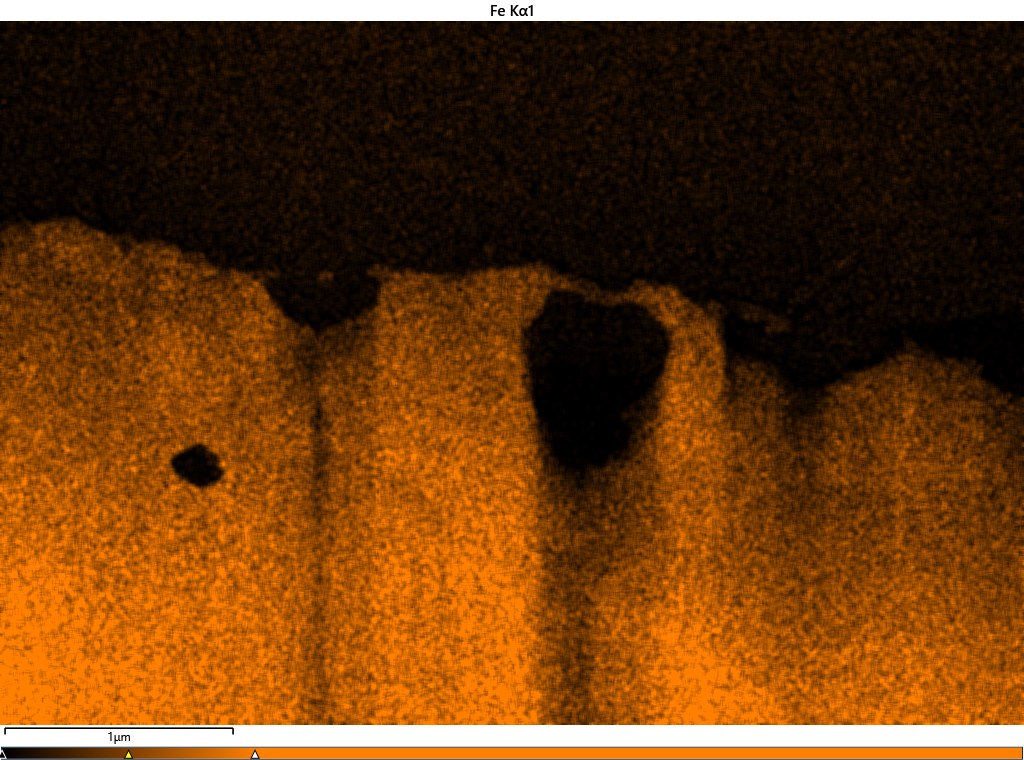
TEM/Maps/RAC/Fe Kα1.tiff
