shortlab/2024-RadCor-Pb-316/TEM/Maps/RAC/Ni Kα1.tiff

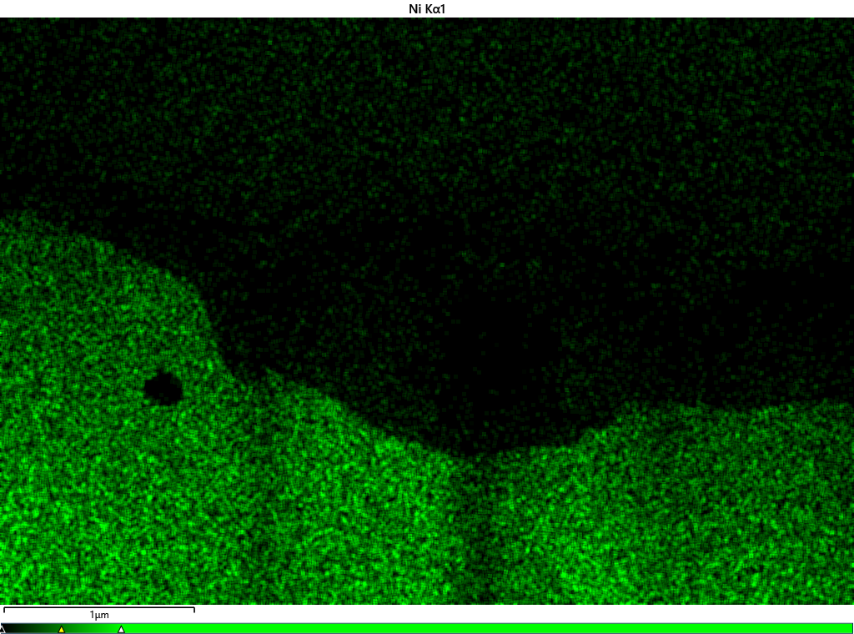
TEM/Maps/RAC/Ni Kα1.tiff
