shortlab/2024-RadCor-Pb-316/TEM/Maps/RAC/Pb Mα1.tiff

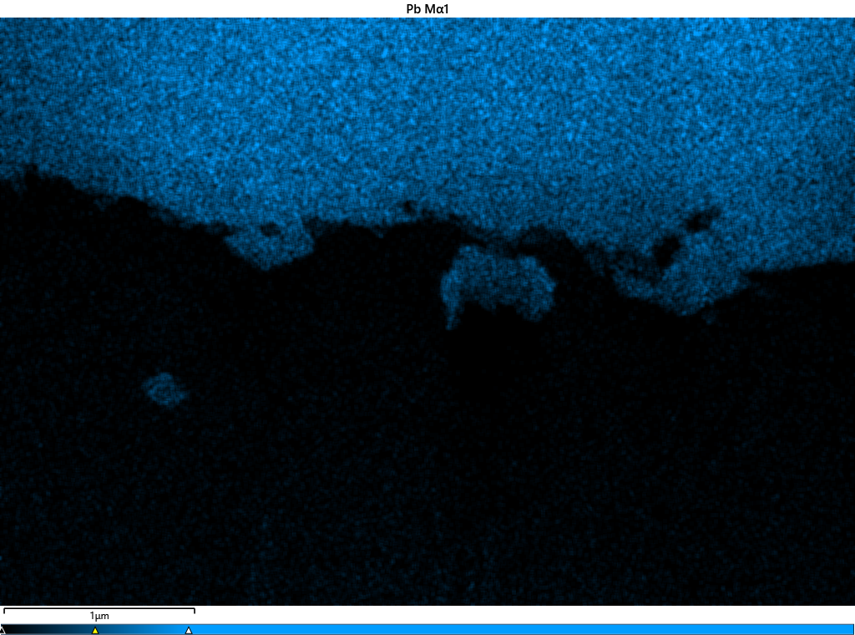
TEM/Maps/RAC/Pb Mα1.tiff
