shortlab/2024-RadCor-Pb-316/TEM/Phase boundary linescan/Project 2_phase boundary/CO.tif

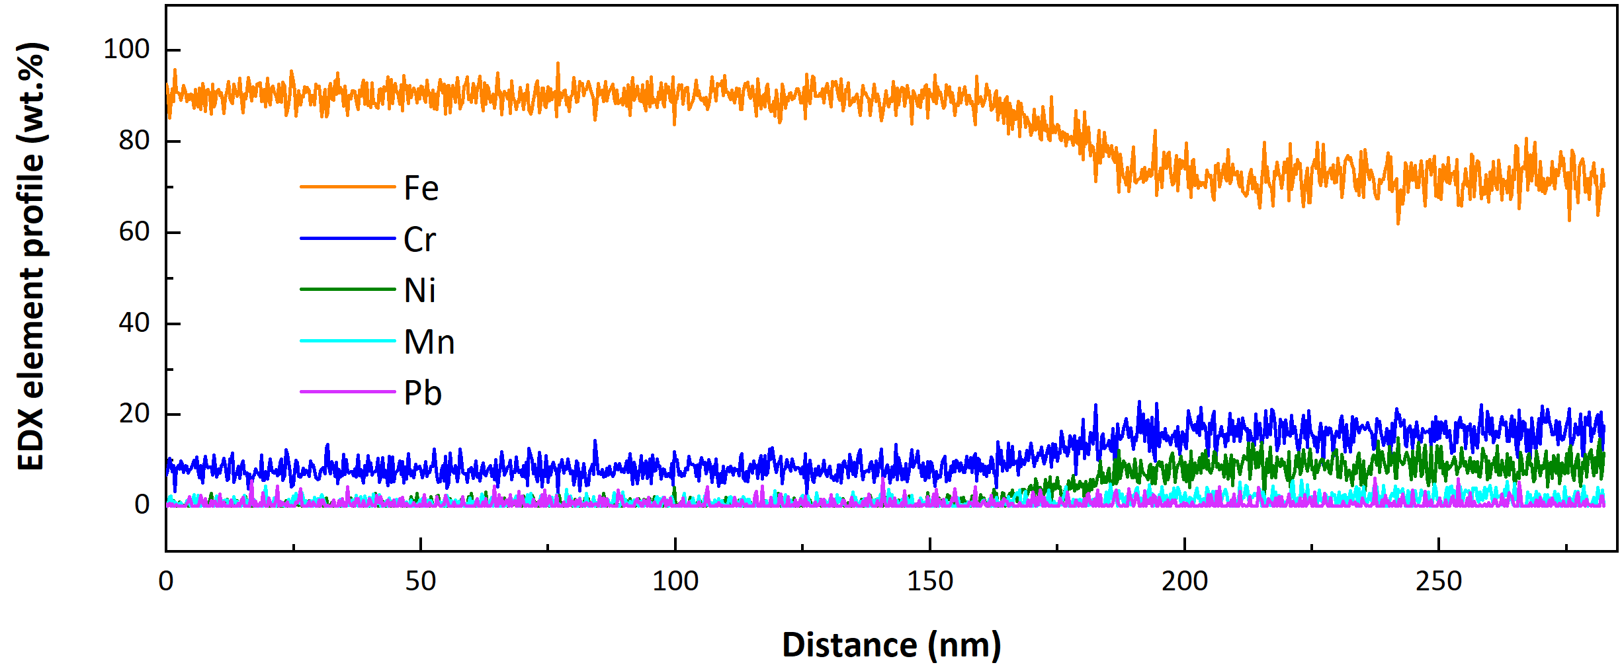
TEM/Phase boundary linescan/Project 2_phase boundary/CO.tif
