shortlab/2024-RadCor-Pb-316/TEM/Phase boundary linescan/Project 2_phase boundary/CO_phase boundary/Electron Image 5.tiff

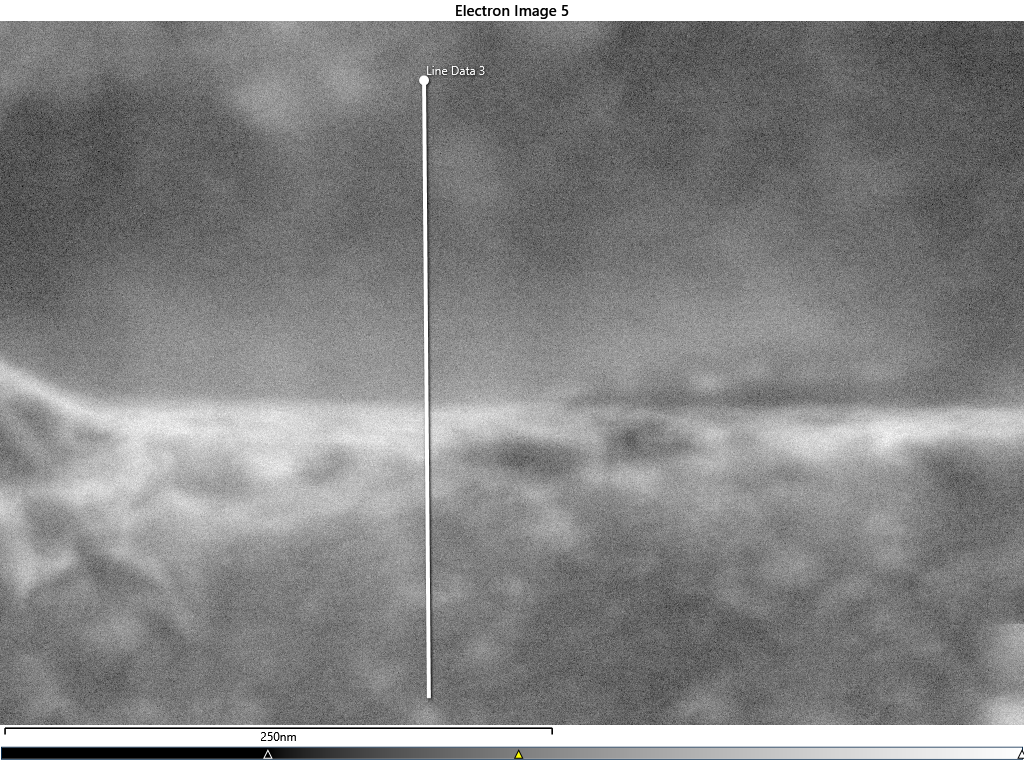
TEM/Phase boundary linescan/Project 2_phase boundary/CO_phase boundary/Electron Image 5.tiff
