shortlab/2024-RadCor-Pb-316/TEM/Phase boundary linescan/Project 2_phase boundary/RAC_phase boundary/1/Electron Image 1.tiff

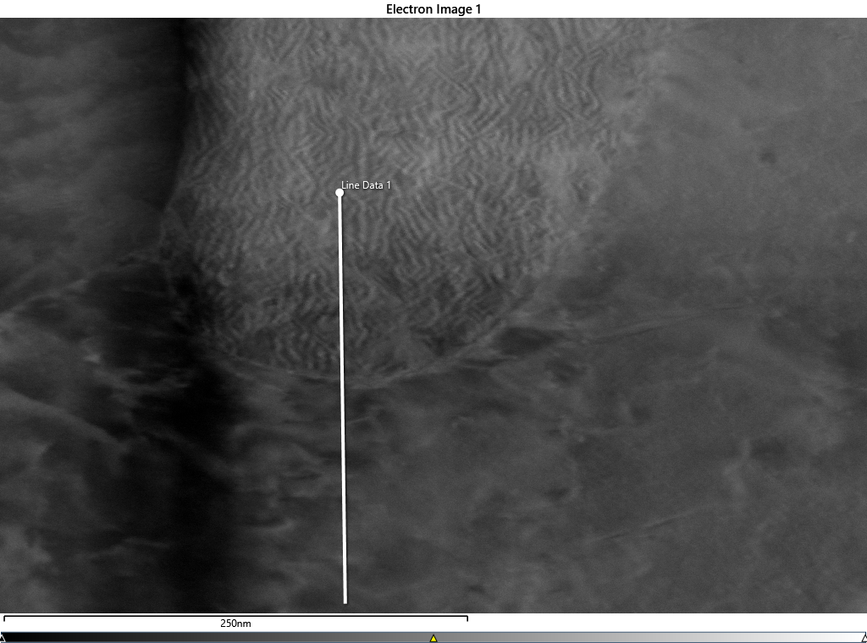
TEM/Phase boundary linescan/Project 2_phase boundary/RAC_phase boundary/1/Electron Image 1.tiff
