shortlab/2024-RadCor-Pb-316/Cross-section SEM and Fiji analysis/RAC 8hour/CO/subsurface.csv

Slice | Count | Total Area | Average Size | %Area
Fused_3.tif | 245 | 18742 | 76.498 | 14.209
