shortlab/2024-RadCor-Pb-316/Cross-section SEM and Fiji analysis/RAC 8hour/RAC/subsurface.csv

Slice | Count | Total Area | Average Size | %Area
Fused_3.tif | 405 | 21829 | 53.899 | 17.974
