shortlab/2024-RadCor-Pb-316/Cross-section SEM and Fiji analysis/RAC 4hour_2#/CO/subsurface.csv

Slice | Count | Total Area | Average Size | %Area
Fused_3.tif | 512 | 6728 | 13.141 | 4.966
