shortlab/2024-RadCor-Pb-316/Cross-section SEM and Fiji analysis/RAC 4hour_2#/RAC/subsurface.csv

Slice | Count | Total Area | Average Size | %Area
Fuse_3_1.tif | 619 | 14580 | 23.554 | 11.887
