shortlab/2024-RadCor-Pb-316/Cross-section SEM and Fiji analysis/RAC 4hour_1#/CO/subsurface.csv

Slice | Count | Total Area | Average Size | %Area
Fused_3.tif | 516 | 6178 | 11.973 | 4.695
