shortlab/2024-RadCor-Pb-316/Cross-section SEM and Fiji analysis/RAC 4hour_1#/RAC/subsurface.csv

Slice | Count | Total Area | Average Size | %Area
Fused_3.tif | 432 | 19462 | 45.051 | 14.632
