shortlab/2024-RadCor-Pb-316/CAD file/Round Lead Mold Assembly.stp

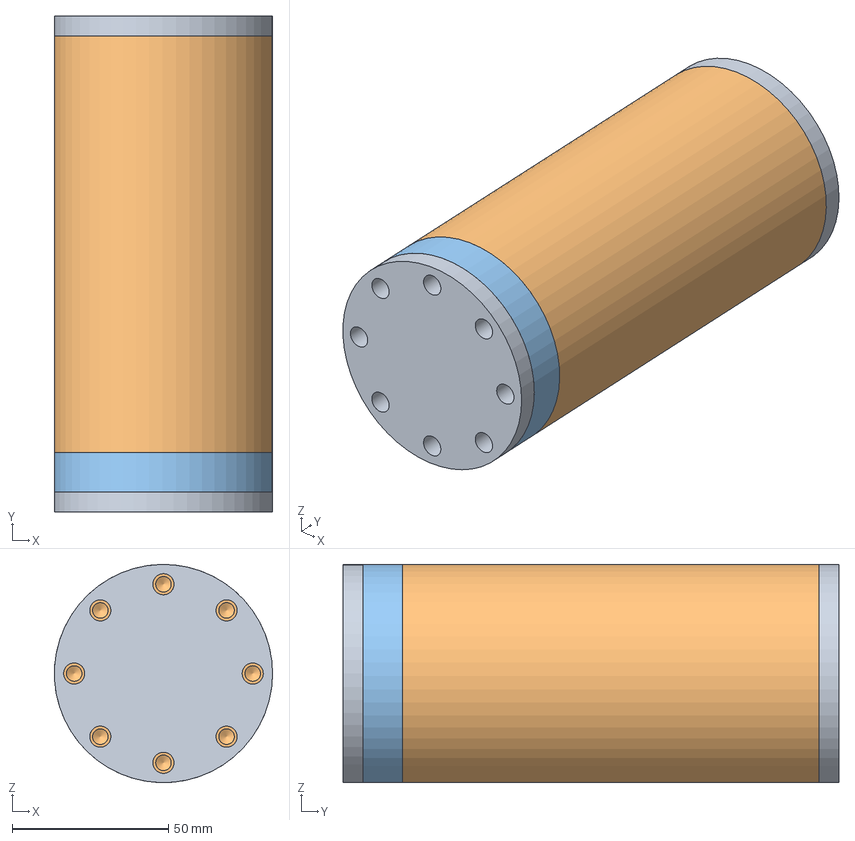
[picture p281: CAD file, 2024-10-03]
CAD file/Round Lead Mold Assembly.stp
69.8 x 158.7 x 69.8 mm
Round Bot Plate
Mold Assembly
Round Top Cover
Round Mid Plate
