shortlab/2024-RadCor-Pb-316/CAD file/Lead Purification Setup.stp

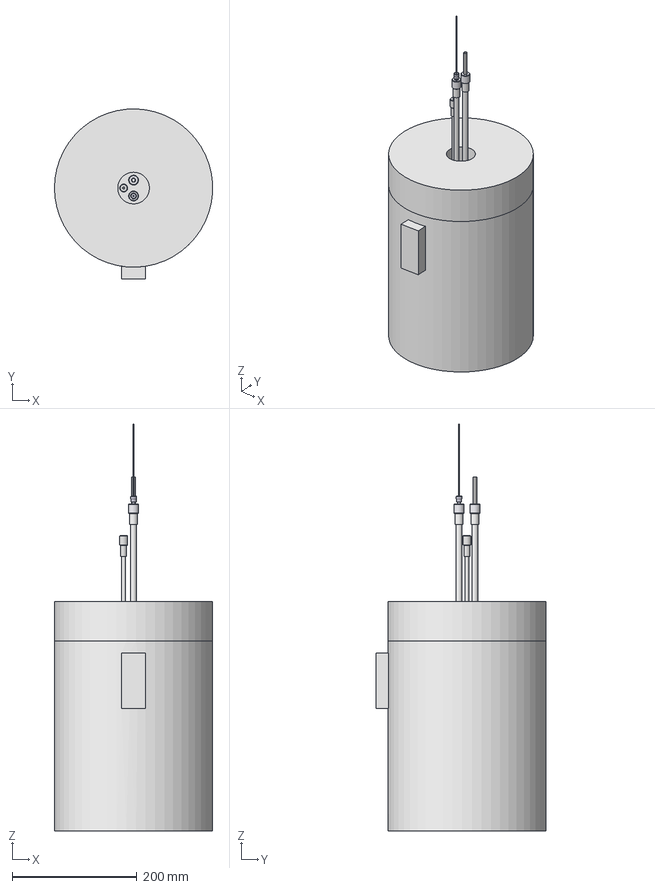
[picture p282: CAD file, 2024-10-03]
CAD file/Lead Purification Setup.stp
253.8 x 273.0 x 653.2 mm
f0337x000nt
P0001623
P0000157
P0000439
P0000494
f0337x000n
ThreeEighthTubing x 2
OneQuarterTubing
c0002181 x 2
p0001775 x 2
P0001706 x 2
p0001593 x 2
s-012-k
MoWireThin
SS-1-UT-A-4-SwagelokCompany-3D-10-28-2020
CC46Z from Almath
Mo Cap
Mo Tube
Furnace representation
Furnace Cap
