shortlab/2024-RadCor-Pb-316/CAD file/Corrosion Cell by threading_for_lead.stp

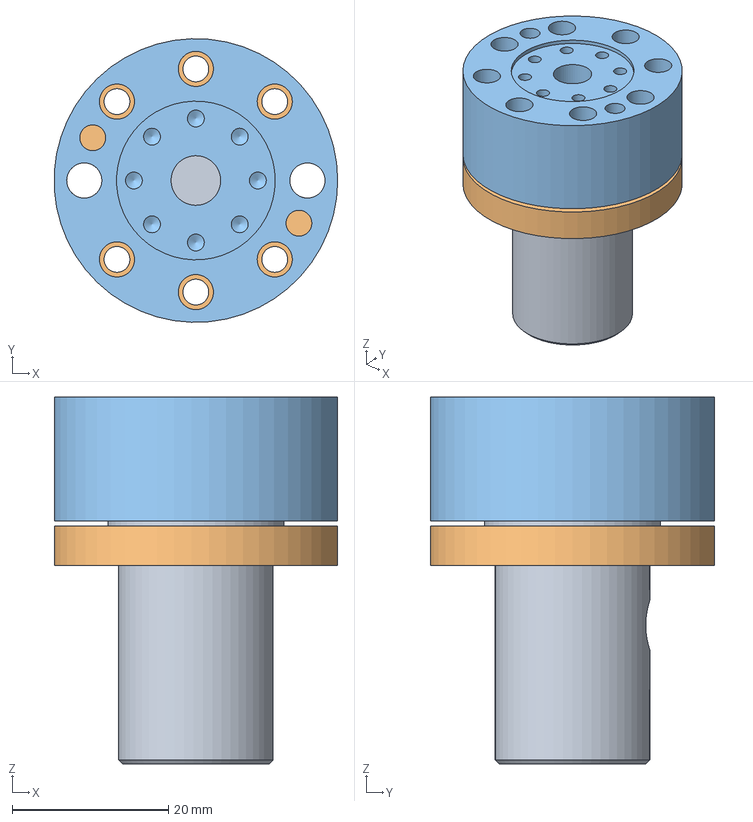
[picture p283: CAD file, 2024-10-03]
CAD file/Corrosion Cell by threading_for_lead.stp
36.3 x 36.3 x 47.0 mm
Salt_Chamber_Nickel_Part_2018_2
Inconel_Part_for_the_Chamber_2018_2
Inconel_Counter_Part_for_the_Chamber_2018_2
