shortlab/2024-RadCor-Pb-316/Cross-section SEM and Fiji analysis/RAC 8hour/CO/Results for CDF.csv

Row_by_Pixel | Uncorroded_Depth_by_Pixel | Thickness_by_Pixel | x_left_edge | x_right_edge | Corrosion_Depth_Ratio
0 | 0 | 253 | 54 | 306 | 0.000
1 | 0 | 253 | 54 | 306 | 0.000
2 | 0 | 253 | 54 | 306 | 0.000
3 | 0 | 253 | 54 | 306 | 0.000
4 | 0 | 253 | 54 | 306 | 0.000
5 | 0 | 253 | 54 | 306 | 0.000
6 | 0 | 253 | 54 | 306 | 0.000
7 | 0 | 253 | 54 | 306 | 0.000
8 | 0 | 253 | 54 | 306 | 0.000
9 | 0 | 253 | 54 | 306 | 0.000
10 | 0 | 253 | 54 | 306 | 0.000
11 | 0 | 253 | 54 | 306 | 0.000
12 | 0 | 253 | 54 | 306 | 0.000
13 | 0 | 253 | 54 | 306 | 0.000
14 | 0 | 253 | 54 | 306 | 0.000
15 | 0 | 253 | 54 | 306 | 0.000
16 | 0 | 253 | 54 | 306 | 0.000
17 | 245 | 253 | 54 | 306 | 0.032
18 | 243 | 253 | 54 | 306 | 0.040
19 | 234 | 253 | 54 | 306 | 0.075
20 | 233 | 253 | 54 | 306 | 0.079
21 | 232 | 253 | 54 | 306 | 0.083
22 | 232 | 253 | 54 | 306 | 0.083
23 | 232 | 253 | 54 | 306 | 0.083
24 | 232 | 253 | 54 | 306 | 0.083
25 | 232 | 253 | 54 | 306 | 0.083
26 | 232 | 253 | 54 | 306 | 0.083
27 | 233 | 253 | 54 | 306 | 0.079
28 | 233 | 253 | 54 | 306 | 0.079
29 | 234 | 253 | 54 | 306 | 0.075
30 | 235 | 253 | 54 | 306 | 0.071
31 | 236 | 253 | 54 | 306 | 0.067
32 | 236 | 253 | 54 | 306 | 0.067
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
