shortlab/2024-RadCor-Pb-316/Cross-section SEM and Fiji analysis/RAC 8hour/CO/Results for CDF.xlsx

Sheet: Results for CDF
Row_by_Pixel | Uncorroded_Depth_by_Pixel | Thickness_by_Pixel | x_left_edge | x_right_edge | Corrosion_Depth_Ratio
0 | 0 | 253 | 54 | 306 | 0
1 | 0 | 253 | 54 | 306 | 0
2 | 0 | 253 | 54 | 306 | 0
3 | 0 | 253 | 54 | 306 | 0
4 | 0 | 253 | 54 | 306 | 0
5 | 0 | 253 | 54 | 306 | 0
6 | 0 | 253 | 54 | 306 | 0
7 | 0 | 253 | 54 | 306 | 0
8 | 0 | 253 | 54 | 306 | 0
9 | 0 | 253 | 54 | 306 | 0
10 | 0 | 253 | 54 | 306 | 0
11 | 0 | 253 | 54 | 306 | 0
12 | 0 | 253 | 54 | 306 | 0
13 | 0 | 253 | 54 | 306 | 0
14 | 0 | 253 | 54 | 306 | 0
15 | 0 | 253 | 54 | 306 | 0
16 | 0 | 253 | 54 | 306 | 0
17 | 245 | 253 | 54 | 306 | 0
18 | 243 | 253 | 54 | 306 | 0
19 | 234 | 253 | 54 | 306 | 0
20 | 233 | 253 | 54 | 306 | 0
21 | 232 | 253 | 54 | 306 | 0
22 | 232 | 253 | 54 | 306 | 0
23 | 232 | 253 | 54 | 306 | 0
24 | 232 | 253 | 54 | 306 | 0
25 | 232 | 253 | 54 | 306 | 0
26 | 232 | 253 | 54 | 306 | 0
27 | 233 | 253 | 54 | 306 | 0
28 | 233 | 253 | 54 | 306 | 0
29 | 234 | 253 | 54 | 306 | 0
30 | 235 | 253 | 54 | 306 | 0
31 | 236 | 253 | 54 | 306 | 0
32 | 236 | 253 | 54 | 306 | 0
33 | 237 | 253 | 54 | 306 | 0
34 | 237 | 253 | 54 | 306 | 0
35 | 237 | 253 | 54 | 306 | 0
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
