shortlab/2024-RadCor-Pb-316/Cross-section SEM and Fiji analysis/RAC 8hour/RAC/Results for CDF.csv

Row_by_Pixel | Uncorroded_Depth_by_Pixel | Thickness_by_Pixel | x_left_edge | x_right_edge | Corrosion_Depth_Ratio
0 | 0 | 130 | 107 | 236 | 0.000
1 | 256 | 259 | 107 | 365 | 0.012
2 | 255 | 259 | 107 | 365 | 0.015
3 | 254 | 259 | 107 | 365 | 0.019
4 | 254 | 259 | 107 | 365 | 0.019
5 | 253 | 259 | 107 | 365 | 0.023
6 | 253 | 259 | 107 | 365 | 0.023
7 | 253 | 259 | 107 | 365 | 0.023
8 | 253 | 259 | 107 | 365 | 0.023
9 | 253 | 259 | 107 | 365 | 0.023
10 | 253 | 259 | 107 | 365 | 0.023
11 | 253 | 259 | 107 | 365 | 0.023
12 | 253 | 259 | 107 | 365 | 0.023
13 | 253 | 259 | 107 | 365 | 0.023
14 | 253 | 259 | 107 | 365 | 0.023
15 | 252 | 258 | 108 | 365 | 0.023
16 | 253 | 258 | 108 | 365 | 0.019
17 | 255 | 259 | 107 | 365 | 0.015
18 | 256 | 259 | 107 | 365 | 0.012
19 | 0 | 259 | 107 | 365 | 0.000
20 | 0 | 259 | 107 | 365 | 0.000
21 | 0 | 259 | 107 | 365 | 0.000
22 | 0 | 258 | 107 | 364 | 0.000
23 | 0 | 258 | 107 | 364 | 0.000
24 | 0 | 258 | 107 | 364 | 0.000
25 | 0 | 258 | 107 | 364 | 0.000
26 | 0 | 258 | 107 | 364 | 0.000
27 | 0 | 259 | 106 | 364 | 0.000
28 | 0 | 259 | 106 | 364 | 0.000
29 | 0 | 259 | 106 | 364 | 0.000
30 | 0 | 259 | 106 | 364 | 0.000
31 | 0 | 259 | 106 | 364 | 0.000
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
