shortlab/2024-RadCor-Pb-316/Cross-section SEM and Fiji analysis/RAC 8hour/RAC/Results for CDF.xlsx

Sheet: Results for CDF
Row_by_Pixel | Uncorroded_Depth_by_Pixel | Thickness_by_Pixel | x_left_edge | x_right_edge | Corrosion_Depth_Ratio
0 | 0 | 130 | 107 | 236 | 0
1 | 256 | 259 | 107 | 365 | 0
2 | 255 | 259 | 107 | 365 | 0
3 | 254 | 259 | 107 | 365 | 0
4 | 254 | 259 | 107 | 365 | 0
5 | 253 | 259 | 107 | 365 | 0
6 | 253 | 259 | 107 | 365 | 0
7 | 253 | 259 | 107 | 365 | 0
8 | 253 | 259 | 107 | 365 | 0
9 | 253 | 259 | 107 | 365 | 0
10 | 253 | 259 | 107 | 365 | 0
11 | 253 | 259 | 107 | 365 | 0
12 | 253 | 259 | 107 | 365 | 0
13 | 253 | 259 | 107 | 365 | 0
14 | 253 | 259 | 107 | 365 | 0
15 | 252 | 258 | 108 | 365 | 0
16 | 253 | 258 | 108 | 365 | 0
17 | 255 | 259 | 107 | 365 | 0
18 | 256 | 259 | 107 | 365 | 0
19 | 0 | 259 | 107 | 365 | 0
20 | 0 | 259 | 107 | 365 | 0
21 | 0 | 259 | 107 | 365 | 0
22 | 0 | 258 | 107 | 364 | 0
23 | 0 | 258 | 107 | 364 | 0
24 | 0 | 258 | 107 | 364 | 0
25 | 0 | 258 | 107 | 364 | 0
26 | 0 | 258 | 107 | 364 | 0
27 | 0 | 259 | 106 | 364 | 0
28 | 0 | 259 | 106 | 364 | 0
29 | 0 | 259 | 106 | 364 | 0
30 | 0 | 259 | 106 | 364 | 0
31 | 0 | 259 | 106 | 364 | 0
32 | 0 | 259 | 106 | 364 | 0
33 | 0 | 259 | 106 | 364 | 0
34 | 0 | 259 | 106 | 364 | 0
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
