shortlab/2024-RadCor-Pb-316/Cross-section SEM and Fiji analysis/RAC 4hour_2#/CO/Results for CDF.csv

Row_by_Pixel | Uncorroded_Depth_by_Pixel | Thickness_by_Pixel | x_left_edge | x_right_edge | Corrosion_Depth_Ratio
0 | 0 | 123 | 250 | 372 | 0.000
1 | 0 | 247 | 127 | 373 | 0.000
2 | 0 | 247 | 127 | 373 | 0.000
3 | 0 | 248 | 127 | 374 | 0.000
4 | 0 | 248 | 127 | 374 | 0.000
5 | 0 | 249 | 127 | 375 | 0.000
6 | 0 | 249 | 127 | 375 | 0.000
7 | 0 | 250 | 127 | 376 | 0.000
8 | 0 | 250 | 127 | 376 | 0.000
9 | 0 | 250 | 127 | 376 | 0.000
10 | 0 | 250 | 127 | 376 | 0.000
11 | 0 | 250 | 127 | 376 | 0.000
12 | 0 | 250 | 127 | 376 | 0.000
13 | 0 | 250 | 127 | 376 | 0.000
14 | 0 | 250 | 127 | 376 | 0.000
15 | 0 | 250 | 127 | 376 | 0.000
16 | 0 | 250 | 127 | 376 | 0.000
17 | 0 | 250 | 127 | 376 | 0.000
18 | 0 | 250 | 127 | 376 | 0.000
19 | 0 | 250 | 127 | 376 | 0.000
20 | 0 | 250 | 127 | 376 | 0.000
21 | 0 | 250 | 127 | 376 | 0.000
22 | 0 | 250 | 127 | 376 | 0.000
23 | 0 | 250 | 127 | 376 | 0.000
24 | 0 | 251 | 126 | 376 | 0.000
25 | 0 | 251 | 126 | 376 | 0.000
26 | 0 | 251 | 126 | 376 | 0.000
27 | 0 | 251 | 126 | 376 | 0.000
28 | 0 | 251 | 126 | 376 | 0.000
29 | 0 | 251 | 126 | 376 | 0.000
30 | 0 | 251 | 126 | 376 | 0.000
31 | 0 | 251 | 126 | 376 | 0.000
32 | 0 | 251 | 126 | 376 | 0.000
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
