shortlab/2024-RadCor-Pb-316/Cross-section SEM and Fiji analysis/RAC 4hour_2#/CO/Results for CDF.xlsx

Sheet: Results for CDF
Row_by_Pixel | Uncorroded_Depth_by_Pixel | Thickness_by_Pixel | x_left_edge | x_right_edge | Corrosion_Depth_Ratio
0 | 0 | 123 | 250 | 372 | 0
1 | 0 | 247 | 127 | 373 | 0
2 | 0 | 247 | 127 | 373 | 0
3 | 0 | 248 | 127 | 374 | 0
4 | 0 | 248 | 127 | 374 | 0
5 | 0 | 249 | 127 | 375 | 0
6 | 0 | 249 | 127 | 375 | 0
7 | 0 | 250 | 127 | 376 | 0
8 | 0 | 250 | 127 | 376 | 0
9 | 0 | 250 | 127 | 376 | 0
10 | 0 | 250 | 127 | 376 | 0
11 | 0 | 250 | 127 | 376 | 0
12 | 0 | 250 | 127 | 376 | 0
13 | 0 | 250 | 127 | 376 | 0
14 | 0 | 250 | 127 | 376 | 0
15 | 0 | 250 | 127 | 376 | 0
16 | 0 | 250 | 127 | 376 | 0
17 | 0 | 250 | 127 | 376 | 0
18 | 0 | 250 | 127 | 376 | 0
19 | 0 | 250 | 127 | 376 | 0
20 | 0 | 250 | 127 | 376 | 0
21 | 0 | 250 | 127 | 376 | 0
22 | 0 | 250 | 127 | 376 | 0
23 | 0 | 250 | 127 | 376 | 0
24 | 0 | 251 | 126 | 376 | 0
25 | 0 | 251 | 126 | 376 | 0
26 | 0 | 251 | 126 | 376 | 0
27 | 0 | 251 | 126 | 376 | 0
28 | 0 | 251 | 126 | 376 | 0
29 | 0 | 251 | 126 | 376 | 0
30 | 0 | 251 | 126 | 376 | 0
31 | 0 | 251 | 126 | 376 | 0
32 | 0 | 251 | 126 | 376 | 0
33 | 0 | 251 | 126 | 376 | 0
34 | 0 | 251 | 126 | 376 | 0
35 | 0 | 251 | 126 | 376 | 0
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
