shortlab/2024-RadCor-Pb-316/Cross-section SEM and Fiji analysis/RAC 4hour_2#/RAC/Results for CDF.csv

Row_by_Pixel | Uncorroded_Depth_by_Pixel | Thickness_by_Pixel | x_left_edge | x_right_edge | Corrosion_Depth_Ratio
0 | 0 | 108 | 285 | 392 | 0.000
1 | 0 | 247 | 146 | 392 | 0.000
2 | 0 | 247 | 146 | 392 | 0.000
3 | 237 | 247 | 146 | 392 | 0.040
4 | 0 | 247 | 146 | 392 | 0.000
5 | 0 | 247 | 146 | 392 | 0.000
6 | 0 | 247 | 146 | 392 | 0.000
7 | 0 | 247 | 146 | 392 | 0.000
8 | 0 | 247 | 146 | 392 | 0.000
9 | 0 | 247 | 146 | 392 | 0.000
10 | 0 | 247 | 146 | 392 | 0.000
11 | 0 | 246 | 146 | 391 | 0.000
12 | 219 | 246 | 146 | 391 | 0.110
13 | 221 | 246 | 146 | 391 | 0.102
14 | 221 | 246 | 146 | 391 | 0.102
15 | 0 | 246 | 146 | 391 | 0.000
16 | 0 | 246 | 146 | 391 | 0.000
17 | 0 | 246 | 146 | 391 | 0.000
18 | 0 | 246 | 146 | 391 | 0.000
19 | 0 | 246 | 146 | 391 | 0.000
20 | 0 | 246 | 146 | 391 | 0.000
21 | 0 | 246 | 146 | 391 | 0.000
22 | 0 | 246 | 146 | 391 | 0.000
23 | 0 | 246 | 146 | 391 | 0.000
24 | 245 | 246 | 146 | 391 | 0.004
25 | 0 | 246 | 146 | 391 | 0.000
26 | 0 | 246 | 146 | 391 | 0.000
27 | 0 | 246 | 146 | 391 | 0.000
28 | 0 | 246 | 146 | 391 | 0.000
29 | 0 | 246 | 146 | 391 | 0.000
30 | 0 | 246 | 146 | 391 | 0.000
31 | 245 | 246 | 146 | 391 | 0.004
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
