shortlab/2024-RadCor-Pb-316/Cross-section SEM and Fiji analysis/RAC 4hour_2#/RAC/Results for CDF.xlsx

Sheet: Results for CDF
Row_by_Pixel | Uncorroded_Depth_by_Pixel | Thickness_by_Pixel | x_left_edge | x_right_edge | Corrosion_Depth_Ratio
0 | 0 | 108 | 285 | 392 | 0
1 | 0 | 247 | 146 | 392 | 0
2 | 0 | 247 | 146 | 392 | 0
3 | 237 | 247 | 146 | 392 | 0
4 | 0 | 247 | 146 | 392 | 0
5 | 0 | 247 | 146 | 392 | 0
6 | 0 | 247 | 146 | 392 | 0
7 | 0 | 247 | 146 | 392 | 0
8 | 0 | 247 | 146 | 392 | 0
9 | 0 | 247 | 146 | 392 | 0
10 | 0 | 247 | 146 | 392 | 0
11 | 0 | 246 | 146 | 391 | 0
12 | 219 | 246 | 146 | 391 | 0
13 | 221 | 246 | 146 | 391 | 0
14 | 221 | 246 | 146 | 391 | 0
15 | 0 | 246 | 146 | 391 | 0
16 | 0 | 246 | 146 | 391 | 0
17 | 0 | 246 | 146 | 391 | 0
18 | 0 | 246 | 146 | 391 | 0
19 | 0 | 246 | 146 | 391 | 0
20 | 0 | 246 | 146 | 391 | 0
21 | 0 | 246 | 146 | 391 | 0
22 | 0 | 246 | 146 | 391 | 0
23 | 0 | 246 | 146 | 391 | 0
24 | 245 | 246 | 146 | 391 | 0
25 | 0 | 246 | 146 | 391 | 0
26 | 0 | 246 | 146 | 391 | 0
27 | 0 | 246 | 146 | 391 | 0
28 | 0 | 246 | 146 | 391 | 0
29 | 0 | 246 | 146 | 391 | 0
30 | 0 | 246 | 146 | 391 | 0
31 | 245 | 246 | 146 | 391 | 0
32 | 245 | 247 | 146 | 392 | 0
33 | 245 | 247 | 146 | 392 | 0
34 | 245 | 247 | 146 | 392 | 0
35 | 246 | 248 | 145 | 392 | 0
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
