shortlab/2024-RadCor-Pb-316/Cross-section SEM and Fiji analysis/RAC 4hour_1#/CO/Results for CDF.csv

Row_by_Pixel | Uncorroded_Depth_by_Pixel | Thickness_by_Pixel | x_left_edge | x_right_edge | Corrosion_Depth_Ratio
0 | 0 | 275 | 29 | 303 | 0
1 | 0 | 276 | 28 | 303 | 0
2 | 0 | 276 | 28 | 303 | 0
3 | 0 | 276 | 28 | 303 | 0
4 | 0 | 276 | 28 | 303 | 0
5 | 0 | 277 | 28 | 304 | 0
6 | 0 | 277 | 28 | 304 | 0
7 | 0 | 275 | 30 | 304 | 0
8 | 0 | 275 | 30 | 304 | 0
9 | 0 | 273 | 32 | 304 | 0
10 | 0 | 276 | 29 | 304 | 0
11 | 0 | 277 | 28 | 304 | 0
12 | 0 | 276 | 29 | 304 | 0
13 | 0 | 275 | 30 | 304 | 0
14 | 0 | 275 | 30 | 304 | 0
15 | 0 | 276 | 30 | 305 | 0
16 | 0 | 275 | 31 | 305 | 0
17 | 0 | 275 | 31 | 305 | 0
18 | 0 | 277 | 29 | 305 | 0
19 | 0 | 277 | 29 | 305 | 0
20 | 0 | 277 | 29 | 305 | 0
21 | 0 | 277 | 29 | 305 | 0
22 | 0 | 277 | 29 | 305 | 0
23 | 0 | 273 | 33 | 305 | 0
24 | 0 | 276 | 30 | 305 | 0
25 | 0 | 277 | 29 | 305 | 0
26 | 0 | 278 | 29 | 306 | 0
27 | 0 | 276 | 31 | 306 | 0
28 | 0 | 276 | 31 | 306 | 0
29 | 0 | 275 | 32 | 306 | 0
30 | 244 | 277 | 30 | 306 | 0
31 | 244 | 278 | 29 | 306 | 0
32 | 243 | 277 | 30 | 306 | 0
33 | 242 | 276 | 31 | 306 | 0
34 | 253 | 277 | 30 | 306 | 0
35 | 252 | 277 | 30 | 306 | 0
36 | 252 | 277 | 30 | 306 | 0
37 | 252 | 277 | 30 | 306 | 0
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
