shortlab/2024-RadCor-Pb-316/Cross-section SEM and Fiji analysis/RAC 4hour_1#/CO/Results for CDF_processed_data.csv

Row_by_Pixel | Corrosion_Depth_Ratio | Probability | Cumulative Prob
0 | 0 | 0.000107377 | 0.000107377
1 | 0 |  | 0.000214754
2 | 0 |  | 0.00032213
3 | 0 |  | 0.000429507
4 | 0 |  | 0.000536884
5 | 0 |  | 0.000644261
6 | 0 |  | 0.000751637
7 | 0 |  | 0.000859014
8 | 0 |  | 0.000966391
9 | 0 |  | 0.001073768
10 | 0 |  | 0.001181145
11 | 0 |  | 0.001288521
12 | 0 |  | 0.001395898
13 | 0 |  | 0.001503275
14 | 0 |  | 0.001610652
15 | 0 |  | 0.001718029
16 | 0 |  | 0.001825405
17 | 0 |  | 0.001932782
18 | 0 |  | 0.002040159
19 | 0 |  | 0.002147536
20 | 0 |  | 0.002254912
21 | 0 |  | 0.002362289
22 | 0 |  | 0.002469666
23 | 0 |  | 0.002577043
24 | 0 |  | 0.00268442
25 | 0 |  | 0.002791796
26 | 0 |  | 0.002899173
27 | 0 |  | 0.00300655
28 | 0 |  | 0.003113927
29 | 0 |  | 0.003221304
30 | 0 |  | 0.00332868
31 | 0 |  | 0.003436057
32 | 0 |  | 0.003543434
33 | 0 |  | 0.003650811
34 | 0 |  | 0.003758187
35 | 0 |  | 0.003865564
36 | 0 |  | 0.003972941
37 | 0 |  | 0.004080318
38 | 0 |  | 0.004187695
39 | 0 |  | 0.004295071
40 | 0 |  | 0.004402448
41 | 0 |  | 0.004509825
42 | 0 |  | 0.004617202
43 | 0 |  | 0.004724579
44 | 0 |  | 0.004831955
45 | 0 |  | 0.004939332
46 | 0 |  | 0.005046709
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
