shortlab/2024-RadCor-Pb-316/Cross-section SEM and Fiji analysis/RAC 4hour_1#/RAC/Results for CDF.csv

Row_by_Pixel | Corrosion_Depth_Ratio | prob. | cumulative prob
0 | 0 | 0.000104954 | 0.000104954
1 | 0 |  | 0.000209908
2 | 0 |  | 0.000314861
3 | 0 |  | 0.000419815
4 | 0 |  | 0.000524769
5 | 0 |  | 0.000629723
6 | 0 |  | 0.000734677
7 | 0 |  | 0.000839631
8 | 0 |  | 0.000944584
9 | 0 |  | 0.001049538
10 | 0 |  | 0.001154492
11 | 0 |  | 0.001259446
12 | 0 |  | 0.0013644
13 | 0 |  | 0.001469353
14 | 0 |  | 0.001574307
15 | 0 |  | 0.001679261
16 | 0 |  | 0.001784215
17 | 0 |  | 0.001889169
18 | 0 |  | 0.001994123
19 | 0 |  | 0.002099076
20 | 0 |  | 0.00220403
21 | 0 |  | 0.002308984
22 | 0 |  | 0.002413938
23 | 0 |  | 0.002518892
24 | 0 |  | 0.002623846
25 | 0 |  | 0.002728799
26 | 0 |  | 0.002833753
27 | 0 |  | 0.002938707
28 | 0 |  | 0.003043661
29 | 0 |  | 0.003148615
30 | 0 |  | 0.003253568
31 | 0 |  | 0.003358522
32 | 0 |  | 0.003463476
33 | 0 |  | 0.00356843
34 | 0 |  | 0.003673384
35 | 0 |  | 0.003778338
36 | 0 |  | 0.003883291
37 | 0 |  | 0.003988245
38 | 0 |  | 0.004093199
39 | 0 |  | 0.004198153
40 | 0 |  | 0.004303107
41 | 0 |  | 0.00440806
42 | 0 |  | 0.004513014
43 | 0 |  | 0.004617968
44 | 0 |  | 0.004722922
45 | 0 |  | 0.004827876
46 | 0 |  | 0.00493283
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
