shortlab/2024-RadCor-Pb-316/Cross-section SEM and Fiji analysis/RAC 4hour_1#/RAC/Results for CDF.xlsx

Sheet: Results for CDF
Row_by_Pixel | Uncorroded_Depth_by_Pixel | Thickness_by_Pixel | x_left_edge | x_right_edge | Corrosion_Depth_Ratio
0 | 0 | 0 | 0 | 0 | 0
1 | 0 | 0 | 0 | 0 | 0
2 | 0 | 30 | 112 | 141 | 0
3 | 0 | 86 | 112 | 197 | 0
4 | 0 | 141 | 112 | 252 | 0
5 | 0 | 197 | 112 | 308 | 0
6 | 0 | 225 | 112 | 336 | 0
7 | 0 | 225 | 112 | 336 | 0
8 | 0 | 225 | 112 | 336 | 0
9 | 0 | 226 | 112 | 337 | 0
10 | 0 | 226 | 112 | 337 | 0
11 | 0 | 226 | 112 | 337 | 0
12 | 0 | 226 | 112 | 337 | 0
13 | 0 | 226 | 112 | 337 | 0
14 | 0 | 226 | 112 | 337 | 0
15 | 0 | 226 | 112 | 337 | 0
16 | 0 | 227 | 112 | 338 | 0
17 | 0 | 227 | 112 | 338 | 0
18 | 0 | 227 | 112 | 338 | 0
19 | 0 | 227 | 112 | 338 | 0
20 | 0 | 227 | 112 | 338 | 0
21 | 0 | 227 | 112 | 338 | 0
22 | 0 | 227 | 112 | 338 | 0
23 | 0 | 228 | 112 | 339 | 0
24 | 0 | 228 | 112 | 339 | 0
25 | 0 | 228 | 112 | 339 | 0
26 | 0 | 228 | 112 | 339 | 0
27 | 0 | 228 | 112 | 339 | 0
28 | 0 | 228 | 112 | 339 | 0
29 | 0 | 229 | 112 | 340 | 0
30 | 0 | 229 | 112 | 340 | 0
31 | 0 | 229 | 112 | 340 | 0
32 | 0 | 229 | 112 | 340 | 0
33 | 0 | 229 | 112 | 340 | 0
34 | 0 | 229 | 112 | 340 | 0
35 | 0 | 229 | 112 | 340 | 0
36 | 0 | 230 | 112 | 341 | 0
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
