shortlab/2024-RadCor-Pb-316/CAD file/09042023 Mold Assembly Large Middle Plate.pdf

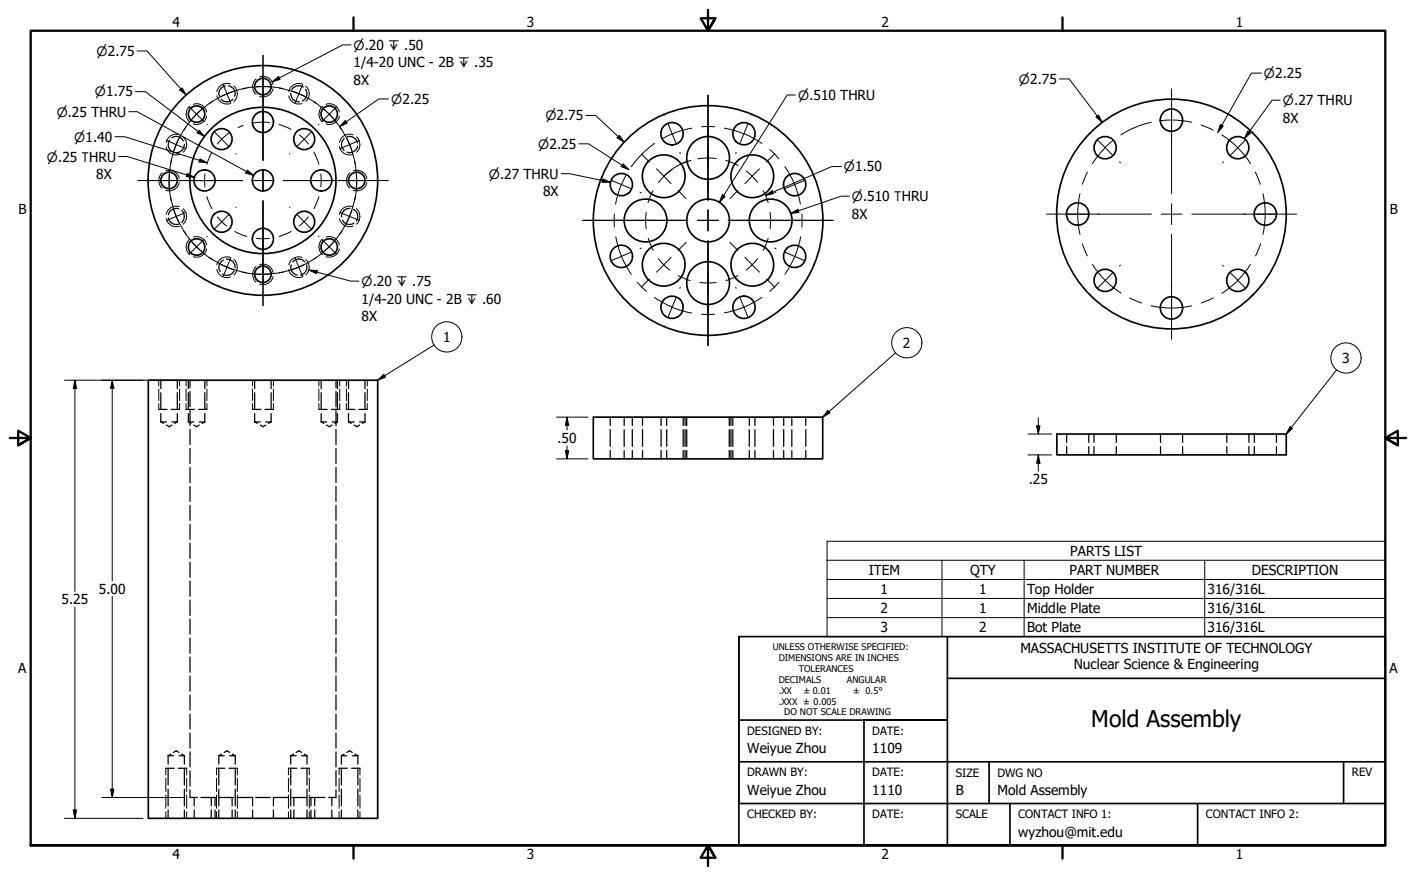
[picture p284: page 1]
PARTS LIST; Mold Assembly; ⌀.20 ↧ .50 1/4-20 UNC - 2B ↧ .35; ⌀.20 ↧ .75 1/4-20 UNC - 2B ↧ .60; ⌀.25 THRU; ⌀.27 THRU; ⌀.510 THRU

ITEM | QTY | PART NUMBER | DESCRIPTION
1 | 1 | Top Holder | 316/316L
2 | 1 | Middle Plate | 316/316L
3 | 2 | Bot Plate | 316/316L

UNLESS OTHERWISE SPECIFIED: DIMENSIONS ARE IN INCHES TOLERANCES DECIMALS ANGULAR .XX ± 0.01 ± 0.5° .XXX ± 0.005 DO NOT SCALE DRAWING DESIGNED BY: DATE: Weiyue Zhou 1109 | MASSACHUSETTS INSTITUTE OF TECHNOLOGY Nuclear Science & Engineering

DRAWN BY: DATE: Weiyue Zhou 1110 | SIZE B | DWG NO Mold Assembly | REV

CHECKED BY: DATE: | SCALE | CONTACT INFO 1: wyzhou@mit.edu | CONTACT INFO 2:
