shortlab/2024-RadCor-Pb-316/CAD file/Chamber by threading for lead.pdf

A

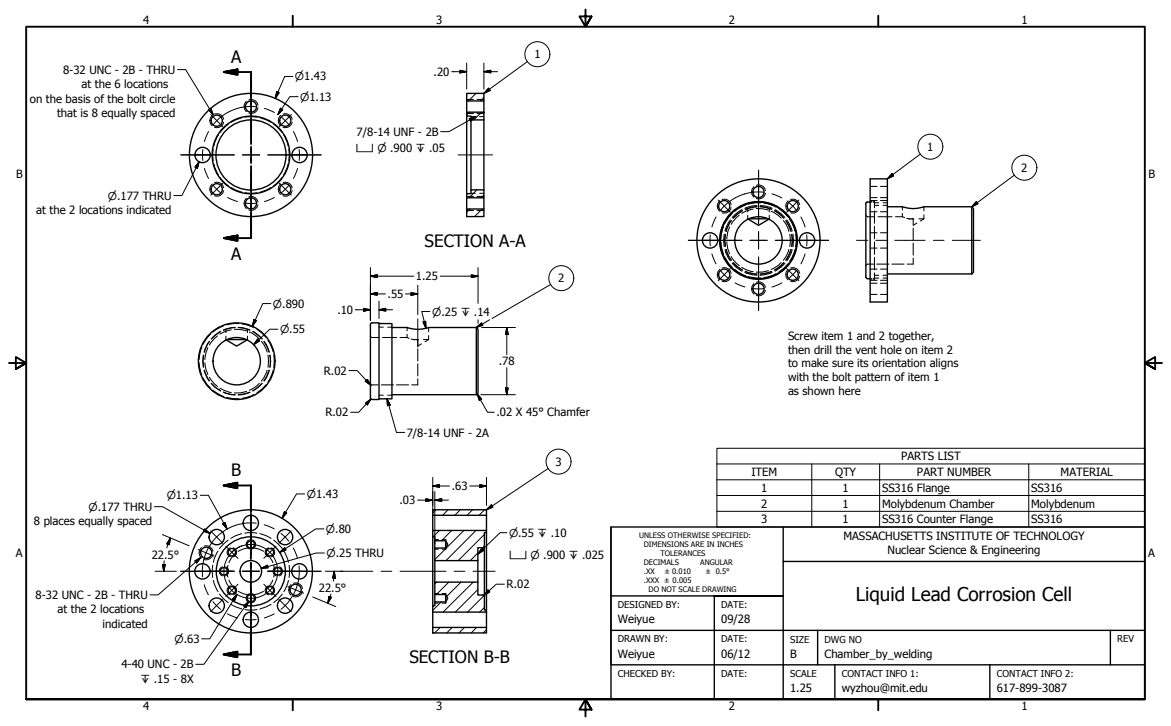
[picture p285: page 1]
SECTION B-B; SECTION A-A; PARTS LIST; ITEM; QTY; PART NUMBER; MATERIAL; SS316 Counter Flange; DECIMALS; ANGULAR; DRAWN BY: Weiyue; DESIGNED BY: Weiyue; CHECKED BY:; DATE: 09/28; DATE:; SIZE B; DWG NO; REV; Chamber_by_welding; SCALE; wyzhou@mit.edu; CONTACT INFO 1:; CONTACT INFO 2:; P.25 THRU; P.177 THRU; indicated; 4-40 UNC - 2B Z .15 - 8X; 7/8-14 UNF - 2B X P .900 Z .05; .02 X 45° Chamfer; 7/8-14 UNF - 2A

8-32 UNC - 2B - THRU
at the 6 locations

on the basis of the bolt circle
that is 8 equally spaced

at the 2 locations indicated

Screw item 1 and 2 together,
then drill the vent hole on item 2
to make sure its orientation aligns
with the bolt pattern of item 1
as shown here

1 | 1 | SS316 Flange | SS316
2 | 1 | Molybdenum Chamber | Molybdenum

8 places equally spaced

UNLESS OTHERWISE SPECIFIED:
DIMENSIONS ARE IN INCHES
TOLERANCES
.XXX ±
DO NOT SCALE DRAWING

MASSACHUSETTS INSTITUTE OF TECHNOLOGY

Nuclear Science & Engineering

at the 2 locations

Liquid Lead Corrosion Cell
