shortlab/2024-RadCor-Pb-316/(commit log)

2024-10-03 RAC 4hour_#1
    [Results for CDF.csv, Results for CDF.xlsx, Results for CDF_processed_data.csv, subsurface.csv]
2024-10-03 RAC 4hour_2#
    [Results for CDF.csv, Results for CDF.xlsx, subsurface.csv]
2024-10-03 RAC 8hour
    [Results for CDF.csv, Results for CDF.xlsx, subsurface.csv]
2024-10-03 CAD Files
    [Corrosion Cell by threading_for_lead.stp, Lead Purification Setup.stp, Round Lead Mold Assembly.stp]
